cskilbeck/xtl/esp8266/controller_esp8266/README.md

# ESP8266 Wifi Christmas Tree Lights firmware

I2S for Neopixel driver

Simple websocket client for listening to Alexa/STUN server

Not much else going on in here, all the effects/settings are the same
