cskilbeck/xtl/pcbs/buck3/Outputs/2019-12-01 Rev2/Reports2/buck3.html

Altium

# Design Rule Verification Report

Date: | | 01/12/2019
Time: | | 17:42:27
Elapsed Time: | | 00:00:01
Filename: | | C:\Dev\wifi-lights\pcbs\buck3\buck3.PcbDoc

Warnings: | | 0
Rule Violations: | | 0

## Summary

Warnings | Count
Total | 0

Rule Violations | Count
Clearance Constraint (Gap=15.748mil) (InNet('24V') Or InNet('VOUT')),(InNet('24V') Or InNet('VOUT')) | 0
Clearance Constraint (Gap=5mil) (IsStitchingVia and InNet('SGND')),((IsVia and (Not IsStitchingVia)) Or IsPad) | 0
Modified Polygon (Allow modified: No), (Allow shelved: No) | 0
Net Antennae (Tolerance=0mil) (All) | 0
Silk to Silk (Clearance=0mil) (All),(All) | 0
Minimum Solder Mask Sliver (Gap=2mil) (All),(All) | 0
Hole To Hole Clearance (Gap=10mil) (All),(All) | 0
Hole Size Constraint (Min=11.811mil) (Max=100mil) (All) | 0
Pads and Vias to follow the Drill pairs settings | 0
Height Constraint (Min=0mil) (Max=1000mil) (Prefered=500mil) (All) | 0
Component Clearance Constraint ( Horizontal Gap = 10mil, Vertical Gap = Infinite ) (All),(All) | 0
Routing Via (Templates Used To Check Via: GND_STITCH, v50h30m0mx0, v50h30mx0, v60h40m0mx0) (All) | 0
Routing Layers(All) | 0
Width Constraint (Min=5mil) (Max=50mil) (Preferred=5mil) (All) | 0
Power Plane Connect Rule(Direct Connect )(Expansion=20mil) (Conductor Width=10mil) (Air Gap=10mil) (Entries=4) (All) | 0
Clearance Constraint (Gap=5mil) (All),(All) | 0
Un-Routed Net Constraint ( (All) ) | 0
Short-Circuit Constraint (Allowed=Yes) (InNet('GND')),(InNet('SGND')) | 0
Board Clearance Constraint (Gap=0mil) (All) | 0
Board Clearance Constraint (Gap=0mil) (OnLayer('Top Overlay') or OnLayer('Bottom Overlay')) | 0
Clearance Constraint (Gap=7.874mil) (InNet('SW') Or InNet('24V') Or InNet('VOUT') Or InNet('?DRV') Or InNet('GND') Or InNet('SGND')),(InNet('SW') Or InNet('GND') Or InNet('SGND') Or InNet('24V') Or InNet('VOUT') Or InNet('?DRV')) | 0
Minimum Annular Ring (Minimum=3mil) (All) | 0
Clearance Constraint (Gap=10mil) (InNet('HDRV') Or InNet('LDRV') Or InNet('SW')),(InNet('HDRV') Or InNet('LDRV') Or InNet('SW')) | 0
Clearance Constraint (Gap=5mil) (IsStitchingVia and InNet('GND')),((IsVia and (Not IsStitchingVia)) Or IsPad) | 0
Total | 0
