cskilbeck/xtl/pcbs/buck3/Outputs/2019-12-16 Rev2/Reports/buck3.html

Altium

# Design Rule Verification Report

Date: | | 16/12/2019
Time: | | 18:55:18
Elapsed Time: | | 00:00:01
Filename: | | C:\Dev\wifi-lights\pcbs\buck3\buck3.PcbDoc

Warnings: | | 0
Rule Violations: | | 0

## Summary

Warnings | Count
Total | 0

Rule Violations | Count
Clearance Constraint (Gap=0.4mm) (InNet('24V') Or InNet('VOUT')),(InNet('24V') Or InNet('VOUT')) | 0
Clearance Constraint (Gap=0.127mm) (IsStitchingVia and InNet('SGND')),((IsVia and (Not IsStitchingVia)) Or IsPad) | 0
Modified Polygon (Allow modified: No), (Allow shelved: No) | 0
Net Antennae (Tolerance=0mm) (All) | 0
Silk to Silk (Clearance=0mm) (All),(All) | 0
Minimum Solder Mask Sliver (Gap=0.051mm) (All),(All) | 0
Hole To Hole Clearance (Gap=0.254mm) (All),(All) | 0
Hole Size Constraint (Min=0.3mm) (Max=3mm) (All) | 0
Pads and Vias to follow the Drill pairs settings | 0
Height Constraint (Min=0mm) (Max=25.4mm) (Prefered=12.7mm) (All) | 0
Component Clearance Constraint ( Horizontal Gap = 0.254mm, Vertical Gap = Infinite ) (All),(All) | 0
Routing Via (MinHoleWidth=0.3mm) (MaxHoleWidth=1mm) (PreferredHoleWidth=0.3mm) (MinWidth=0.5mm) (MaxWidth=1mm) (PreferedWidth=0.5mm) (All) | 0
Routing Layers(All) | 0
Width Constraint (Min=0.127mm) (Max=1.27mm) (Preferred=0.127mm) (All) | 0
Power Plane Connect Rule(Direct Connect )(Expansion=0.508mm) (Conductor Width=0.254mm) (Air Gap=0.254mm) (Entries=4) (All) | 0
Clearance Constraint (Gap=0.127mm) (All),(All) | 0
Un-Routed Net Constraint ( (All) ) | 0
Short-Circuit Constraint (Allowed=Yes) (InComponentClass('gnd_ties')),(All) | 0
Board Clearance Constraint (Gap=0mm) (All) | 0
Board Clearance Constraint (Gap=0mm) (OnLayer('Top Overlay') or OnLayer('Bottom Overlay')) | 0
Clearance Constraint (Gap=0.18mm) (InNet('SW') Or InNet('24V') Or InNet('VOUT') Or InNet('?DRV') Or InNet('GND') Or InNet('SGND')),(InNet('SW') Or InNet('GND') Or InNet('SGND') Or InNet('24V') Or InNet('VOUT') Or InNet('?DRV')) | 0
Minimum Annular Ring (Minimum=0.076mm) (All) | 0
Clearance Constraint (Gap=0.254mm) (InNet('HDRV') Or InNet('LDRV') Or InNet('SW')),(InNet('HDRV') Or InNet('LDRV') Or InNet('SW')) | 0
Clearance Constraint (Gap=0.127mm) (IsStitchingVia and InNet('GND')),((IsVia and (Not IsStitchingVia)) Or IsPad) | 0
Clearance Constraint (Gap=0mm) (InComponentClass('gnd_ties')),(All) | 0
Total | 0
