cskilbeck/xtl/pcbs/buck4/Outputs/2020-06-03/back.png

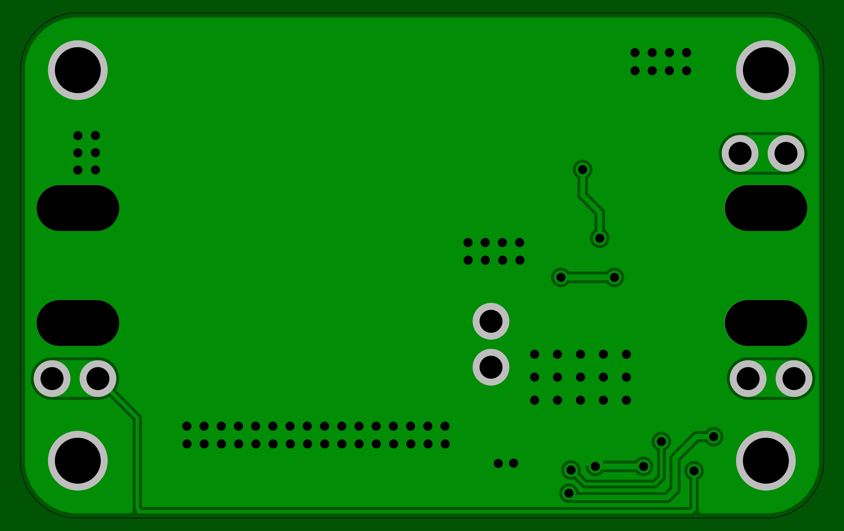
pcbs/buck4/Outputs/2020-06-03/back.png
