cskilbeck/xtl/pcbs/buck4/Outputs/2020-06-22/bottom.png

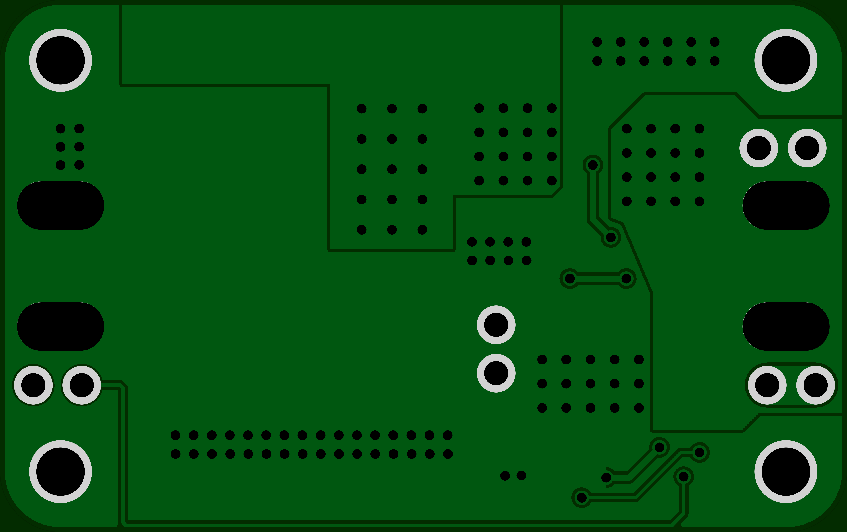
pcbs/buck4/Outputs/2020-06-22/bottom.png
