cskilbeck/xtl/pcbs/buck4/Outputs/2020-07-28/top.png

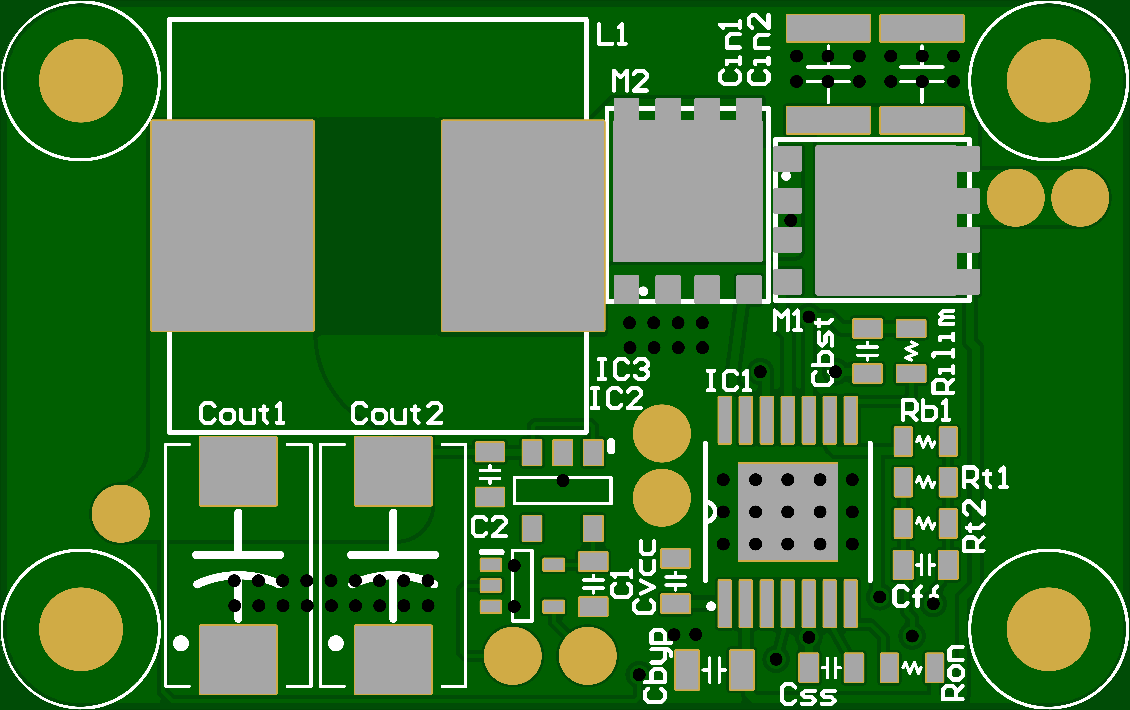
pcbs/buck4/Outputs/2020-07-28/top.png
