cskilbeck/xtl/pcbs/controller/ti_54328.png

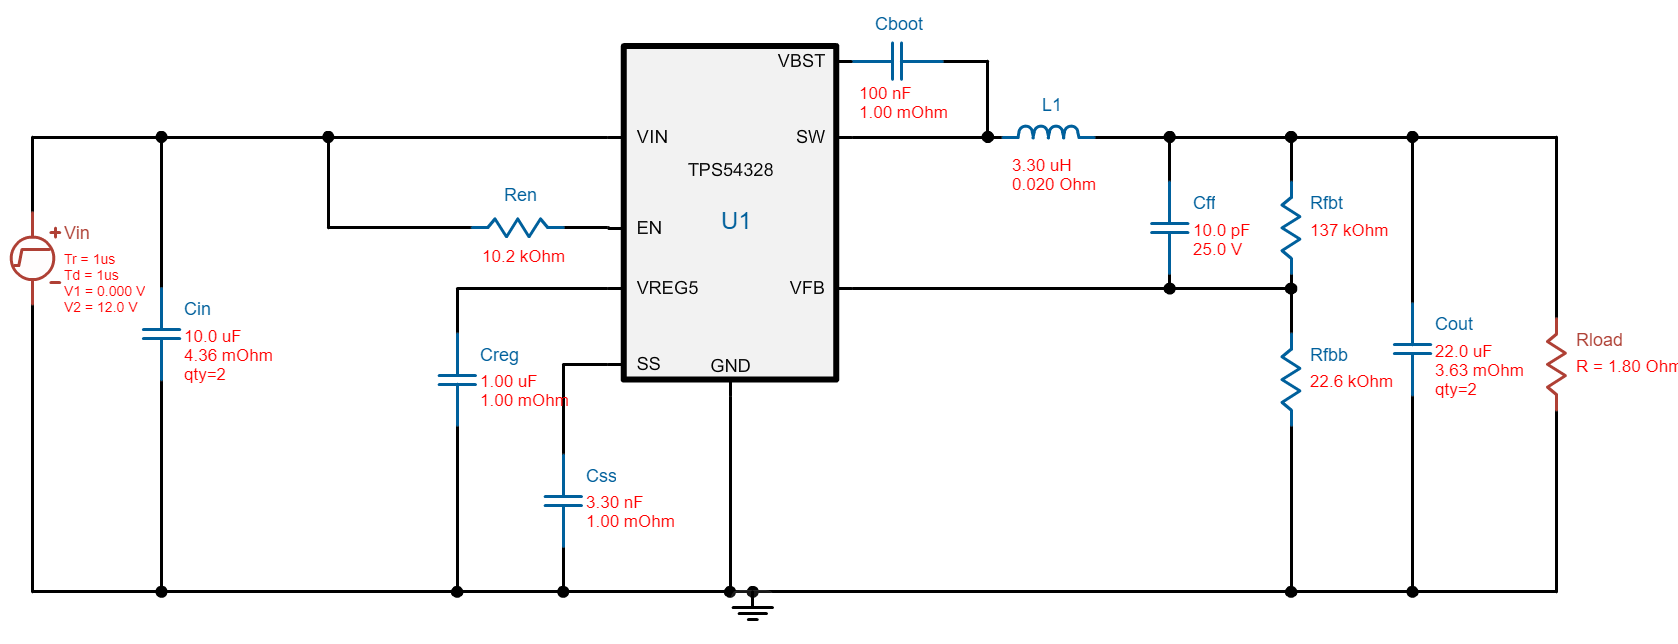
pcbs/controller/ti_54328.png
