cskilbeck/xtl/pcbs/controller_8266/Outputs/2020-08-14/top.png

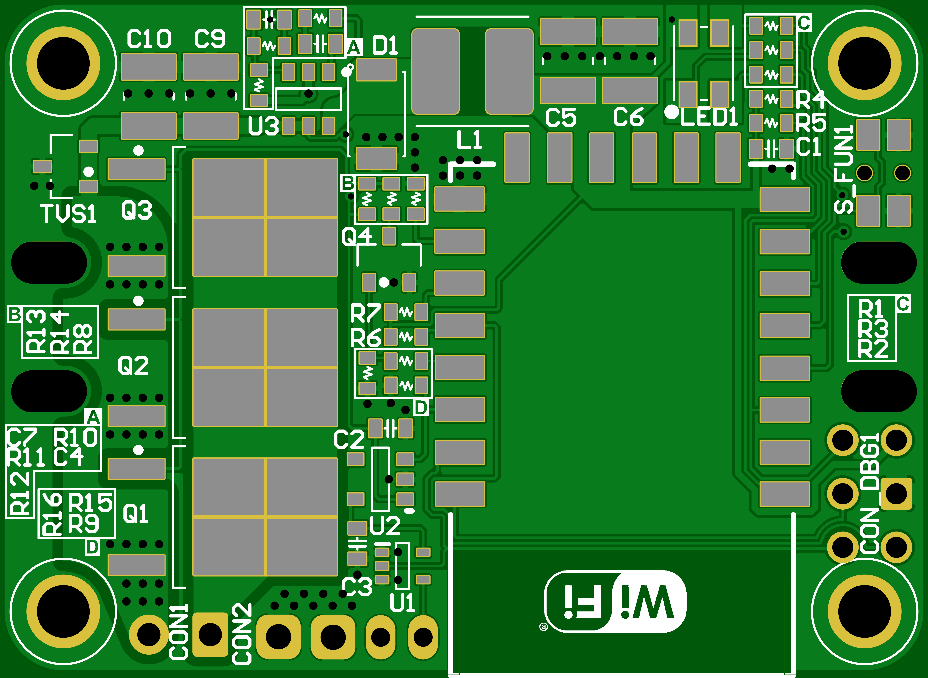
pcbs/controller_8266/Outputs/2020-08-14/top.png
