cskilbeck/xtl/pcbs/controller_8266/top.png

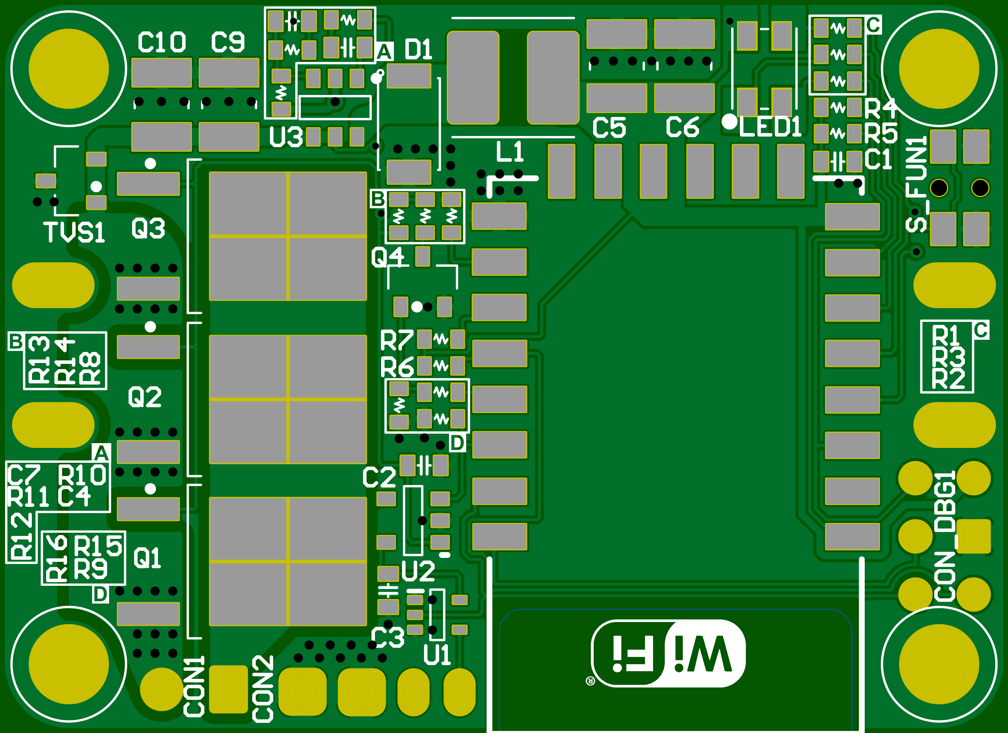
pcbs/controller_8266/top.png
