cskilbeck/xtl/pcbs/buck2/bom.xlsx

Part | Manufacturer | Part Number |  | Quantity | Price | Attribute 1 Name | Attribute 1 Value | Attribute 2 Name | Attribute 2 Value | Attribute 3 Name | Attribute 3 Value | Footprint
Cboot | MuRata | GRM155R71A104KA01D | x | 1 | 0.01 | Cap | 100nF | ESR | 1mOhm | Total Derated Cap | 1.0E-7F | 402 | 20
Ccomp | TDK | C2012C0G1H152K060AA | x | 1 | 0.027 | Cap | 1.5nF | ESR | 0Ohm | Total Derated Cap | 1.5E-9F | 805 | 20
Ccomp2 | Yageo | CC0201JRNPO8BN270 | x | 1 | 0.01 | Cap | 27pF | ESR | 0Ohm | Total Derated Cap | 2.7E-11F | 201 | 50
Cin | TDK | C3225X7R1H106M250AC | x | 2 | 0.571 | Cap | 10uF | ESR | 1mOhm | Total Derated Cap | 1.1E-5F | 1210 | 2
Cout | TDK | C3216X5R1A107M160AC | D | 2 | 0.628 | Cap | 100uF | ESR | 2.838mOhm | Total Derated Cap | 8.5E-5F | 1206_190 | 5
Css | MuRata | GRM033R71A822KA01D | x | 1 | 0.01 | Cap | 8.2nF | ESR | 1mOhm | Total Derated Cap | 8.2E-9F | 201 | 50
D1 | Comchip Technology | CDBC540-G | x | 1 | 0.245 | VFatIo | 0.55V | Io | 5A | VRRM | 40V | SMC | 1
L1 | Bourns | SDR1307-6R8ML | x | 1 | 0.345 | L | 6.8uH | DCR | 0.017Ohm | IDC | 6A | SDR1307 | 1
Rcomp | Yageo | RC0201FR-0744K2L |  | 1 | 0.01 | Resistance | 44.2kOhm | Tolerance | 1% | Power | 0.05W | 201 | 100
Rfbb | Vishay-Dale | CRCW08051K65FKEA |  | 1 | 0.01 | Resistance | 1.65kOhm | Tolerance | 1% | Power | 0.125W | 805 | 100
Rfbt | Vishay-Dale | CRCW060310K2FKEA |  | 1 | 0.01 | Resistance | 10.2kOhm | Tolerance | 1% | Power | 0.1W | 603 | 100
U1 | Texas Instruments | TPS54531DDAR | x | 1 | 0.75 |  |  |  |  |  |  | DDA0008E | 4
