cskilbeck/xtl/pcbs/controller_8266/Outputs/2024-12-30/Bill of Materials-controller_8266.xlsx

Designator | Quantity | Value | Name | Description | Footprint | Model:Footprint | LibRef
C1, C3 | 2 | 1uF | Cap | Capacitor | CAPC_0603_1608X08L | Chip Capacitor 0603 | Cap
C2, C33 | 2 | 100nF | Cap | Capacitor | CAPC_0603_1608X08L | Chip Capacitor 0603 | Cap
C37, C38, C40, C41 | 4 | 22uF | Cap | Capacitor | CAPC_1206_3216X16L | Chip Capacitor 1206 | Cap
C42 | 1 | 100pF | Cap | Capacitor | CAPC_0603_1608X08L | Chip Capacitor 0603 | Cap
D1 | 1 |  | Schottky 40V 3A | Schottky Diode | SOD123 | SOD123 | D Schottky
D2 | 1 |  | TVS | Schottky Diode | SODFL350X120-2L | SODFL, 2-Leads, Body 1.60x3.50mm, IPC High Density | D Zener
ESP1 | 1 |  | ESP8266 ESP-12-E | ESP8266 ESP-12-E | ESP8266 ESP-12-E | ESP8266 ESP-12-E | ESP8266 ESP-12-E
L2 | 1 | 15uH | Inductor | Inductor | INDP4949X30N | Precision Wire Wound Inductor, 2-Leads, Body 4.90x4.90mm, IPC Medium Density | Inductor
LED1 | 1 |  | RGB LED Common anode | Dot is _not_ anode! | PLCC-4 | LED | RGB_LED
Q1, Q2, Q3 | 3 |  | MOSFET-P |  | DPAK229P994X241-3L | D-PAK, 3-Pads, Body 6.21x6.73mm (max), IPC High Density | MOSFET-P
Q4 | 1 |  | MOSFET-N |  | SOT23 | SOT23, 3-Leads, Body 2.90x2.45mm, Pitch 0.95mm, IPC High Density | MOSFET-N
R1, R2, R3, R4, R5, R14 | 6 | 10K | Res2 | Resistor | RESC_0603_1608X08L | Chip Resistor, 2-Leads, Body 1.60x0.80mm, IPC High Density | Res2
R6, R7, R8, R9, R13 | 5 | 1K | Res2 | Resistor | RESC_0603_1608X08L | Chip Resistor, 2-Leads, Body 1.60x0.80mm, IPC High Density | Res2
R11 | 1 | 220K | Res2 | Resistor | RESC_0603_1608X08L | Chip Resistor, 2-Leads, Body 1.60x0.80mm, IPC High Density | Res2
R12 | 1 | 100K | Res2 | Resistor | RESC_0603_1608X08L | Chip Resistor, 2-Leads, Body 1.60x0.80mm, IPC High Density | Res2
R29 | 1 | 2.4K | Res2 | Resistor | RESC_0603_1608X08L | Chip Resistor, 2-Leads, Body 1.60x0.80mm, IPC High Density | Res2
R30 | 1 | 680R | Res2 | Resistor | RESC_0603_1608X08L | Chip Resistor, 2-Leads, Body 1.60x0.80mm, IPC High Density | Res2
S_FUN1 | 1 |  | 4-1437565-1 | Tactile switch | EVQP7C01P | Side actuated tactile switch | 4-1437565-1
U1 | 1 |  | M74VHC1GT125 | Level shifter non inverting | SOT95P285X130-5N | SOT23, 5-Leads, Body 3.00x2.85mm, Pitch 0.95mm, IPC Medium Density | M74VHC1GT125
U2 | 1 |  | AP7383-50W5 |  | SOT95P285X130-5N | SOT23, 5-Leads, Body 3.00x2.85mm, Pitch 0.95mm, IPC Medium Density | AP7383-50W5
U3 | 1 |  | BD9G101G-LB |  | TSOP95P280X125-6L | TSOP, 6-Leads, Body 2.90x1.65mm, Pitch 0.95mm, IPC High Density | BD9G102G-LB
