cskilbeck/xtl/pcbs/buck4/Outputs/2020-07-28/Bill of Materials-buck4 assembly.xlsx

Designator | Quantity | Value | Name | Footprint | Description | Voltage
C1, C2 | 2 | 1uF | MLCC | CAPC1608X08L | Multilayer Ceramic Capacitor | 16V
Cbst | 1 | 470nF | MLCC | CAPC1608X08L | Multilayer Ceramic Capacitor | 25V
Cbyp | 1 | 100nF | MLCC | CAPC2012X12L | Multilayer Ceramic Capacitor | 25V
Cff | 1 | 100pF | MLCC | CAPC1608X08L | Multilayer Ceramic Capacitor | 6.3V
Cin1, Cin2 | 2 | 47uF | MLCC | CAPC3225X25L | Multilayer Ceramic Capacitor | 25V
Cout1, Cout2 | 2 | 47uF | CAPACITOR | CAPMP7343X11L | Electrolytic Capacitor | 6.3V
Css | 1 | 68nF | MLCC | CAPC1608X08L | Multilayer Ceramic Capacitor | 25V
Cvcc | 1 | 2.2uF | MLCC | CAPC1608X08L | Multilayer Ceramic Capacitor | 16V
IC1 | 1 |  | LM3150MH/NOPB | MXA14A | Buck controller
IC2 | 1 |  | M74VHC1GT125 | SOT65P210X100-5L | Level shifter non inverting
IC3 | 1 |  | NCP551 | SOT95P260X90-5L | 5V LDO
L1 | 1 | 6.8uH | 744313330 | WE-HCI_1335 | Inductor
M1 | 1 |  | STL90N6F7 | TRANS_NexFET_Q5A | N Channel MOSFET
M2 | 1 |  | STL90N6F7 | TRANS_NexFET_Q5A | N Channel MOSFET
Rb1 | 1 | 10K | RES0603 | RESC1608X03L | Chip Resistor
RiLim | 1 | 2.21K | RES0603 | RESC1608X03L | Chip Resistor
Ron | 1 | 240k | RES0603 | RESC1608X03L | Chip Resistor
Rt1 | 1 | 91k | RES0603 | RESC1608X03L | Chip Resistor
Rt2 | 1 | 3M | RES0603 | RESC1608X03L | Chip Resistor
