cskilbeck/xtl/pcbs/buck3/Outputs/2019-06-22 Rev2/BOM/BOM-buck3.xlsx

Description | Designator | Quantity | Value | Footprint
Capacitor | C1, C2 | 2 | 330uF | CAPAE5252X59N
Capacitor | C3 | 1 | 6.8pF | CAPC 0603 1608X05L
Capacitor | C4, C7 | 2 | 100nF | CAPC 0603 1608X05L
Capacitor | C5 | 1 | 1.5pF | CAPC 0603 1608X05L
Capacitor | C6 | 1 | 3.3nF | CAPC 0603 1608X05L
Capacitor | C8 | 1 | 100pF | CAPC 0603 1608X05L
Capacitor | C9, C10 | 2 | 1uF | CAPC 0603 1608X05L
Capacitor | C11 | 1 | 68pF | CAPC 0603 1608X05L
Capacitor | C12, C13 | 2 | 22uF | CAPC 1210
Capacitor | C14, C15 | 2 | 4.7uF | CAPC 1210
Capacitor | C16 | 1 | 180uF | CAPAE5252X59N
Inductor | L1 | 1 | 6.8uH | INDUCTOR 8040
N Channel MOSFET | Q1, Q2 | 2 | Infineon BSC093N04LSGATMA1 | INF-PG-TDSON-8-1_V
Resistor | R1 | 1 | 92K | RESC 0603 1608X05L
Resistor | R2 | 1 | 1M | RESC 0603 1608X05L
Resistor | R3 | 1 | 1K | RESC 0603 1608X05L
Resistor | R4 | 1 | 57K | RESC 0603 1608X05L
Resistor | R5 | 1 | 11K | RESC 0603 1608X05L
Resistor | R6 | 1 | 24K | RESC 0603 1608X05L
Resistor | R7 | 1 | 15K | RESC 0603 1608X05L
Resistor | R8 | 1 | 110K | RESC 0603 1608X05L
Buck Controller | U1 | 1 | TPS40057 | TSOP65P640X120_HS-17N
