cskilbeck/xtl/pcbs/buck3/Outputs/2019-12-01 Rev2/Reports/BOM-buck3.xlsx

Description | Designator | Quantity | Value | Footprint
Capacitor | C2 | 1 | 470uF | CAPAE10083X104N
Capacitor | C3 | 1 | 180pF | CAPC 0603 1608X05L
Capacitor | C4, C7 | 2 | 100nF | CAPC 0603 1608X05L
Capacitor | C5 | 1 | 12pF | CAPC 0603 1608X05L
Capacitor | C6 | 1 | 3.3nF | CAPC 0603 1608X05L
Capacitor | C8 | 1 | 100pF | CAPC 0603 1608X05L
Capacitor | C9, C10 | 2 | 1uF | CAPC 0603 1608X05L
Capacitor | C11 | 1 | 150pF | CAPC 0603 1608X05L
Capacitor | C12, C13, C14, C15 | 4 | 22uF | CAPC 1210
Capacitor | C16 | 1 | 220uF | CAPAE10083X104N
Inductor | L1 | 1 | 6.8uH | INDP125125X80L
N Channel MOSFET | Q1, Q2 | 2 | Infineon BSC093N04LSGATMA1 | INF-PG-TDSON-8-1_V
Resistor | R1 | 1 | 170K | RESC 0603 1608X05L
Resistor | R2 | 1 | 110k | RESC 0603 1608X05L
Resistor | R3 | 1 | 1K | RESC 0603 1608X05L
Resistor | R4 | 1 | 57K | RESC 0603 1608X05L
Resistor | R5 | 1 | 11K | RESC 0603 1608X05L
Resistor | R6 | 1 | 8.2k | RESC 0603 1608X05L
Resistor | R7 | 1 | 16K | RESC 0603 1608X05L
Resistor | R8 | 1 | 120K | RESC 0603 1608X05L
Resistor | R9 | 1 | 2r0 | RESC 0603 1608X05L
Buck Controller | U1 | 1 | TPS40057 | TSOP65P640X120_HS-17N
