cskilbeck/xtl/pcbs/buck3/TPS40KType III Loop Stability kVenable_sluc263c-071312_test1_20171102.xls

Sheet: Instructions
Using this spreadsheet
 | This spreadsheet will help the engineer calculate the compensation network for a voltage mode continuous current non isolated buck converter using type III compensation network.
 | Getting Started:
1 | Ensure Tools => Add Ins => Analysis ToolPak is selected otherwise spreadsheet will not work
2 | Green Cells show where manually entered data is placed
3 | White cells are the calculated results
4 | Blue cells are the final results for the design and plots

Sheet: Input and Results
See "Instructions" sheet for details on using this spreadsheet. |  |  |  |  |  |  |  |  |  |  |  |  |  |  |  |  |  |  |  |  |  |  | Resistors |  |  |  | Capacitors
 |  |  |  |  |  |  |  |  |  |  |  |  |  |  |  |  | IC Parameters (from data sheet)
PSU Parameters |  |  |  |  | Calculated Zero's, Pole's, R's and C's: |  |  |  | Manually enter |  |  | Power Train Poles and Zeros |  |  |  |  | P/N | VRAMP | VREF | GBWP | DCGAIN |  | R_2 | 7035.177 | 715.00 | 7150 | C_1 | 177.460 | 1.80 | 180
VIN | 24 | V |  |  |  |  |  |  | R's & C's: | No |  | LC Double Pole | 6.937 | kHz |  |  |  | V | V | MHz | dB |  | R_3 | 117153.505 | 115.00 | 115000 | C_2 | 192.428 | 1.80 | 180
VOUT | 5.95 | V |  |  | Fz_1 | 7059.871315 Hz | R_1 | 120000 Ω | 120000 | W |  | Electrolytic ESR Zero | 78.02 | kHz |  |  | TPS40007 | 0.87 | 0.7 | 5 | 55 |  | R_bias | 16000.000 | 160.00 | 16000 | C_3 | 11.281 | 1.20 | 12
IOUT_max | 3 | A |  |  | Fz_2 | 7059.871315 Hz | R_2 | 7035.177498 Ω | 7000 | W |  | Ceramic ESR Zero | 11287.585 | kHz |  |  | TPS40009 | 0.87 | 0.7 | 5 | 55 |  |  |  |  |  | C values up to 10nF |  | 1.50
Fco | 30 | kHz |  |  | Fp_1 | 127481.0772 Hz | R_3 | 117153.5053 Ω | 115000 | W |  |  |  |  |  |  | TPS40021 | 0.87 | 0.7 | 5 | 55 |  | 100 | 105 | E24 |  | 1 | 1.2 | 2.20
Phase Margin | 60 | ° |  |  | Fp_2 | 127481.0772 Hz | R_bias | 16000 Ω | 16000 | W |  |  |  |  |  |  | TPS40040 | 0.87 | 0.6 | 5 | 55 |  | 105 | 110 | E48 |  | 1.2 | 1.5 | 1.00
Output Inductor |  |  |  |  | kVenable | 4.249 | C_1 | 177.4595386 pF | 180 | pF |  |  |  |  |  |  | TPS40041 | 0.87 | 0.6 | 5 | 55 |  | 110 | 115 |  |  | 1.5 | 1.8
LOUT | 6.8 | μH |  |  |  |  | C_2 | 192.4279083 pF | 180 | pF |  |  |  |  |  |  | TPS40055 | 5.61 | 0.7 | 3 | 60 |  | 115 | 120 |  |  | 1.8 | 2.2 | 1 | nF
DCR | 30 | mΩ |  |  |  |  | C_3 | 11.28137075 pF | 12 | pF |  |  |  |  |  |  | TPS40057 | 5.61 | 0.7 | 3 | 60 |  | 120 | 121 |  |  | 2.2 | 2.7 | 1 | nF
Output Electrolytic Capacitor |  |  | Qty: |  | Standard R and C values for final circuit. |  |  |  | Manually enter |  |  |  |  |  |  |  | TPS40075 | 10.652 | 0.7 | 5 | 50 |  | 121 | 127 |  |  | 2.7 | 3.3 | 1 | nF
COUT_ELEC | 68 | μF | 1 |  | R_1 | 120000 Ω |  |  | P's and Z's: | No |  |  |  |  |  |  | TPS40077 | 10.652 | 0.7 | 5 | 50 |  | 127 | 130 |  |  | 3.3 | 3.9
ESR_ELEC | 30 | mΩ |  |  | R_2 | 7150 Ω | Fz_1 | 6953.945169 Hz |  | Hz |  |  |  |  |  |  | TPS40101 | 0.5 | 0.696 | 3.5 | 60 |  | 130 | 133 |  |  | 3.9 | 4.7
Output Ceramic Capacitor |  |  | Qty: |  | R_3 | 115000 Ω | Fz_2 | 7688.644594 Hz |  | Hz |  |  |  |  |  |  | TPS40170 | 1.6 | 0.6 | 7 | 80 |  | 133 | 140 |  |  | 4.7 | 5.6
COUT_CER | 4.7 | μF | 2 |  | R_bias | 16000 Ω | Fp_1 | 123663.5144 Hz |  | Hz |  |  |  |  |  |  | TPS40190 | 0.75 | 0.591 | 5 | 60 |  | 140 | 147 |  |  | 5.6 | 6.8
ESR_CER | 3 | mΩ |  |  | C_1 | 180 pF | Fp_2 | 123018.3135 Hz |  | Hz |  |  |  |  |  |  | TPS40192 | 1 | 0.591 | 7 | 60 |  | 147 | 150 |  |  | 6.8 | 8.2
Select IC | TPS40057 |  |  |  | C_2 | 180 pF |  | Results |  |  |  |  |  |  |  |  | TPS40193 | 1 | 0.591 | 7 | 60 |  | 150 | 154 |  |  | 8.2 | 10
Enter for circuit parameters: |  |  |  |  | C_3 | 12 pF |  | FCO actual | 29161.45059 Hz |  |  |  |  |  |  |  | TPS40195 | 1 | 0.591 | 7 | 60 |  | 154 | 160 |  |  | C values greater than 10nF
RT | 170 | kΩ |  |  |  |  |  | Phase at FCO | 52.4° |  |  |  |  |  |  |  | TPS40200 | 2.4 | 0.696 | 1.5 | 60 |  | 160 | 162 | Nancy's Values |  | 1 | 1.5
RKFF | 57 | kΩ |  |  |  |  |  | Vout (nom) | 5.950 V |  |  |  |  |  |  |  | TPS40303 | 4 | 0.6 | 10 | 60 |  | 162 | 169 | 2000 |  | 1.5 | 2.2
For two-phase operation, choose LOUT = Lx/2, where Lx is the inducance per phase. |  |  |  |  |  |  |  |  |  |  |  |  |  |  |  |  | TPS40304 | 4 | 0.6 | 10 | 60 |  | 169 | 178 | 511 |  | 2.2 | 3.3
 |  |  |  |  |  |  |  |  |  |  |  |  |  |  |  |  | TPS40305 | 4 | 0.6 | 10 | 60 |  | 178 | 180 | 750 |  | 3.3 | 4.7
 |  |  |  |  |  |  |  |  |  |  |  |  |  |  |  |  | TPS40322 | 2.945 | 0.6 | 24 | 80 |  | 180 | 187 | 3010 |  | 4.7 | 6.8
 |  |  |  |  |  |  |  |  |  |  |  |  |  |  |  |  | TPS40400 | 3.754 | 0.6 | 15 | 60 |  | 187 | 196 | 4700 |  | 6.8 | 10
 |  |  |  |  |  |  |  |  |  |  |  |  |  |  |  |  | TPS40422 | 2.927 | 0.6 | 24 | 80 |  | 196 | 200 | 82000
 |  |  |  |  |  |  |  |  |  |  |  |  |  |  |  |  | TPS51113 | 1.5 | 0.8 | 16 | 89 |  | 200 | 205 | 2.2
 |  |  |  |  |  |  |  |  |  |  |  |  |  |  |  |  | TPS5130 | 0.816 | 0.85 | 2.5 | 50 |  | 205 | 215
 |  |  |  |  |  |  |  |  |  |  |  |  |  |  |  |  | TPS53311 | 6 | 0.6 | 14 | 80 |  | 215 | 220
 |  |  |  |  |  |  |  |  |  |  |  |  |  |  |  |  | TPS56121 | 4 | 0.6 | 24 | 60 |  | 220 | 226
 |  |  |  |  |  |  |  |  |  |  |  |  |  |  |  |  | TPS56221 | 4 | 0.6 | 24 | 60 |  | 226 | 237
 |  |  |  |  |  |  |  |  |  |  |  |  |  |  |  |  | TPS53316 | 6 | 0.6 | 14 | 80 |  | 237 | 240
 |  |  |  |  |  |  |  |  |  |  |  |  |  |  |  |  | TPS53313 | 2.666666667 | 0.6 | 14 | 80 |  | 240 | 249
 |  |  |  |  |  |  |  |  |  |  |  |  |  |  |  |  |  |  |  |  |  |  | 249 | 261
 |  |  |  |  |  |  |  |  |  |  |  |  |  |  |  |  |  |  |  |  |  |  | 261 | 270
 |  |  |  |  |  |  |  |  |  |  |  |  |  |  |  |  |  |  |  |  |  |  | 270 | 274
 |  |  |  |  |  |  |  |  |  |  |  |  |  |  |  |  |  | TPS5130 Ramp calculations |  |  |  |  | 274 | 287
 |  |  |  |  |  |  |  |  |  |  |  |  |  |  |  |  | dVagc | I1max | I1min |  |  |  | 287 | 300
 |  |  |  |  |  |  |  |  |  |  |  |  |  |  |  |  | 0.1566666667 | 2.700447633e-05 | 3.7e-06 |  |  |  | 300 | 301
 |  |  |  |  |  |  |  |  |  |  |  |  |  |  |  |  |  |  |  |  |  |  | 301 | 316
 |  |  |  |  |  |  |  |  |  |  |  |  |  |  |  |  |  |  |  |  |  |  | 316 | 330
 |  |  |  |  |  |  |  |  |  |  |  |  |  |  |  |  |  |  |  |  |  |  | 330 | 332
fsw = |  |  |  |  |  |  |  |  |  |  |  |  |  |  |  |  |  |  |  |  |  |  | 332 | 348
RT |  |  |  |  |  |  |  |  |  |  |  |  |  |  |  |  |  |  |  |  |  |  | 348 | 360
RKFF |  |  |  |  |  |  |  |  |  |  |  |  |  |  |  |  |  |  |  |  |  |  | 360 | 365
COUT_ELEC | 68 | w |  |  | 183226.7979 |  |  |  |  |  |  |  |  |  |  |  |  |  |  |  |  |  | 365 | 383
ESR_ELEC | 30 | GCO_FCO |  |  | -11.374 |  | 0.025351514032545-0.0698187301782095i |  |  |  |  |  |  |  |  |  |  |  |  |  |  |  | 383 | 390
 |  | PHCO_FCO |  |  | -157.35 |  | -11.37401127 |  |  |  |  |  |  |  |  |  |  |  |  |  |  |  | 390 | 402
COUT_CER | 9.4 | EA_Gain dB |  |  | 11.373 | 95696.7734138544-51110.4976351279i | 12841.493242665-25553.4057916615i | -3.21492275080824-1.83941825744746i |  |  |  |  |  |  |  |  |  |  |  |  |  |  | 402 | 422
ESR_CER | 1.5 | EA_Phase |  |  | 209.8 |  |  |  |  |  |  |  |  |  |  |  |  |  |  |  |  |  | 422 | 430
Error Amp pole | 10 | GBWP limit |  |  | 40.2 |  |  |  |  |  |  |  |  |  |  |  |  |  |  |  |  |  | 430 | 442
 |  | No |  |  |  |  |  |  |  |  |  |  |  |  |  |  |  |  |  |  |  |  | 442 | 464
 |  | Yes |  |  |  |  |  |  |  |  |  |  |  |  |  |  |  |  |  |  |  |  | 464 | 470
 |  | ROUT_min |  |  | 1.98 | Ohms |  |  |  |  |  |  |  |  |  |  |  |  |  |  |  |  | 470 | 487
 |  | wCO |  |  | 188495.5592 |  |  |  |  |  |  |  |  |  |  |  |  |  |  |  |  |  | 487 | 510
 |  | GCO_FCO |  |  | 0.255 |  |  |  |  |  |  |  |  |  |  |  |  |  |  |  |  |  | 510 | 511
 |  | PHCO_FCO |  |  | -157.030 |  |  |  |  |  |  |  |  |  |  |  |  |  |  |  |  |  | 511 | 536
 |  | GCOMP_FCO |  |  | 3.919 |  |  |  |  |  |  |  |  |  |  |  |  |  |  |  |  |  | 536 | 560
 |  | Z2(s) |  |  | 0.0252156073550844-0.0679290921150391i |  |  |  |  |  |  |  |  |  |  |  |  |  |  |  |  |  | 560 | 562
 |  | Z1(s) |  |  | 0.03+1.28176980266464i |  |  |  |  |  |  |  |  |  |  |  |  |  |  |  |  |  | 562 | 590
 |  | X_LC |  |  | -0.0549035600773368-0.0232708793873961i |  |  |  |  |  |  |  |  |  |  |  |  |  |  |  |  |  | 590 | 619
 |  | VIN/VRMP |  |  | 4.279246957 |  |  |  |  |  |  |  |  |  |  |  |  |  |  |  |  |  | 619 | 620
 |  |  |  |  |  |  |  |  |  |  |  |  |  |  |  |  |  |  |  |  |  |  | 620 | 649
 |  |  |  |  |  |  |  |  |  |  |  |  |  |  |  |  |  |  |  |  |  |  | 649 | 680
 | Override IC Parameters | No |  |  |  |  |  |  |  |  |  |  |  |  |  |  |  |  |  |  |  |  | 680 | 681
VRAMP | 5.61 V | 1.50 V | V |  |  |  |  |  |  |  |  |  |  |  |  |  |  |  |  |  |  |  | 681 | 715
VREF | 0.7 V | 0.7 | V |  |  |  |  |  |  |  |  |  |  |  |  |  |  |  |  |  |  |  | 715 | 750
GBWP | 3 MHz | 5 | Mhz |  |  |  |  |  |  |  |  |  |  |  |  |  |  |  |  |  |  |  | 750 | 787
DC Gain | 60 dB | 50 | dB |  |  |  |  |  |  |  |  |  |  |  |  |  |  |  |  |  |  |  | 787 | 820
 |  |  |  |  |  |  |  |  |  |  |  |  |  |  |  |  |  |  |  |  |  |  | 820 | 825
 |  |  |  |  |  |  |  |  |  |  |  |  |  |  |  |  |  |  |  |  |  |  | 825 | 866
 |  |  |  |  |  |  |  |  |  |  |  |  |  |  |  |  |  |  |  |  |  |  | 866 | 909
 |  |  | 0.117 |  |  | Phase |  |  |  |  |  |  |  |  |  |  |  |  |  |  |  |  | 909 | 910
 |  |  | 28840.31503 |  | 0.11657 | 52.3602 |  | 0.48481 |  |  |  |  |  |  |  |  |  |  |  |  |  |  | 910 | 953
 |  |  | 30199.5172 |  | -0.3682 | 52.6074 |  | 0.0048 | 0.0594 |  |  |  |  |  |  |  |  |  |  |  |  |  | 953 | 1000
 |  | FCO | 29161.45059 |  |  | 52.4196
 |  |  | OVERALL SYSTEM |  |  |  | FILTER |  |  |  |  |  |  |  |  |  |  | PWM GAIN and FILTER |  | ERROR AMPLIFIER
 |  |  | SYS_Gain (f) dB | SYS_Phase (f) |  |  |  |  |  |  |  |  |  |  |  |  |  |  | Numerator 1 | EA_Gain(f) dB | EA_Phase f) | GBWP limit | GBWP Phase | Xea_ol(f) | X1(f)
 |  | f |  |  |  |  | ZC1(s) | ZC2(s) | ZC(s) |  | Z2(s) | Z1(s) | X_LC | GFILT_DBMAG(f) | GFILT_PH(f) | w |  | GCO_DBMAG(f)
53.777 | 1 | 10 | 53.777 | 170.190 |  |  | 0.03-234.051386899846i | 0.0015-1693.13769246697i | 0.0231777837812215-205.626541817888i |  | 1.98314668105404-0.0191280588413588i | 0.03+0.000427256600888212i | 0.985101213358176-0.000350633100977188i | -0.1304 | -0.0204 | 62.83185307 | 1 | 12.497 | 1+0.00143803262125419i | 41.28 | 170.2104897 | 59.99995175 | -0.19 | 999.988885678048-3.33429628559349i | -1326291192.43246i
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

Sheet: Sheet1
 | 100 | 544.17
 | 120 | 450.64
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
