cskilbeck/xtl/pcbs/buck3/TPS40KType III Loop Stability kVenable_sluc263c-071312_test1_20171102.xlsm

Sheet: Input and Results
See "Instructions" sheet for details on using this spreadsheet. |  |  |  |  |  |  |  |  |  |  |  |  |  |  |  |  |  |  |  |  |  |  | Resistors |  |  |  | Capacitors
 |  |  |  |  |  |  |  |  |  |  |  |  |  |  |  |  | IC Parameters (from data sheet)
PSU Parameters |  |  |  |  | Calculated Zero's, Pole's, R's and C's: |  |  |  | Manually enter |  |  | Power Train Poles and Zeros |  |  |  |  | P/N | VRAMP | VREF | GBWP | DCGAIN |  | R_2 | 5809.795 | 590.00 | 5900 | C_1 | 122.715 | 1.20 | 120
VIN | 24 | V |  |  |  |  |  |  | R's & C's: | Yes |  | LC Double Pole | 5.392 | kHz |  |  |  | V | V | MHz | dB |  | R_3 | 64067.814 | 649.00 | 64900 | C_2 | 221.821 | 2.20 | 220
VOUT | 5.513 | V |  |  | Fz_1 | 11198.96146 Hz | R_1 | 110000 Ω | 110000 | W |  | Electrolytic ESR Zero | 1.45 | kHz |  |  | TPS40007 | 0.87 | 0.7 | 5 | 55 |  | R_bias | 15998.338 | 160.00 | 16000 | C_3 | 11.716 | 1.20 | 12
IOUT_max | 4 | A |  |  | Fz_2 | 11198.96146 Hz | R_2 | 5809.794658 Ω | 5900 | W |  | Ceramic ESR Zero | 361.716 | kHz |  |  | TPS40009 | 0.87 | 0.7 | 5 | 55 |  |  |  |  |  | C values up to 10nF |  | 1.00
Fco | 50 | kHz |  |  | Fp_1 | 223234.9856 Hz | R_3 | 64067.81442 Ω | 64900 | W |  |  |  |  |  |  | TPS40021 | 0.87 | 0.7 | 5 | 55 |  | 100 | 105 | E24 |  | 1 | 1.2 | 2.20
Phase Margin | 60 | ° |  |  | Fp_2 | 223234.9856 Hz | R_bias | 15998.33784 Ω | 16000 | W |  |  |  |  |  |  | TPS40040 | 0.87 | 0.6 | 5 | 55 |  | 105 | 110 | E48 |  | 1.2 | 1.5 | 1.00
Output Inductor |  |  |  |  | kVenable | 4.465 | C_1 | 122.7148413 pF | 120 | pF |  |  |  |  |  |  | TPS40041 | 0.87 | 0.6 | 5 | 55 |  | 110 | 115 |  |  | 1.5 | 1.8
LOUT | 3.3 | μH |  |  |  |  | C_2 | 221.820905 pF | 220 | pF |  |  |  |  |  |  | TPS40055 | 4.24 | 0.7 | 3 | 60 |  | 115 | 120 |  |  | 1.8 | 2.2 | 1 | nF
DCR | 9 | mΩ |  |  |  |  | C_3 | 11.71576281 pF | 12 | pF |  |  |  |  |  |  | TPS40057 | 4.24 | 0.7 | 3 | 60 |  | 120 | 121 |  |  | 2.2 | 2.7 | 1 | nF
Output Electrolytic Capacitor |  |  | Qty: |  | Standard R and C values for final circuit. |  |  |  | Manually enter |  |  |  |  |  |  |  | TPS40075 | 6.564 | 0.7 | 5 | 50 |  | 121 | 127 |  |  | 2.7 | 3.3 | 1 | nF
COUT_ELEC | 220 | μF | 1 |  | R_1 | 110000 Ω |  |  | P's and Z's: | No |  |  |  |  |  |  | TPS40077 | 6.564 | 0.7 | 5 | 50 |  | 127 | 130 |  |  | 3.3 | 3.9
ESR_ELEC | 500 | mΩ |  |  | R_2 | 5900 Ω | Fz_1 | 11443.40977 Hz |  | Hz |  |  |  |  |  |  | TPS40101 | 0.5 | 0.696 | 3.5 | 60 |  | 130 | 133 |  |  | 3.9 | 4.7
Output Ceramic Capacitor |  |  | Qty: |  | R_3 | 64900 Ω | Fz_2 | 11146.86532 Hz |  | Hz |  |  |  |  |  |  | TPS40170 | 1.6 | 0.6 | 7 | 80 |  | 133 | 140 |  |  | 4.7 | 5.6
COUT_CER | 22 | μF | 2 |  | R_bias | 16000 Ω | Fp_1 | 224795.1174 Hz |  | Hz |  |  |  |  |  |  | TPS40190 | 0.75 | 0.591 | 5 | 60 |  | 140 | 147 |  |  | 5.6 | 6.8
ESR_CER | 20 | mΩ |  |  | C_1 | 120 pF | Fp_2 | 215506.0629 Hz |  | Hz |  |  |  |  |  |  | TPS40192 | 1 | 0.591 | 7 | 60 |  | 147 | 150 |  |  | 6.8 | 8.2
Select IC | TPS40057 |  |  |  | C_2 | 220 pF |  | Results |  |  |  |  |  |  |  |  | TPS40193 | 1 | 0.591 | 7 | 60 |  | 150 | 154 |  |  | 8.2 | 10
Enter for circuit parameters: |  |  |  |  | C_3 | 12 pF |  | FCO actual | 49045.32214 Hz |  |  |  |  |  |  |  | TPS40195 | 1 | 0.591 | 7 | 60 |  | 154 | 160 |  |  | C values greater than 10nF
RT | 100 | kΩ |  |  |  |  |  | Phase at FCO | 53.7° |  |  |  |  |  |  |  | TPS40200 | 2.4 | 0.696 | 1.5 | 60 |  | 160 | 162 | Nancy's Values |  | 1 | 1.5
RKFF | 56 | kΩ |  |  |  |  |  | Vout (nom) | 5.513 V |  |  |  |  |  |  |  | TPS40303 | 4 | 0.6 | 10 | 60 |  | 162 | 169 | 2000 |  | 1.5 | 2.2
For two-phase operation, choose LOUT = Lx/2, where Lx is the inducance per phase. |  |  |  |  |  |  |  |  |  |  |  |  |  |  |  |  | TPS40304 | 4 | 0.6 | 10 | 60 |  | 169 | 178 | 511 |  | 2.2 | 3.3
 |  |  |  |  |  |  |  |  |  |  |  |  |  |  |  |  | TPS40305 | 4 | 0.6 | 10 | 60 |  | 178 | 180 | 750 |  | 3.3 | 4.7
 |  |  |  |  |  |  |  |  |  |  |  |  |  |  |  |  | TPS40322 | 2.945 | 0.6 | 24 | 80 |  | 180 | 187 | 3010 |  | 4.7 | 6.8
 |  |  |  |  |  |  |  |  |  |  |  |  |  |  |  |  | TPS40400 | 3.804 | 0.6 | 15 | 60 |  | 187 | 196 | 4700 |  | 6.8 | 10
 |  |  |  |  |  |  |  |  |  |  |  |  |  |  |  |  | TPS40422 | 2.927 | 0.6 | 24 | 80 |  | 196 | 200 | 82000
 |  |  |  |  |  |  |  |  |  |  |  |  |  |  |  |  | TPS51113 | 1.5 | 0.8 | 16 | 89 |  | 200 | 205 | 2.2
 |  |  |  |  |  |  |  |  |  |  |  |  |  |  |  |  | TPS5130 | 0.816 | 0.85 | 2.5 | 50 |  | 205 | 215
 |  |  |  |  |  |  |  |  |  |  |  |  |  |  |  |  | TPS53311 | 6 | 0.6 | 14 | 80 |  | 215 | 220
 |  |  |  |  |  |  |  |  |  |  |  |  |  |  |  |  | TPS56121 | 4 | 0.6 | 24 | 60 |  | 220 | 226
 |  |  |  |  |  |  |  |  |  |  |  |  |  |  |  |  | TPS56221 | 4 | 0.6 | 24 | 60 |  | 226 | 237
 |  |  |  |  |  |  |  |  |  |  |  |  |  |  |  |  | TPS53316 | 6 | 0.6 | 14 | 80 |  | 237 | 240
 |  |  |  |  |  |  |  |  |  |  |  |  |  |  |  |  | TPS53313 | 2.666666667 | 0.6 | 14 | 80 |  | 240 | 249
 |  |  |  |  |  |  |  |  |  |  |  |  |  |  |  |  |  |  |  |  |  |  | 249 | 261
 |  |  |  |  |  |  |  |  |  |  |  |  |  |  |  |  |  |  |  |  |  |  | 261 | 270
 |  |  |  |  |  |  |  |  |  |  |  |  |  |  |  |  |  |  |  |  |  |  | 270 | 274
 |  |  |  |  |  |  |  |  |  |  |  |  |  |  |  |  |  | TPS5130 Ramp calculations |  |  |  |  | 274 | 287
 |  |  |  |  |  |  |  |  |  |  |  |  |  |  |  |  | dVagc | I1max | I1min |  |  |  | 287 | 300
 |  |  |  |  |  |  |  |  |  |  |  |  |  |  |  |  | 0.1566666667 | 2.700447633e-05 | 3.7e-06 |  |  |  | 300 | 301
 |  |  |  |  |  |  |  |  |  |  |  |  |  |  |  |  |  |  |  |  |  |  | 301 | 316
 |  |  |  |  |  |  |  |  |  |  |  |  |  |  |  |  |  |  |  |  |  |  | 316 | 330
 |  |  |  |  |  |  |  |  |  |  |  |  |  |  |  |  |  |  |  |  |  |  | 330 | 332
fsw = |  |  |  |  |  |  |  |  |  |  |  |  |  |  |  |  |  |  |  |  |  |  | 332 | 348
RT |  |  |  |  |  |  |  |  |  |  |  |  |  |  |  |  |  |  |  |  |  |  | 348 | 360
RKFF |  |  |  |  |  |  |  |  |  |  |  |  |  |  |  |  |  |  |  |  |  |  | 360 | 365
COUT_ELEC | 220 | w |  |  | 308160.8474 |  |  |  |  |  |  |  |  |  |  |  |  |  |  |  |  |  | 365 | 383
ESR_ELEC | 500 | GCO_FCO |  |  | -7.507 |  | 0.0227186606645468-0.0670820392406119i |  |  |  |  |  |  |  |  |  |  |  |  |  |  |  | 383 | 390
 |  | PHCO_FCO |  |  | -159.38 |  | -7.507281282 |  |  |  |  |  |  |  |  |  |  |  |  |  |  |  | 390 | 402
COUT_CER | 44 | EA_Gain dB |  |  | 7.507 | 55486.0181923284-26614.9459202144i | 10989.7434538651-23101.3863871956i | -1.98875957028253-1.29502045775993i |  |  |  |  |  |  |  |  |  |  |  |  |  |  | 402 | 422
ESR_CER | 10 | EA_Phase |  |  | 213.1 |  |  |  |  |  |  |  |  |  |  |  |  |  |  |  |  |  | 422 | 430
Error Amp pole | 10 | GBWP limit |  |  | 35.7 |  |  |  |  |  |  |  |  |  |  |  |  |  |  |  |  |  | 430 | 442
 |  | No |  |  |  |  |  |  |  |  |  |  |  |  |  |  |  |  |  |  |  |  | 442 | 464
 |  | Yes |  |  |  |  |  |  |  |  |  |  |  |  |  |  |  |  |  |  |  |  | 464 | 470
 |  | ROUT_min |  |  | 1.38 | Ohms |  |  |  |  |  |  |  |  |  |  |  |  |  |  |  |  | 470 | 487
 |  | wCO |  |  | 314159.2654 |  |  |  |  |  |  |  |  |  |  |  |  |  |  |  |  |  | 487 | 510
 |  | GCO_FCO |  |  | 0.405 |  |  |  |  |  |  |  |  |  |  |  |  |  |  |  |  |  | 510 | 511
 |  | PHCO_FCO |  |  | -159.501 |  |  |  |  |  |  |  |  |  |  |  |  |  |  |  |  |  | 511 | 536
 |  | GCOMP_FCO |  |  | 2.470 |  |  |  |  |  |  |  |  |  |  |  |  |  |  |  |  |  | 536 | 560
 |  | Z2(s) |  |  | 0.0222488720266824-0.0659010303470088i |  |  |  |  |  |  |  |  |  |  |  |  |  |  |  |  |  | 560 | 562
 |  | Z1(s) |  |  | 0.009+1.03672557568463i |  |  |  |  |  |  |  |  |  |  |  |  |  |  |  |  |  | 562 | 590
 |  | X_LC |  |  | -0.0670743428467607-0.0250764875069246i |  |  |  |  |  |  |  |  |  |  |  |  |  |  |  |  |  | 590 | 619
 |  | VIN/VRMP |  |  | 5.653894325 |  |  |  |  |  |  |  |  |  |  |  |  |  |  |  |  |  | 619 | 620
 |  |  |  |  |  |  |  |  |  |  |  |  |  |  |  |  |  |  |  |  |  |  | 620 | 649
 |  |  |  |  |  |  |  |  |  |  |  |  |  |  |  |  |  |  |  |  |  |  | 649 | 680
 | Override IC Parameters | No |  |  |  |  |  |  |  |  |  |  |  |  |  |  |  |  |  |  |  |  | 680 | 681
VRAMP | 4.24 V | 1.50 V | V |  |  |  |  |  |  |  |  |  |  |  |  |  |  |  |  |  |  |  | 681 | 715
VREF | 0.7 V | 0.7 | V |  |  |  |  |  |  |  |  |  |  |  |  |  |  |  |  |  |  |  | 715 | 750
GBWP | 3 MHz | 5 | Mhz |  |  |  |  |  |  |  |  |  |  |  |  |  |  |  |  |  |  |  | 750 | 787
DC Gain | 60 dB | 50 | dB |  |  |  |  |  |  |  |  |  |  |  |  |  |  |  |  |  |  |  | 787 | 820
 |  |  |  |  |  |  |  |  |  |  |  |  |  |  |  |  |  |  |  |  |  |  | 820 | 825
 |  |  |  |  |  |  |  |  |  |  |  |  |  |  |  |  |  |  |  |  |  |  | 825 | 866
 |  |  |  |  |  |  |  |  |  |  |  |  |  |  |  |  |  |  |  |  |  |  | 866 | 909
 |  |  | 0.237 |  |  | Phase |  |  |  |  |  |  |  |  |  |  |  |  |  |  |  |  | 909 | 910
 |  |  | 50118.72336 |  | -0.23680 | 53.4052 |  | -0.50370 |  |  |  |  |  |  |  |  |  |  |  |  |  |  | 910 | 953
 |  |  | 47863.00923 |  | 0.2669 | 54.0021 |  | 0.0094 | 0.2806 |  |  |  |  |  |  |  |  |  |  |  |  |  | 953 | 1000
 |  | FCO | 49045.32214 |  |  | 53.6858
 |  |  | OVERALL SYSTEM |  |  |  | FILTER |  |  |  |  |  |  |  |  |  |  | PWM GAIN and FILTER |  | ERROR AMPLIFIER
 |  |  | SYS_Gain (f) dB | SYS_Phase (f) |  |  |  |  |  |  |  |  |  |  |  |  |  |  | Numerator 1 | EA_Gain(f) dB | EA_Phase f) | GBWP limit | GBWP Phase | Xea_ol(f) | X1(f)
 |  | f |  |  |  |  | ZC1(s) | ZC2(s) | ZC(s) |  | Z2(s) | Z1(s) | X_LC | GFILT_DBMAG(f) | GFILT_PH(f) | w |  | GCO_DBMAG(f)
56.881 | 1 | 10 | 56.881 | 168.323 |  |  | 0.5-72.3431559508615i | 0.01-361.715779754307i | 0.347499533804188-60.286360069753i |  | 1.37734876114304-0.031483369501272i | 0.009+0.000207345115136926i | 0.993514801848525-0.000295868068820692i | -0.0565 | -0.0171 | 62.83185307 | 1 | 14.990 | 1+0.000873865412522537i | 41.89 | 168.3402436 | 59.99995175 | -0.19 | 999.988885678048-3.33429628559349i | -1326291192.43246i
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
