cskilbeck/xtl/enclosure/export/top..STEP

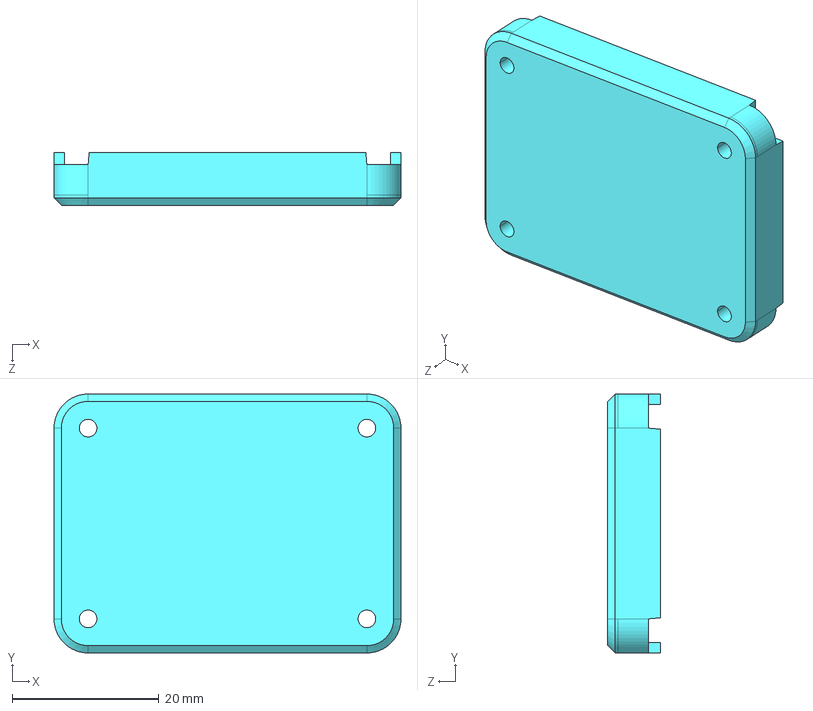
[picture p8: CAD file, 2024-12-22]
enclosure/export/top..STEP
47.3 x 35.3 x 7.16 mm
