cskilbeck/xtl/pcbs/buck3/Outputs/2019-06-22 Rev2/ExportSTEP/buck3.step

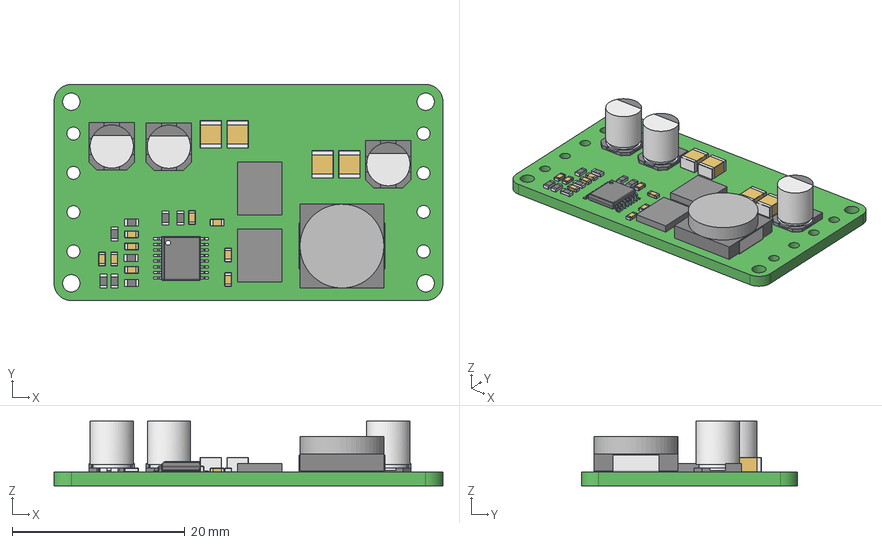
[picture p9: CAD file, 2020-04-20]
pcbs/buck3/Outputs/2019-06-22 Rev2/ExportSTEP/buck3.step
45.0 x 25.0 x 7.50 mm
Board
Open_CASCADE_STEP_translator_6.8_2.1
Open_CASCADE_STEP_translator_6.8_2.2.1 x 21
Leader x 16
Mid_Body x 8
Mark x 8
Extruded x 2
Open_CASCADE_STEP_translator_6.8_3.3.1 x 2
Open_CASCADE_STEP_translator_6.8_4.1.1 x 3
Open_CASCADE_STEP_translator_6.8_4.2.1 x 3
Open_CASCADE_STEP_translator_6.8_4.3.1 x 3
lead x 6
Open_CASCADE_STEP_translator_6.8_2.1.1 x 4
Open_CASCADE_STEP_translator_6.8_2.1.2 x 4
Open_CASCADE_STEP_translator_6.8_6.1.1 x 9
Open_CASCADE_STEP_translator_6.8_6.1.2 x 9
Open_CASCADE_STEP_translator_6.8_6.2.1 x 9
