cskilbeck/xtl/pcbs/buck3/Outputs/2019-12-01 Rev2/Reports/buck3.step

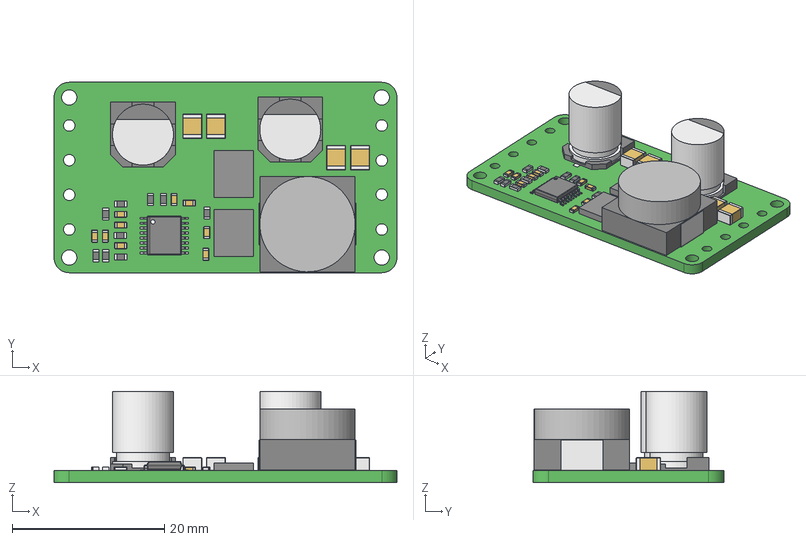
[picture p10: CAD file, 2020-04-20]
pcbs/buck3/Outputs/2019-12-01 Rev2/Reports/buck3.step
45.0 x 25.0 x 12.0 mm
Board
Mid_Body x 9
Open_CASCADE_STEP_translator_6.8_2.2.1 x 23
Mark x 9
Open_CASCADE_STEP_translator_6.8_2.1
Leader x 16
Extruded x 2
Open_CASCADE_STEP_translator_6.8_2.3.1 x 2
Open_CASCADE_STEP_translator_6.8_18.1.1 x 2
Open_CASCADE_STEP_translator_6.8_18.2.1 x 2
Open_CASCADE_STEP_translator_6.8_18.3.1 x 2
lead x 4
Open_CASCADE_STEP_translator_6.8_2.1.1 x 4
Open_CASCADE_STEP_translator_6.8_2.1.2 x 4
Open_CASCADE_STEP_translator_6.8_6.1.1 x 9
Open_CASCADE_STEP_translator_6.8_6.1.2 x 9
Open_CASCADE_STEP_translator_6.8_6.2.1 x 9
