cskilbeck/xtl/pcbs/buck3/Outputs/2019-12-16 Rev2/Gerbers/buck3.step

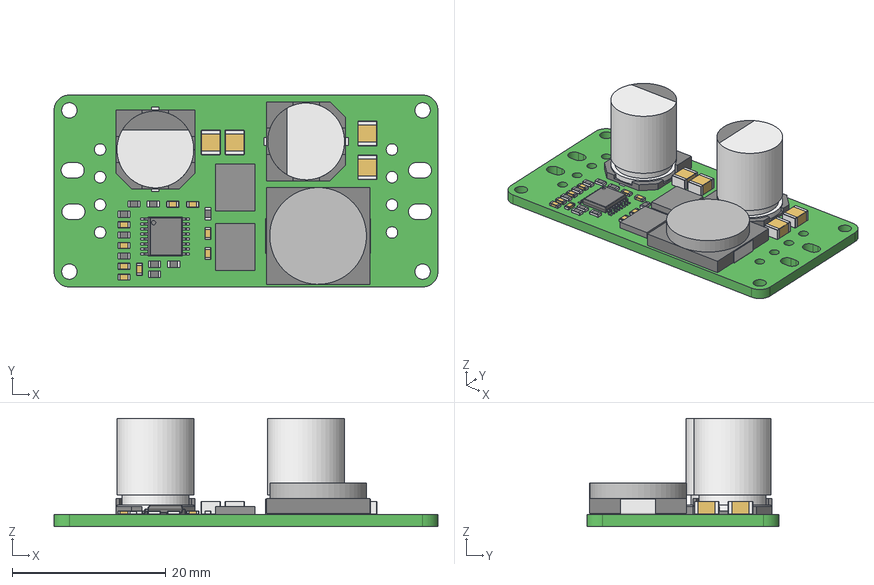
[picture p11: CAD file, 2020-04-20]
pcbs/buck3/Outputs/2019-12-16 Rev2/Gerbers/buck3.step
50.0 x 25.0 x 14.1 mm
Board
Open_CASCADE_STEP_translator_6.8_6.1.1 x 11
Open_CASCADE_STEP_translator_6.8_6.2.1 x 11
Open_CASCADE_STEP_translator_6.8_6.3.1 x 2
lead x 4
Mid_Body x 9
Open_CASCADE_STEP_translator_6.8_2.2.1 x 23
Mark x 9
Open_CASCADE_STEP_translator_6.8_2.1
Leader x 16
Extruded x 2
Open_CASCADE_STEP_translator_6.8_3.3.1 x 2
Open_CASCADE_STEP_translator_6.8_2.1.1 x 4
Open_CASCADE_STEP_translator_6.8_2.1.2 x 4
Open_CASCADE_STEP_translator_6.8_6.1.2 x 9
