cskilbeck/xtl/pcbs/buck4/1206.stp

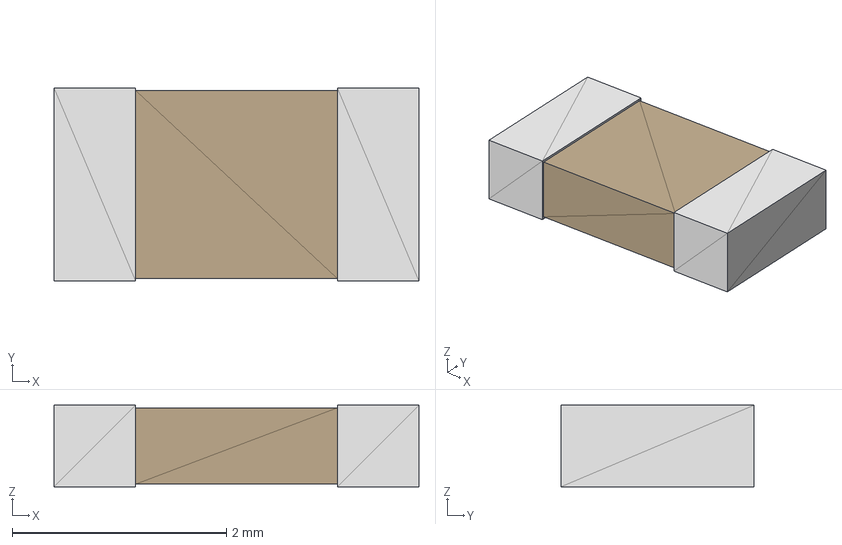
[picture p12: CAD file, 2020-06-03]
pcbs/buck4/1206.stp
3.40 x 1.80 x 0.762 mm
