cskilbeck/xtl/pcbs/buck4/Outputs/2020-06-03/buck4.step

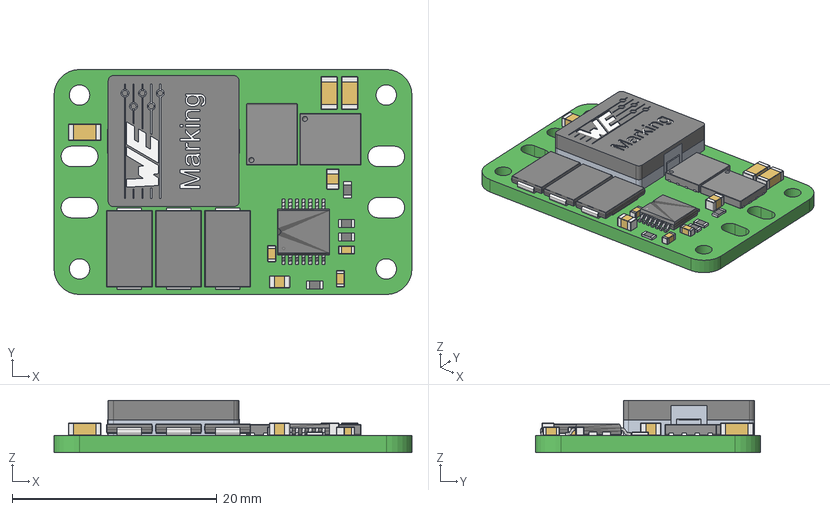
[picture p13: CAD file, 2020-06-03]
pcbs/buck4/Outputs/2020-06-03/buck4.step
35.0 x 22.0 x 5.09 mm
Mid_Body x 4
Open_CASCADE_STEP_translator_6.8_9.2.1 x 8
Mark x 4
Gehäuse
Spule
Boden
Klebemasse x 2
Open_CASCADE_STEP_translator_6.8_15.1.1 x 6
Open_CASCADE_STEP_translator_6.8_15.1.2 x 3
Open_CASCADE_STEP_translator_6.8_15.2.1 x 3
Lead x 6
Open_CASCADE_STEP_translator_6.8_1.1.1 x 3
Open_CASCADE_STEP_translator_6.8_1.1.2 x 3
Open_CASCADE_STEP_translator_6.8_1.2.1 x 3
Open_CASCADE_STEP_translator_6.8_13.1.1 x 2
Open_CASCADE_STEP_translator_6.8_13.1.2 x 2
Open_CASCADE_STEP_translator_6.8_13.2.1 x 2
