cskilbeck/xtl/pcbs/Led RGB 5mm.step

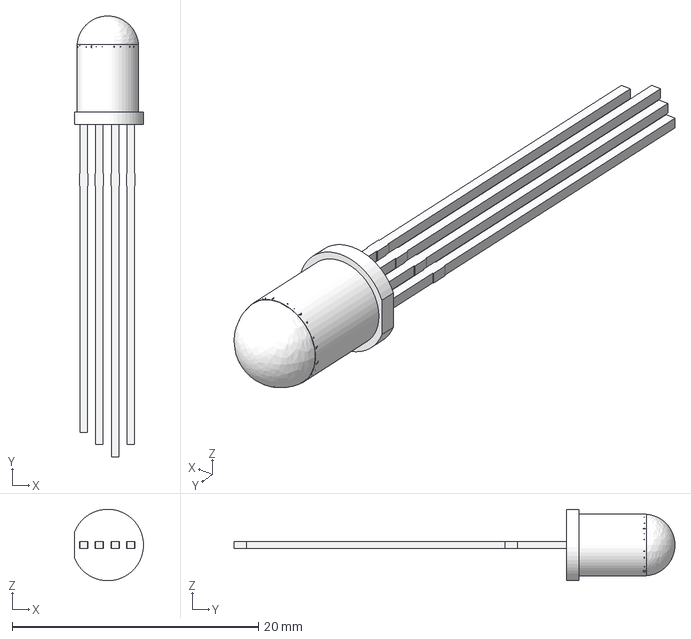
[picture p15: CAD file, 2020-04-20]
pcbs/Led RGB 5mm.step
5.59 x 35.8 x 5.80 mm
