cskilbeck/xtl/enclosure/export/bottom.STEP

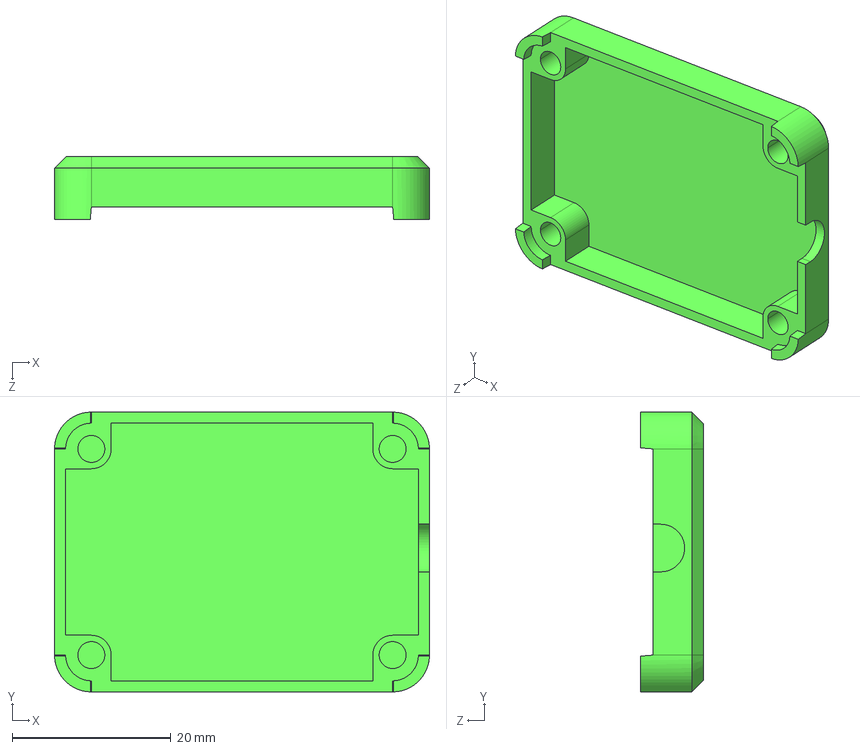
[picture p16: CAD file, 2024-12-22]
enclosure/export/bottom.STEP
47.3 x 35.3 x 7.99 mm
