cskilbeck/xtl/enclosure/threaded_insert_m2x4x3.5.SLDPRT

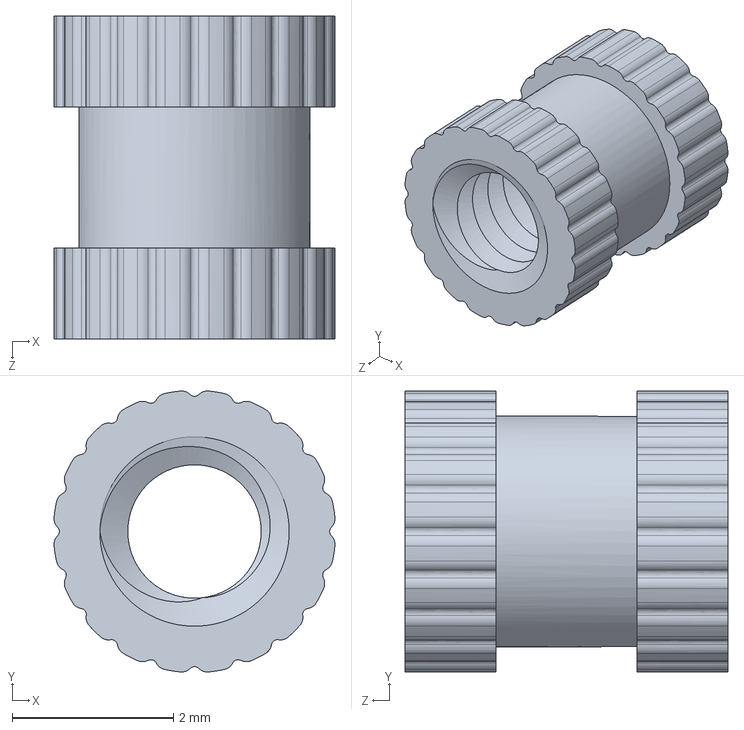
[picture p17: CAD file, 2024-12-22]
enclosure/threaded_insert_m2x4x3.5.SLDPRT
3.48 x 3.48 x 4.00 mm
