cskilbeck/xtl/pcbs/buck4/0805.stp

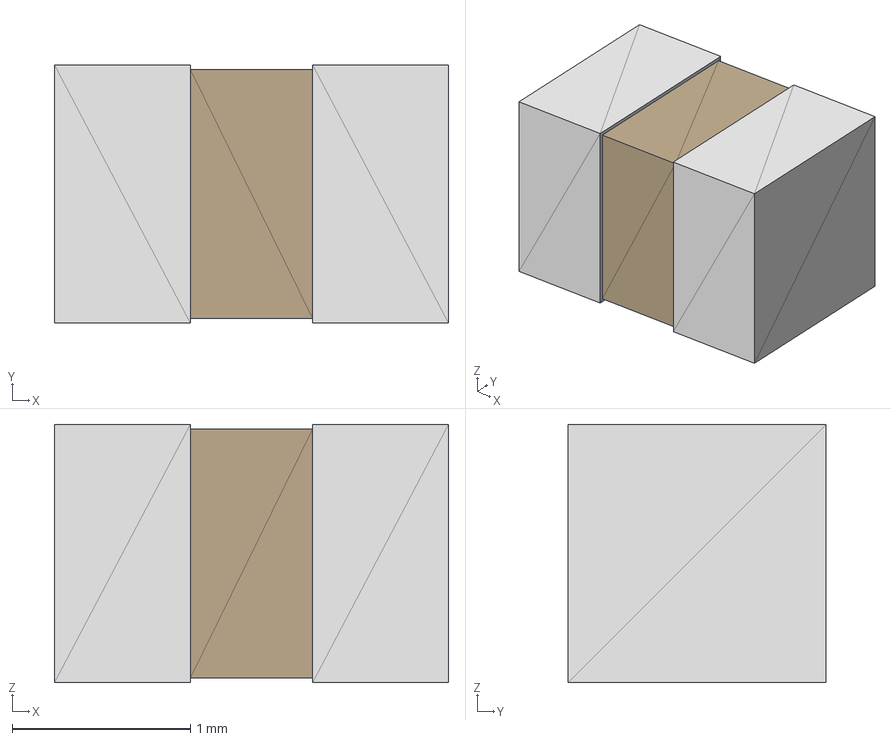
[picture p18: CAD file, 2020-06-03]
pcbs/buck4/0805.stp
2.21 x 1.45 x 1.45 mm
