cskilbeck/xtl/pcbs/PL9823_5MM.step

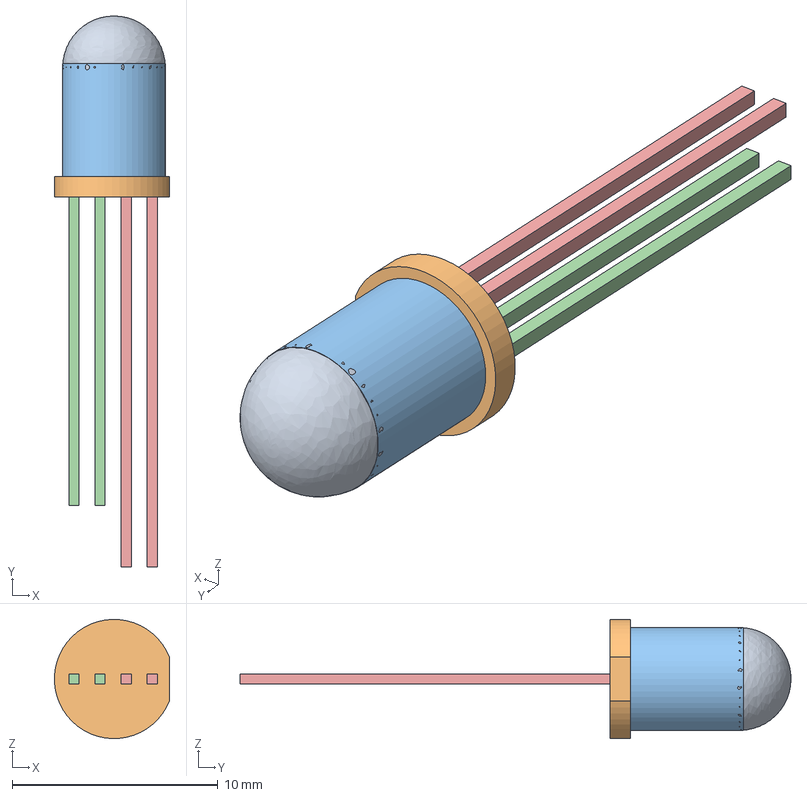
[picture p19: CAD file, 2020-04-20]
pcbs/PL9823_5MM.step
5.59 x 26.8 x 5.80 mm
