cskilbeck/xtl/pcbs/buck4/MXA14A.stp

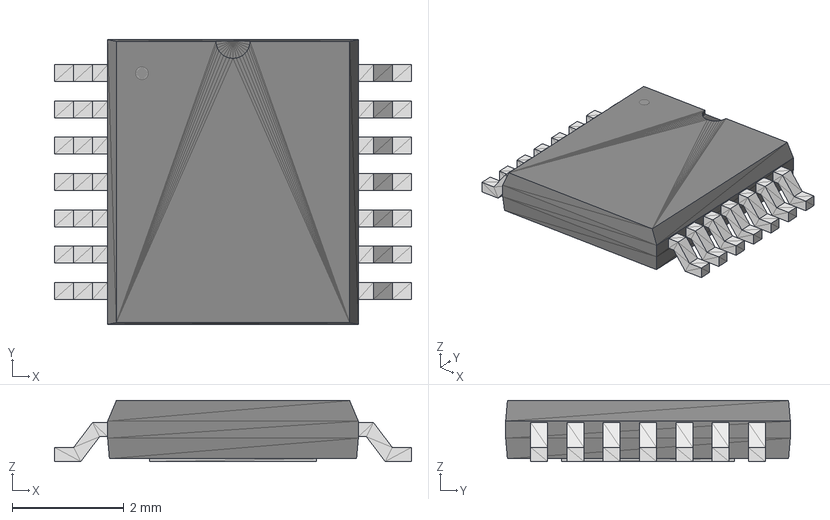
[picture p20: CAD file, 2020-06-03]
pcbs/buck4/MXA14A.stp
6.40 x 5.11 x 1.09 mm
