cskilbeck/xtl/pcbs/PL9823.step

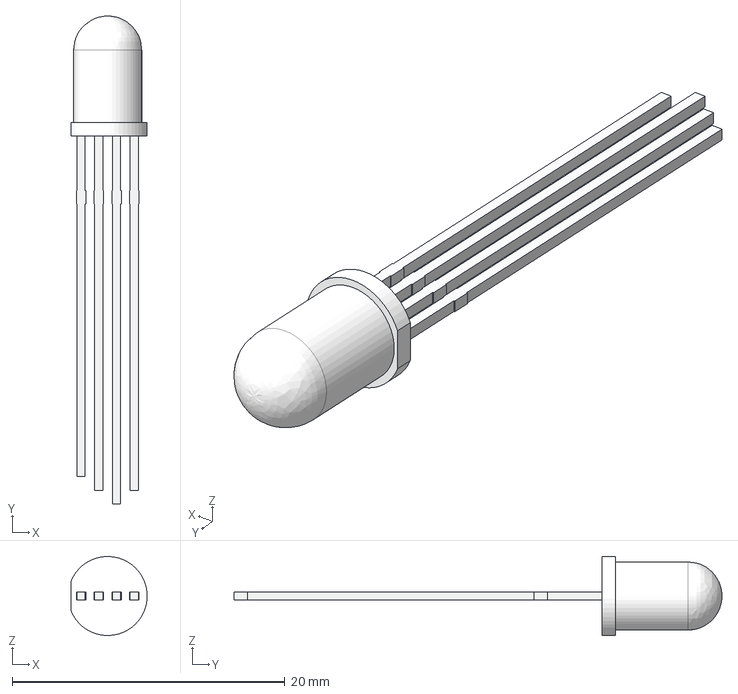
[picture p21: CAD file, 2020-04-20]
pcbs/PL9823.step
5.59 x 35.8 x 5.80 mm
