cskilbeck/xtl/enclosure/M2 x10mm_countersunk.step

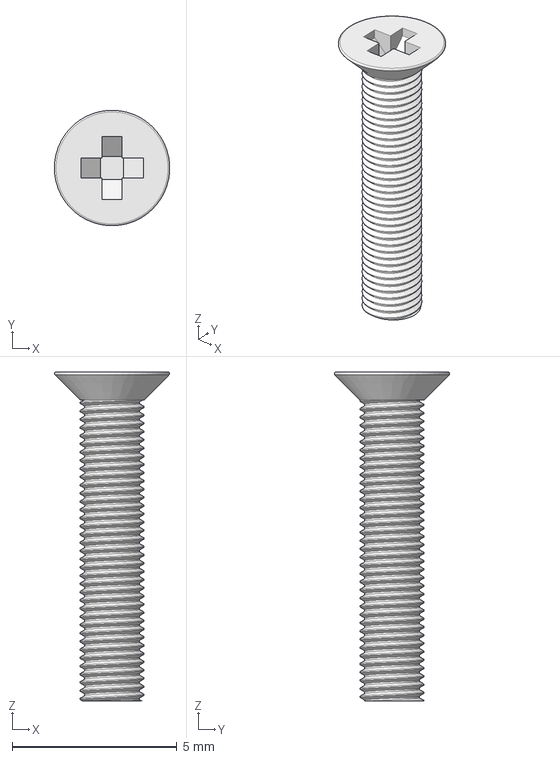
[picture p22: CAD file, 2024-12-22]
enclosure/M2 x10mm_countersunk.step
3.51 x 3.51 x 10.0 mm
