cskilbeck/xtl/pcbs/buck4/7343-15.stp

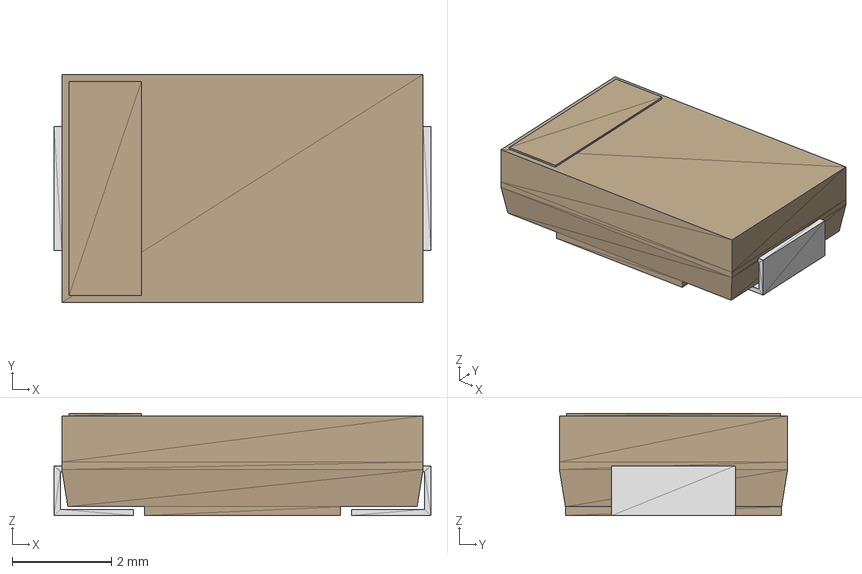
[picture p23: CAD file, 2020-06-03]
pcbs/buck4/7343-15.stp
7.59 x 4.60 x 2.06 mm
