cskilbeck/xtl/pcbs/buck4/SRP1235.stp

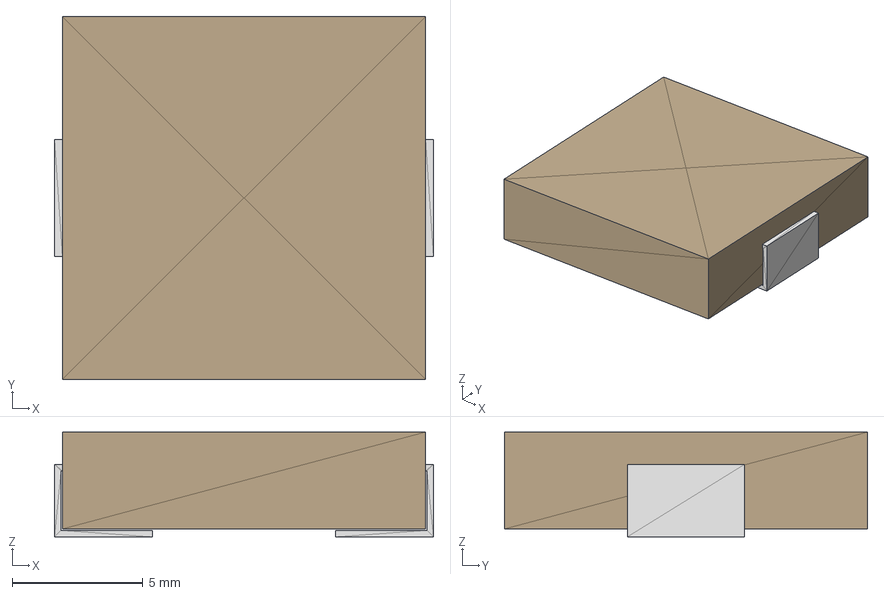
[picture p24: CAD file, 2020-06-03]
pcbs/buck4/SRP1235.stp
14.5 x 13.9 x 4.01 mm
