cskilbeck/xtl/enclosure/enclosure.SLDASM

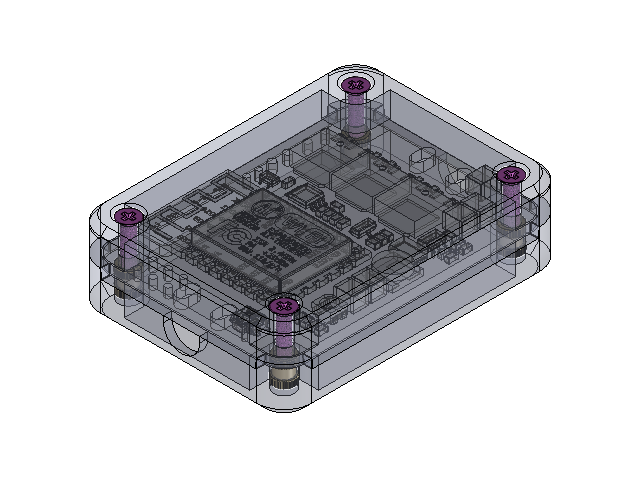
[picture p25: CAD file, 2024-12-22]
enclosure/enclosure.SLDASM
controller_8266
case
threaded_insert_m2x4x3.5 x 4
m2 x10mm_countersunk x 4
