cskilbeck/xtl/(list of files, cad)

Other CAD files:
enclosure/case.SLDPRT
pcbs/buck4/Outputs/2020-07-28/buck4.step
enclosure/M2x0.4mm+12mmSCREW.STEP
enclosure/M2x12mm_countersunk.step
enclosure/m2 x10mm_countersunk.SLDPRT
enclosure/m2x12.SLDPRT
enclosure/m2x12mm_countersunk.SLDPRT
pcbs/buck4/Outputs/2020-07-17/buck4.step
