cskilbeck/xtl/buck2_characterisation.xlsx

Sheet: Sheet1
V_out | 5.8
V_in_max | 24
K_ind | 0.3
I_out | 2.4
F_sw | 570000
Inductor | 0.0000107172 | 10.71718648

Sheet: Sheet2
V_in | I_in | W_in | V_out | I_out | W_out | Eff
24.02 | 0.031 | 0.7446 | 5.749 | 0.10 | 0.5749 | 77.21%
24.02 | 0.058 | 1.3932 | 5.733 | 0.20 | 1.1466 | 82.30%
24.01 | 0.083 | 1.9928 | 5.733 | 0.29 | 1.6626 | 83.43%
24.02 | 0.111 | 2.6662 | 5.707 | 0.40 | 2.2828 | 85.62%
24.01 | 0.140 | 3.3614 | 5.695 | 0.50 | 2.8475 | 84.71%
24.00 | 0.168 | 4.0320 | 5.680 | 0.59 | 3.3512 | 83.12%
24.00 | 0.198 | 4.7520 | 5.676 | 0.70 | 3.9732 | 83.61%
23.99 | 0.232 | 5.5657 | 5.666 | 0.80 | 4.5328 | 81.44%
23.98 | 0.258 | 6.1868 | 5.657 | 0.89 | 5.0347 | 81.38%
23.97 | 0.292 | 6.9992 | 5.650 | 1.00 | 5.6500 | 80.72%
23.98 | 0.322 | 7.7216 | 5.634 | 1.10 | 6.1974 | 80.26%
23.96 | 0.349 | 8.3620 | 5.626 | 1.19 | 6.6949 | 80.06%
23.94 | 0.392 | 9.3845 | 5.621 | 1.29 | 7.2511 | 77.27%
23.95 | 0.422 | 10.1069 | 5.608 | 1.40 | 7.8512 | 77.68%
23.94 | 0.459 | 10.9885 | 5.596 | 1.50 | 8.3940 | 76.39%
23.93 | 0.493 | 11.7975 | 5.586 | 1.61 | 8.9935 | 76.23%
23.93 | 0.530 | 12.6829 | 5.573 | 1.70 | 9.4741 | 74.70%
23.92 | 0.565 | 13.5148 | 5.568 | 1.80 | 10.0224 | 74.16%
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
