cskilbeck/xtl/pcbs/controller_8266/Outputs/2024-12-30/controller_8266.PDF

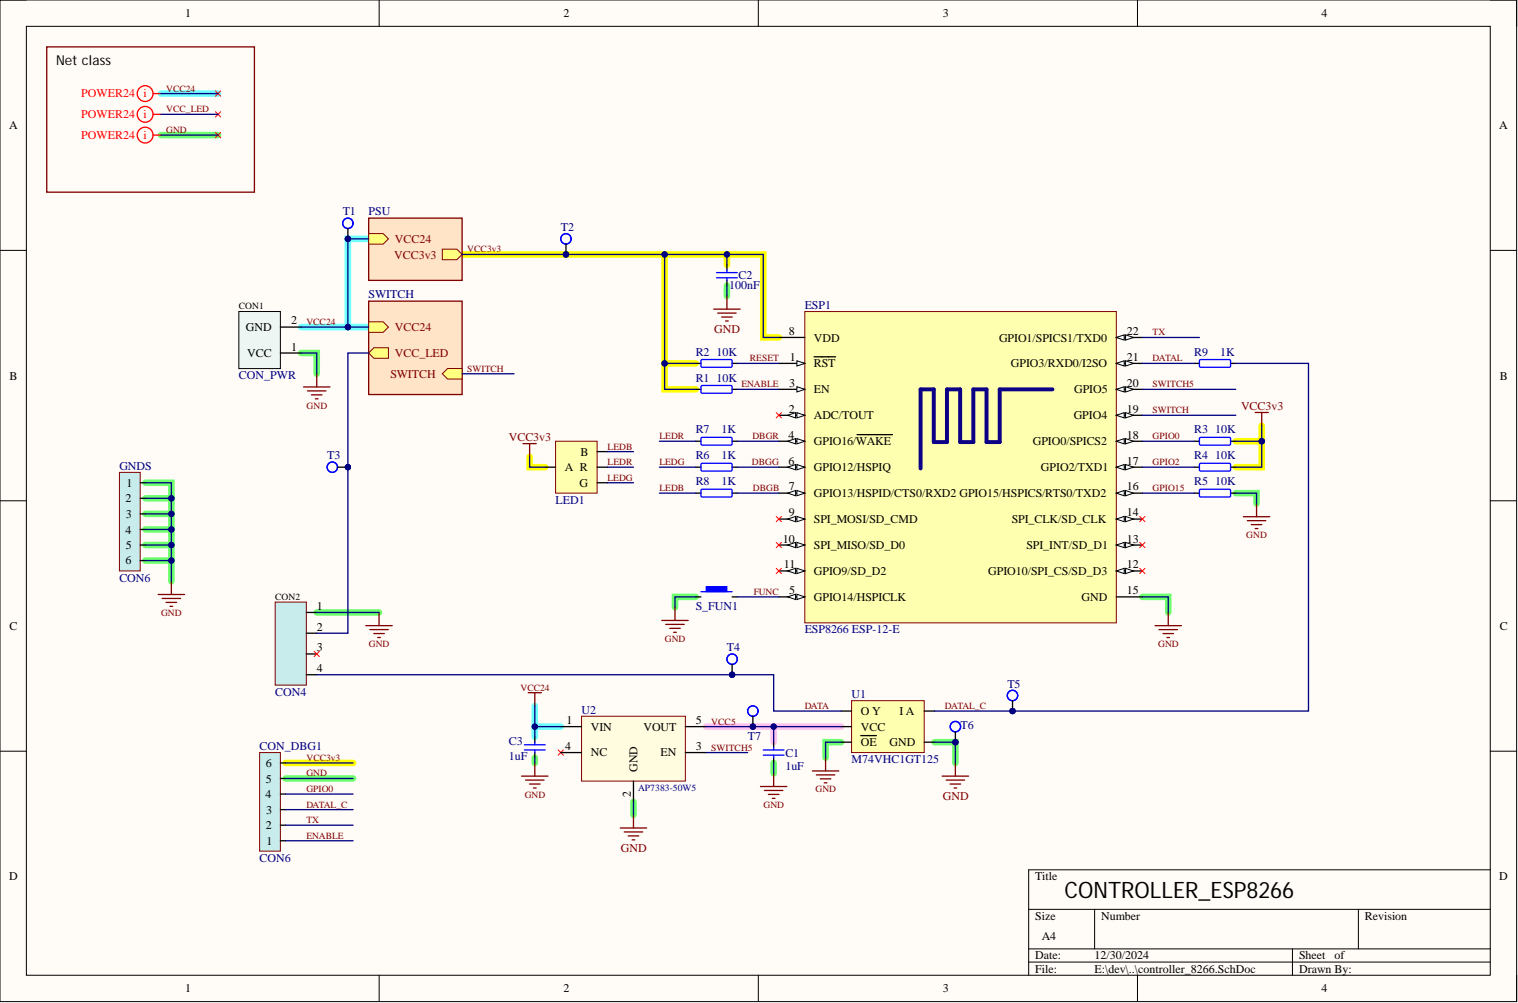
[picture p37: page 1]


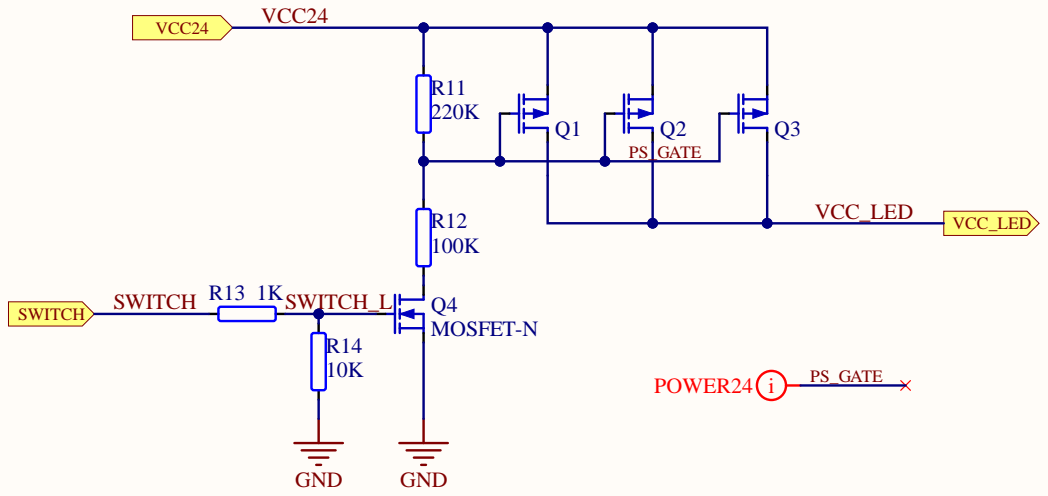
[picture p38: page 3]

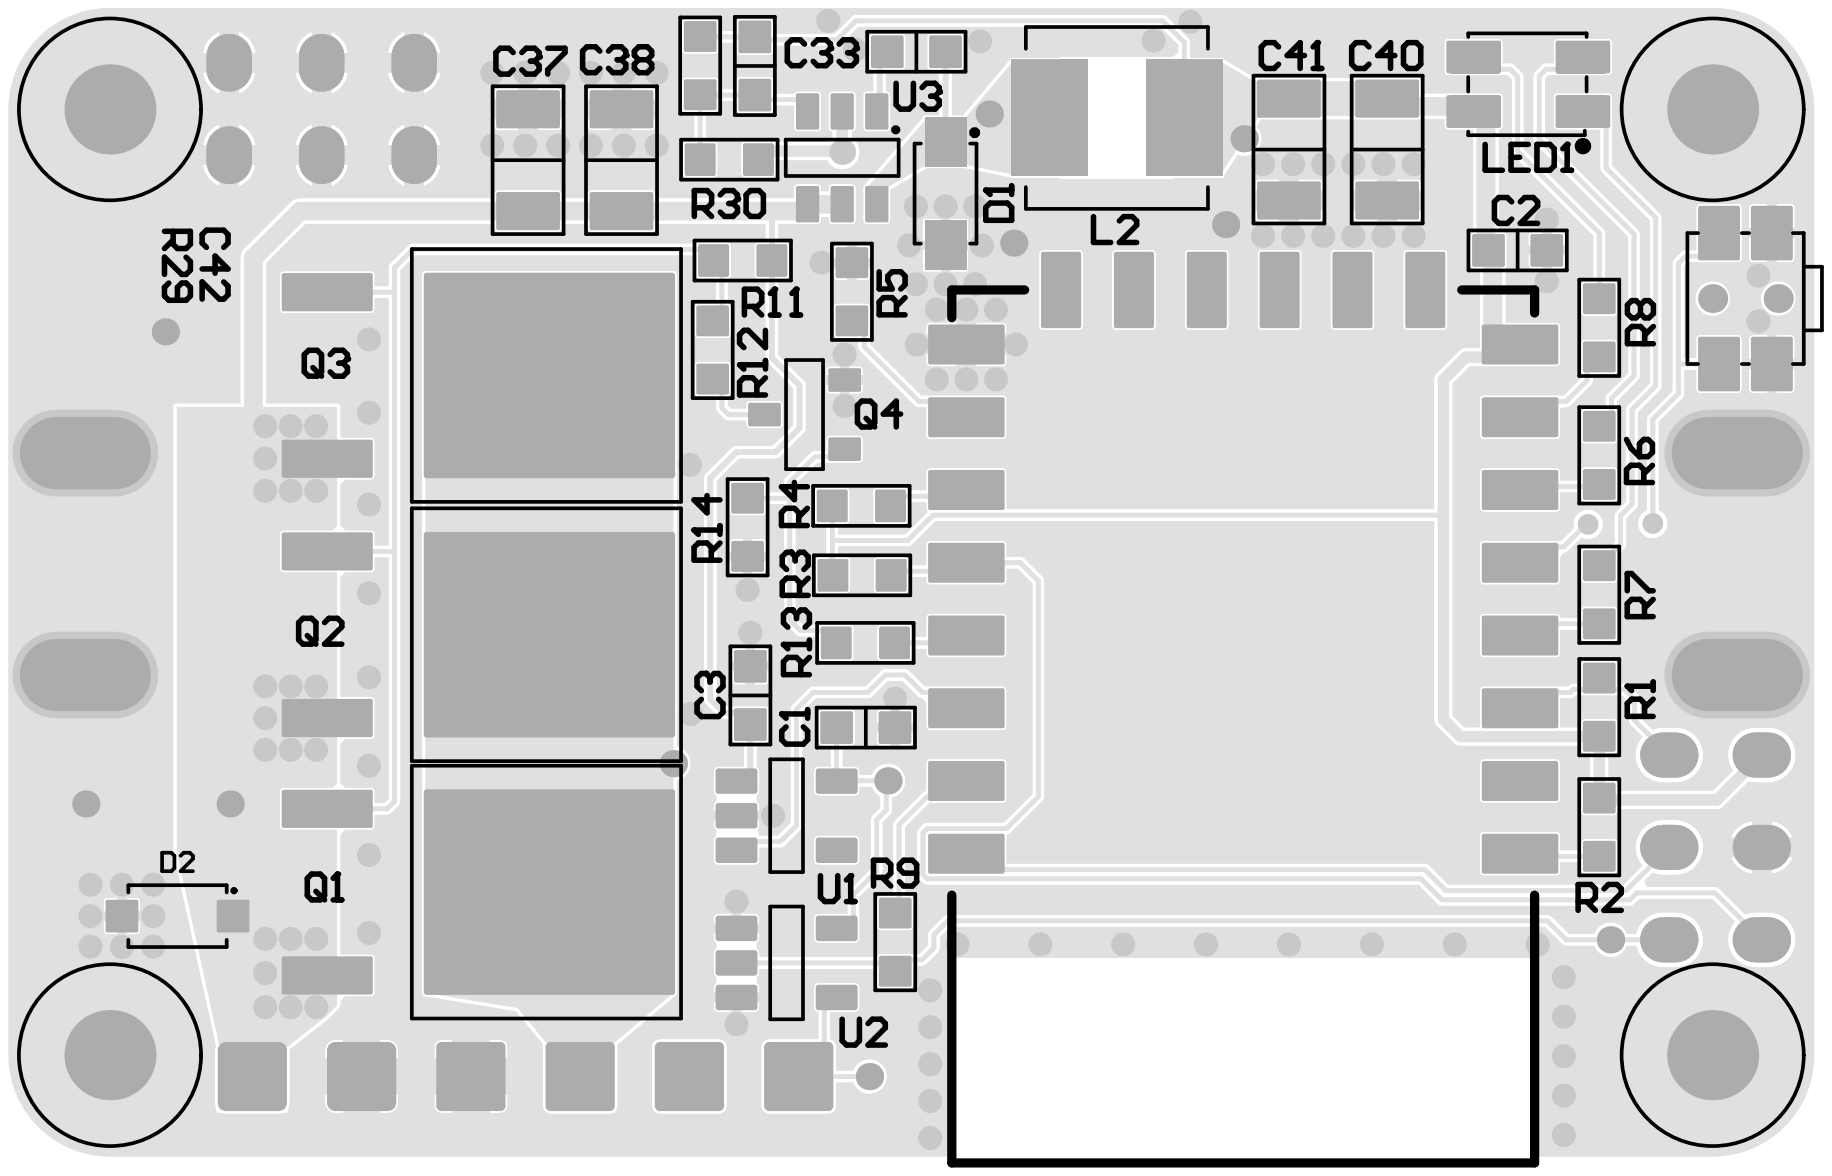
[picture p39: page 4]

Designator | Quantity | Value | Name | Description | Footprint | Model:Footprint | LibRef
C1, C3 | 2 1uF | | Cap | Capacitor | CAPC_0603_1608X 08L | Chip Capacitor 0603 | Cap
C2, C33 | 2 100nF | | Cap | Capacitor | CAPC_0603_1608X 08L | Chip Capacitor 0603 | Cap
C37, C38, C40, C41 | 4 22uF | | Cap | Capacitor | CAPC_1206_3216X 16L | Chip Capacitor 1206 | Cap
C42 | 1 100pF | | Cap | Capacitor | CAPC_0603_1608X 08L | Chip Capacitor 0603 | Cap
D1 | 1 | | Schottky40V3A | SchottkyDiode | SOD123 | SOD123 | DSchottky
D2 | 1 | | TVS | SchottkyDiode | SODFL350X120-2L | SODFL, 2-Leads, Body1.60x3.50mm, IPCHigh Density | DZener
ESP1 | 1 | | ESP8266ESP-12-E | ESP8266ESP-12-E | ESP8266ESP-12-E | ESP8266ESP-12-E | ESP8266ESP-12-E
L2 | 1 15uH | | Inductor | Inductor | INDP4949X30N | Precision WireWound Inductor, 2-Leads, Body 4.90x4.90mm, IPCMedium Density | Inductor
LED1 | 1 | | RGBLEDCommon anode | Dot is _not_anode! | PLCC-4 | LED | RGB_LED
Q1, Q2, Q3 | 3 | | MOSFET-P | | DPAK229P994X24 1-3L | D-PAK, 3-Pads, Body6.21x6.73mm (max), IPCHigh Density | MOSFET-P
Q4 | 1 | | MOSFET-N | | SOT23 | SOT23, 3-Leads, Body2.90x2.45mm, Pitch 0.95mm, IPCHigh Density | MOSFET-N
R1, R2, R3, R4, R5, R14 | 6 10K | | Res2 | Resistor | RESC_0603_1608X 08L | Chip Resistor, 2-Leads, Body1.60x0.80mm, IPCHigh Density | Res2
R6, R7, R8, R9, R13 | 5 1K | | Res2 | Resistor | RESC_0603_1608X 08L | Chip Resistor, 2-Leads, Body1.60x0.80mm, IPCHigh Density | Res2
R11 | 1 220K | | Res2 | Resistor | RESC_0603_1608X 08L | Chip Resistor, 2-Leads, Body1.60x0.80mm, IPCHigh Density | Res2
R12 | 1 100K | | Res2 | Resistor | RESC_0603_1608X 08L | Chip Resistor, 2-Leads, Body1.60x0.80mm, IPCHigh Density | Res2
R29 | 1 2.4K | | Res2 | Resistor | RESC_0603_1608X 08L | Chip Resistor, 2-Leads, Body1.60x0.80mm, IPCHigh Density | Res2
R30 | 1 680R | | Res2 | Resistor | RESC_0603_1608X 08L | Chip Resistor, 2-Leads, Body1.60x0.80mm, IPCHigh Density | Res2
S_FUN1 | 1 | | 4-1437565-1 | Tactileswitch | EVQP7C01P | Sideactuated tactileswitch | 4-1437565-1
U1 | 1 | | M74VHC1GT125 | Level shifter non inverting | SOT95P285X130-5N | SOT23, 5-Leads, Body3.00x2.85mm, Pitch 0.95mm, IPC Medium Density | M74VHC1GT125
U2 | 1 | | AP7383-50W5 | | SOT95P285X130-5N | SOT23, 5-Leads, Body3.00x2.85mm, Pitch 0.95mm, IPC Medium Density | AP7383-50W5
U3 | 1 | | BD9G101G-LB | | TSOP95P280X125-6L | TSOP, 6-Leads, Body2.90x1.65mm, Pitch 0.95mm, IPCHigh Density | BD9G102G-LB

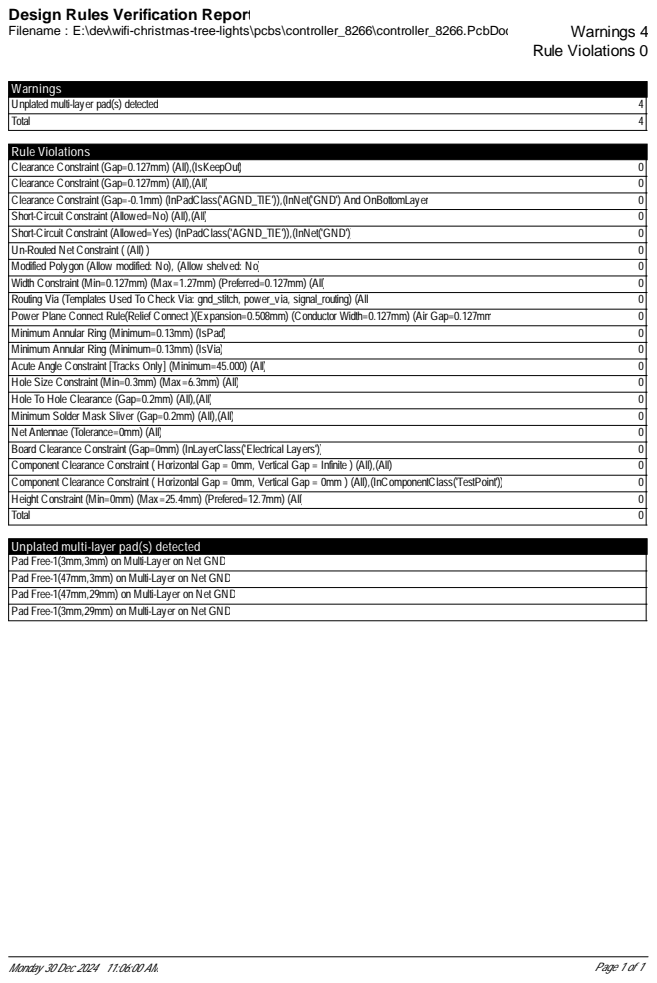
[picture p40: page 6]

Design Rules Verification Report

Unplated multi-layer pad(s) detected
Pad Free-1(3mm,3mm) on Multi-Layer on Net GND
Pad Free-1(47mm,3mm) on Multi-Layer on Net GND
Pad Free-1(47mm,29mm) on Multi-Layer on Net GND
Pad Free-1(3mm,29mm) on Multi-Layer on Net GND
