cskilbeck/xtl/pcbs/controller_8266/Outputs/2020-08-14/aisler.PDF

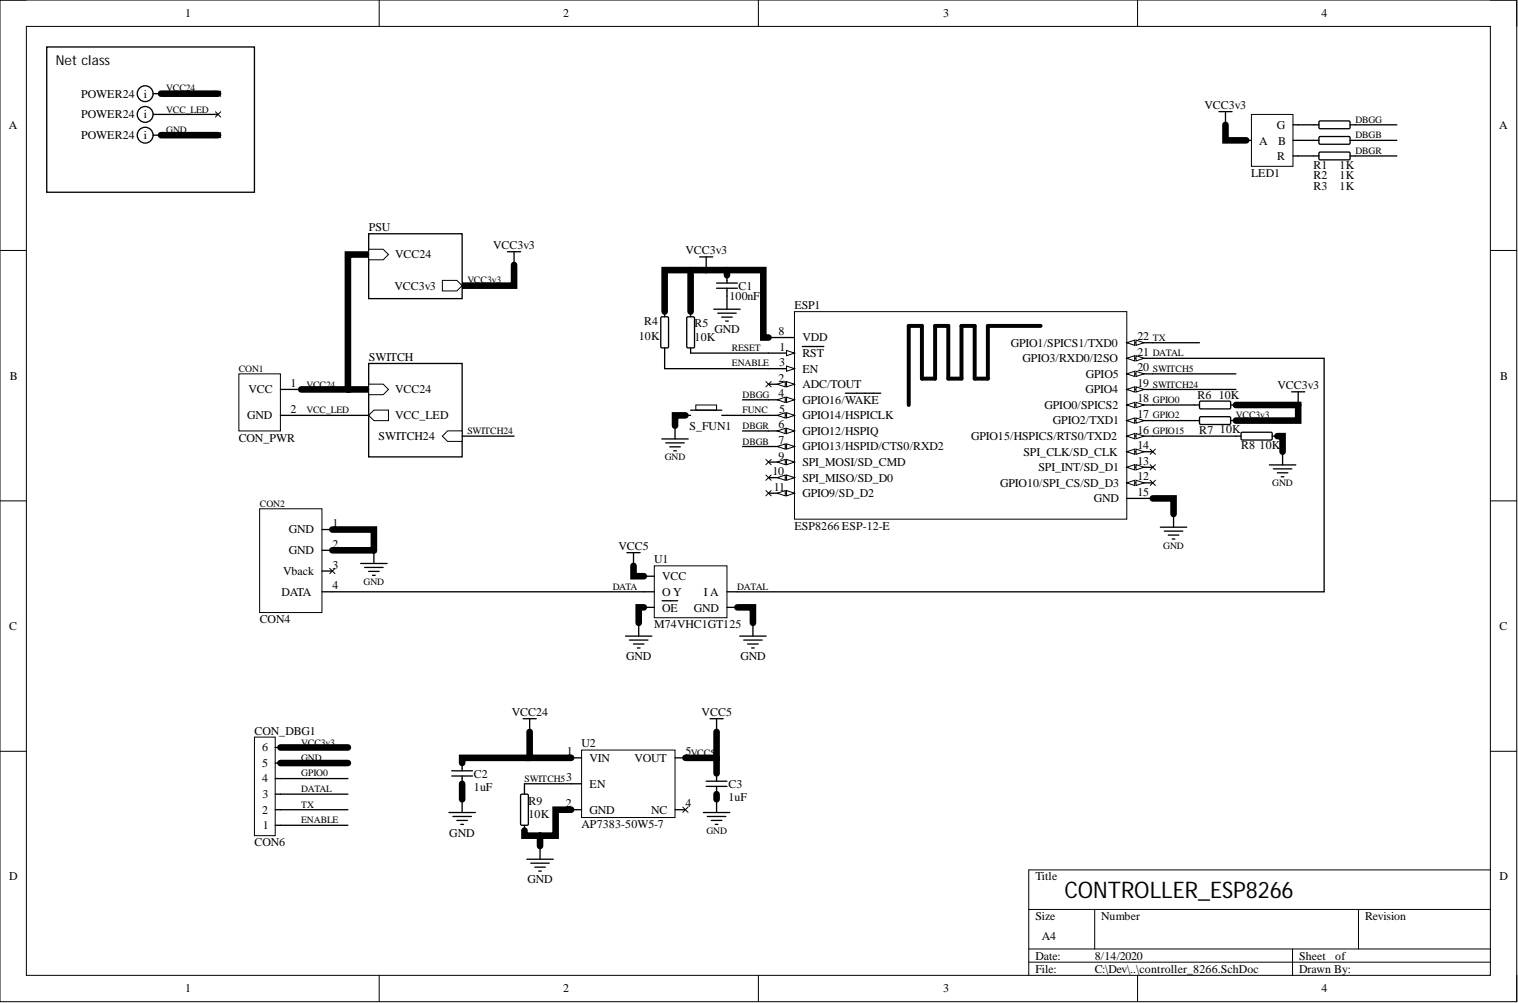
[picture p41: page 1]

VDD 8

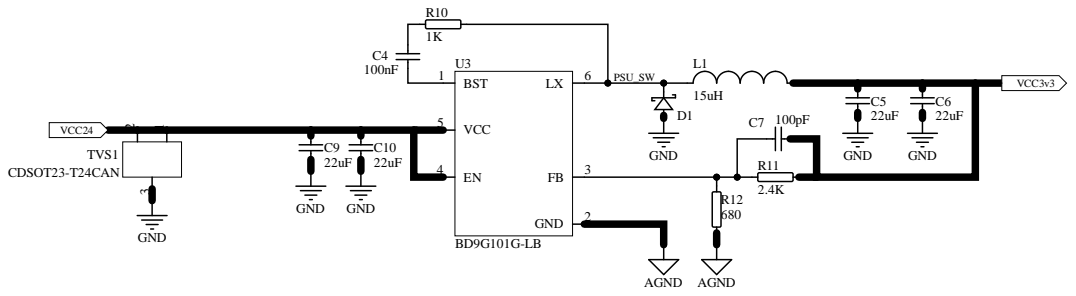
[picture p42: page 2]

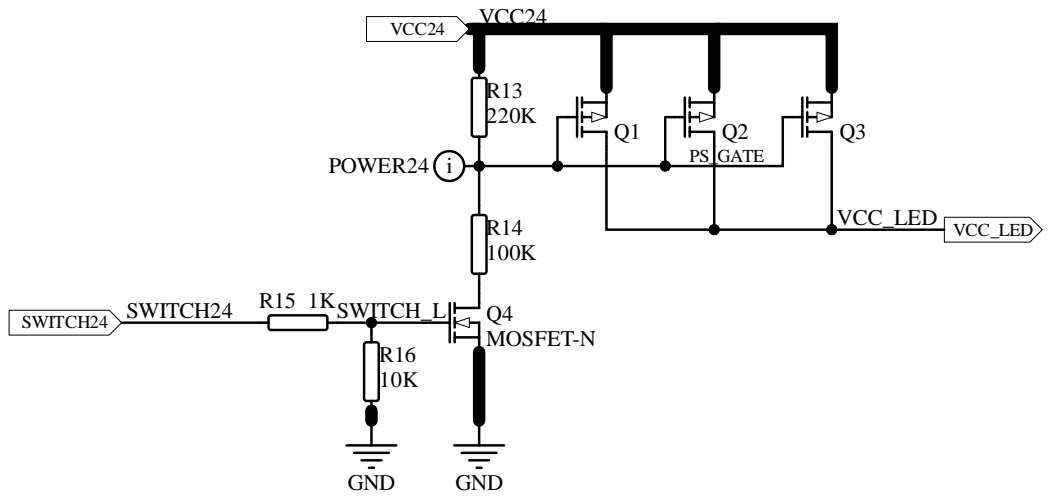
[picture p43: page 3]

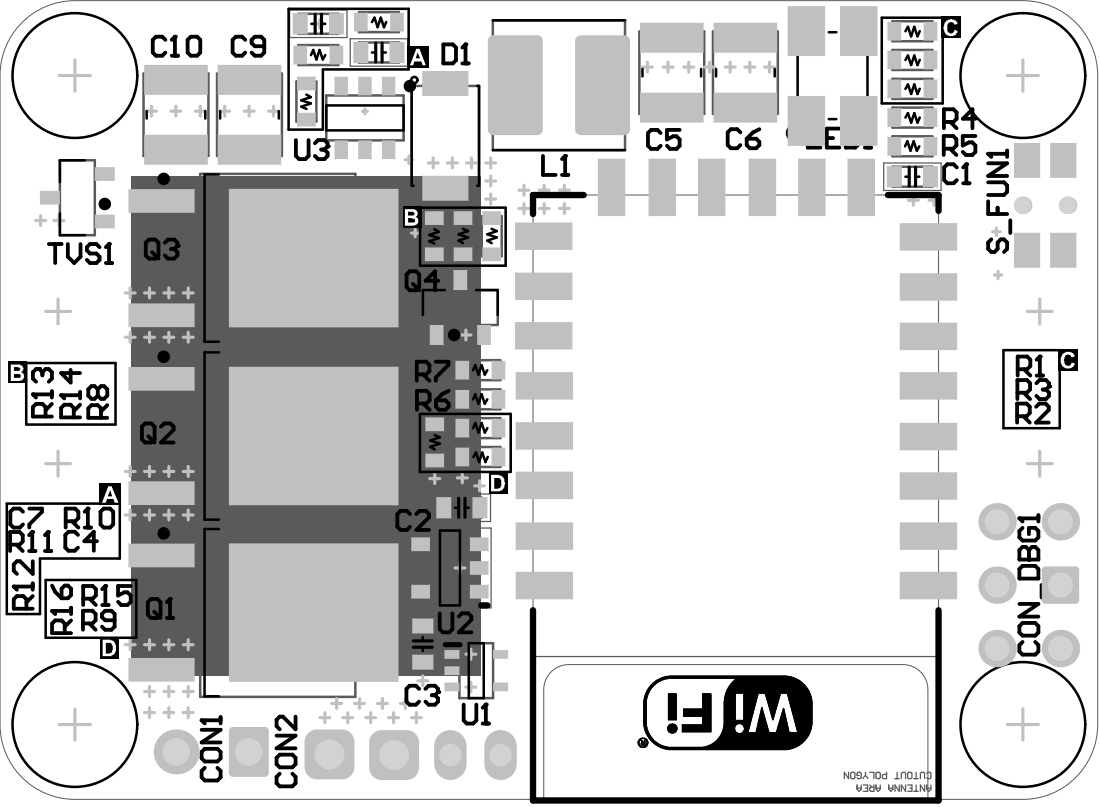
[picture p44: page 4]

Name | Designator | Quantity | MPN | Vendor | Footprint | Description | Voltage | Value
Cap | C1, C4 | 2 | | | CAPC_0603_1608X08L | Capacitor | | 100nF
Cap | C2, C3 | 2 | | | CAPC_0603_1608X08L | Capacitor | | 1uF
Cap | C5, C6, C9, C10 | 4 | | | CAPC3224X25L | Capacitor | | 22uF
Cap | C7 | 1 | | | CAPC_0603_1608X08L | Capacitor | | 100pF
Schottky 40V 3A | D1 | 1 | | | SODFL470X110-2L | Schottky Diode
ESP8266 ESP-12-E | ESP1 | 1 | | | ESP8266 ESP-12-E | ESP8266 ESP-12-E
Inductor | L1 | 1 | | | INDP5150X20L | Inductor | | 15uH
RGB LED Common anode | LED1 | 1 | | | PLCC-4 | Dot is _not_ anode!
MOSFET-P | Q1, Q2, Q3 | 3 | | | DPAK229P994X241-3L
MOSFET-N | Q4 | 1 | | | SOT23
Res2 | R1, R2, R3, R10, R15 | 5 | | | RESC_0603_1608X08L | Resistor | | 1K
Res2 | R4, R5, R6, R7, R8, R9, R16 | 7 | | | RESC_0603_1608X08L | Resistor | | 10K
Res2 | R11 | 1 | | | RESC_0603_1608X08L | Resistor | | 2.4K
Res2 | R12 | 1 | | | RESC_0603_1608X08L | Resistor | | 680
Res2 | R13 | 1 | | | RESC_0603_1608X08L | Resistor | | 220K
Res2 | R14 | 1 | | | RESC_0603_1608X08L | Resistor | | 100K
4-1437565-1 | S_FUN1 | 1 | | | EVQP7C01P | Tactile switch
CDSOT23-T24CAN | TVS1 | 1 | | | SOT23 | Dual 24V TVS Diode
M74VHC1GT125 | U1 | 1 | | | SOT65P210X100-5L | Level shifter non inverting
AP7383-50W5-7 | U2 | 1 | | | SOT95P260X90-5L | 5V LDO Vin_max 33V 150mA
BD9G101G-LB | U3 | 1 | | | TSOP95P280X125-6L

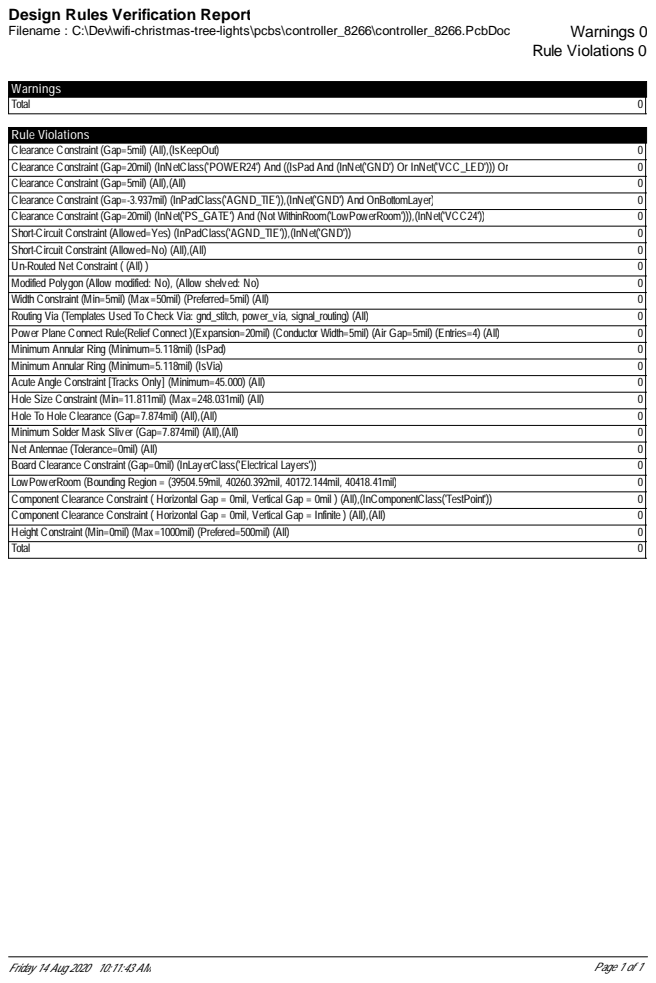
[picture p45: page 6]

Design Rules Verification Report
