cskilbeck/xtl/pcbs/buck4/Outputs/2020-06-03/buck4.PDF

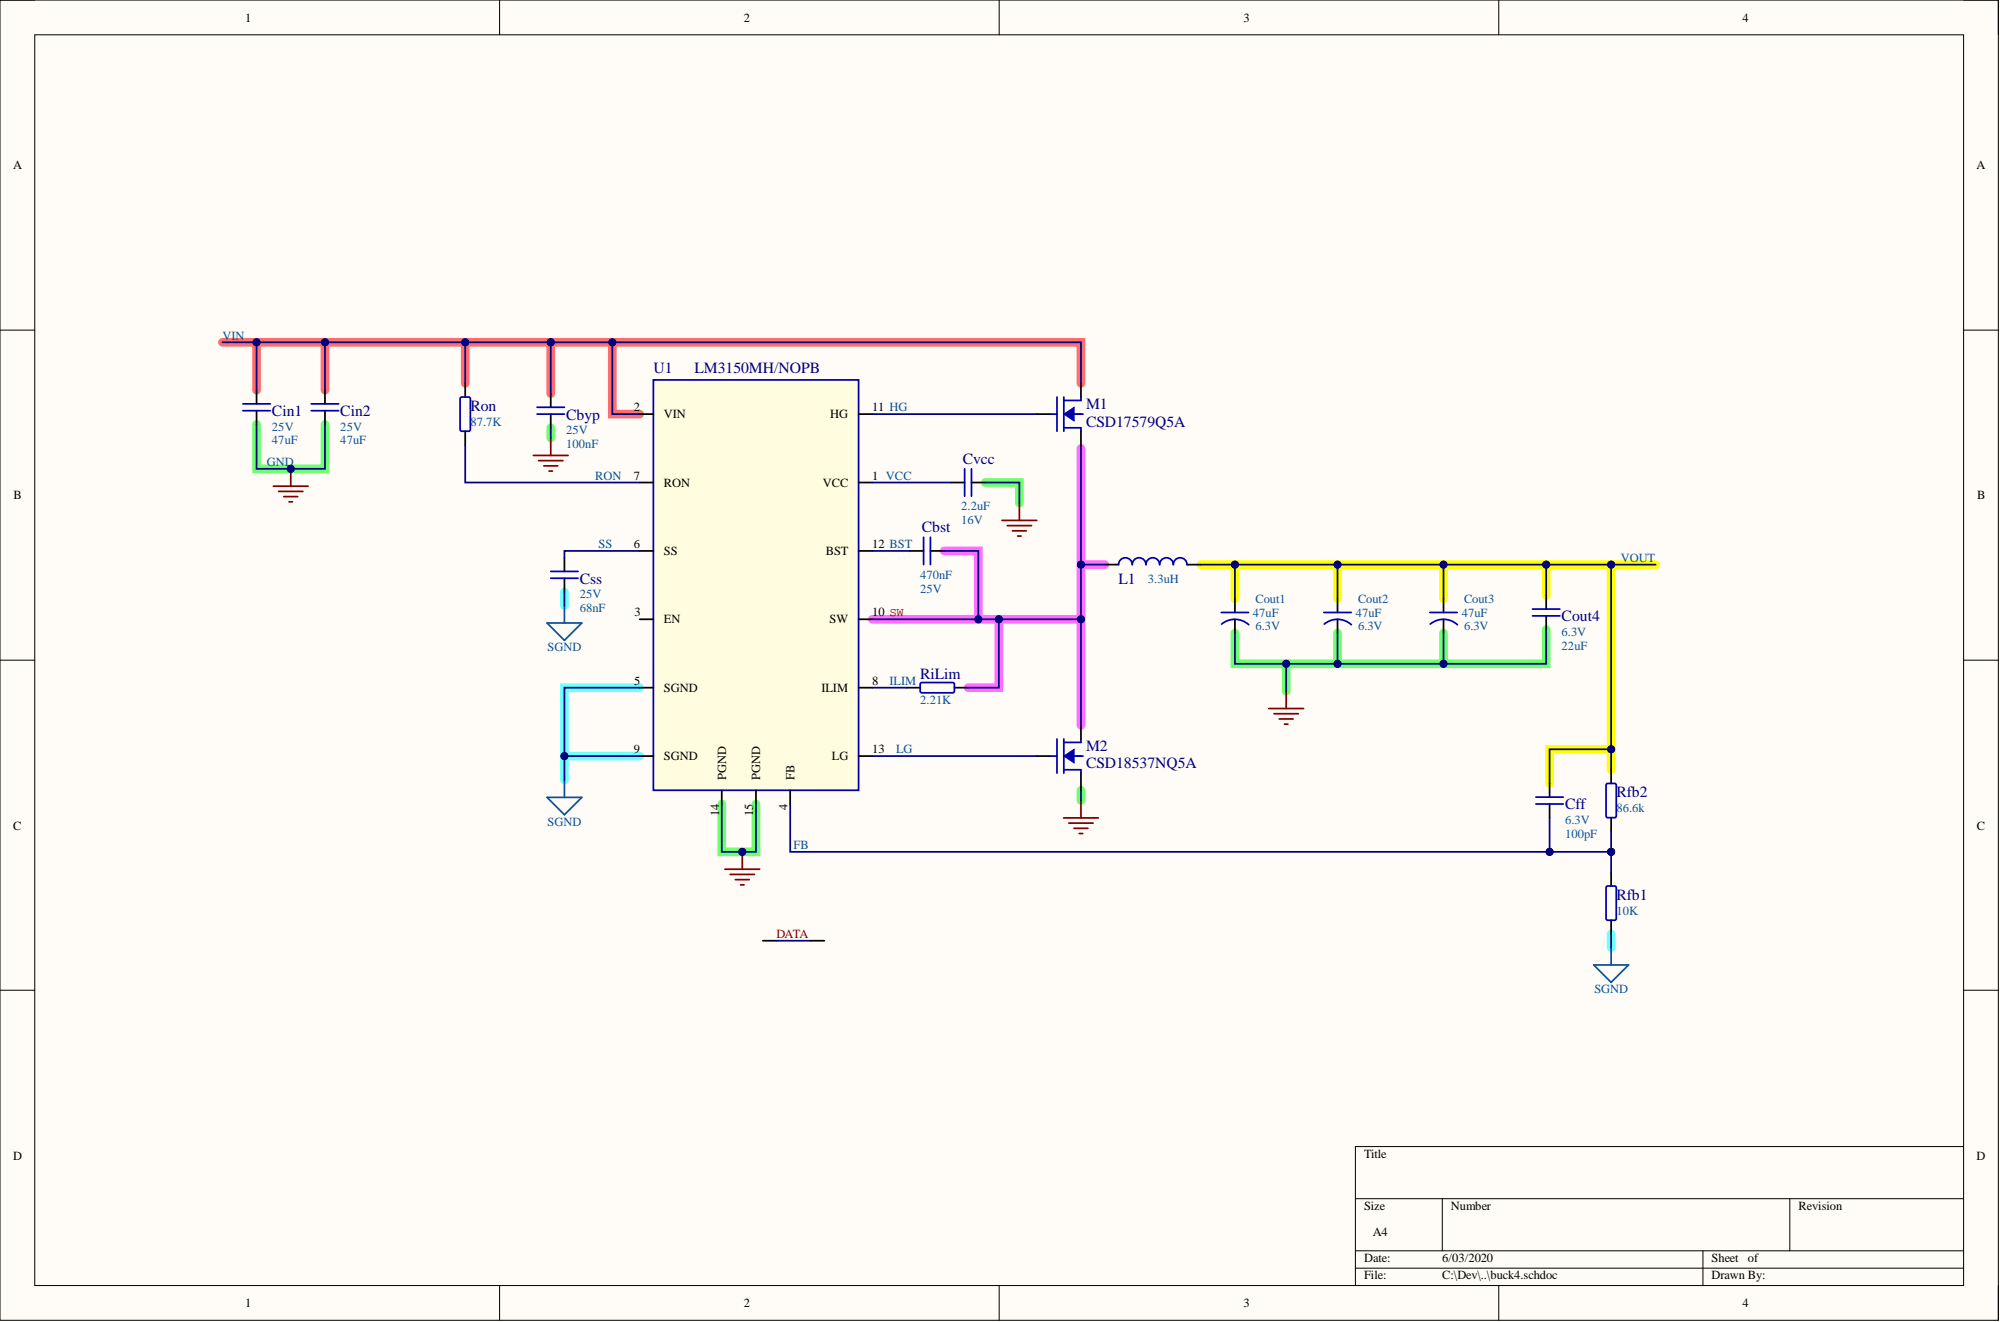
[picture p51: page 1]

8 ILIM 2.2 1 K

Index | Designator | Quantity | Value | Voltage | VdsMax | Name | Description | Footprint | MPN | Vendor
1 | Cbst | 1 470nF | | 25V | | MLCC | Multilayer Ceramic Capacitor | CAPC2012X12L
2 | Cbyp | 1 100nF | | 25V | | MLCC | Multilayer Ceramic Capacitor | CAPC2012X12L
3 | Cff | 1 100pF | | 6.3V | | MLCC | Multilayer Ceramic Capacitor | CAPC1608X08L
4, 5 | Cin1, Cin2 | 2 47uF | | 25V | | MLCC | Multilayer Ceramic Capacitor | CAPC3216X12L | C3216X5R1E476M160AC | TDK
6, 7, 8 | Cout1, Cout2, Cout3 | 3 47uF | | 6.3V | | CAPACITOR | Electrolytic Capacitor | CAPMP7343X11L | EEFCS1A470R | Pansonic
9 | Cout4 | 1 22uF | | 6.3V | | MLCC | Multilayer Ceramic Capacitor | CAPC3216X12L
10 | Css | 1 68nF | | 25V | | MLCC | Multilayer Ceramic Capacitor | CAPC1608X08L
11 | Cvcc | 1 2.2uF | | 16V | | MLCC | Multilayer Ceramic Capacitor | CAPC1608X08L
12 | L1 | 1 3.3uH | | | | 744313330 | Inductor | WE-HCI_1335 | 744313330 | Wurth Elektronik
13 | M1 | 1 | | | 30.0V | CSD17579Q5A | N Channel MOSFET | TRANS_NexFET_Q5A | CSD17579Q5A | Texas Instruments
14 | M2 | 1 | | | 60.0 | CSD18537NQ5A | N Channel MOSFET | TRANS_NexFET_Q5A | CSD18537NQ5A | Texas Instruments
15 | Rfb1 | 1 10K | | | | RES0603 | Chip Resistor | RESC1608X03L
16 | Rfb2 | 1 86.6k | | | | RES0603 | Chip Resistor | RESC1608X03L
17 | RiLim | 1 2.21K | | | | RES0603 | Chip Resistor | RESC1608X03L
18 | Ron | 1 87.7K | | | | RES0603 | Chip Resistor | RESC1608X03L
19 | U1 | 1 | | | | LM3150MH/NOPB | Buck controller | MXA14A | LM3150MH/NOPB | Texas Instruments

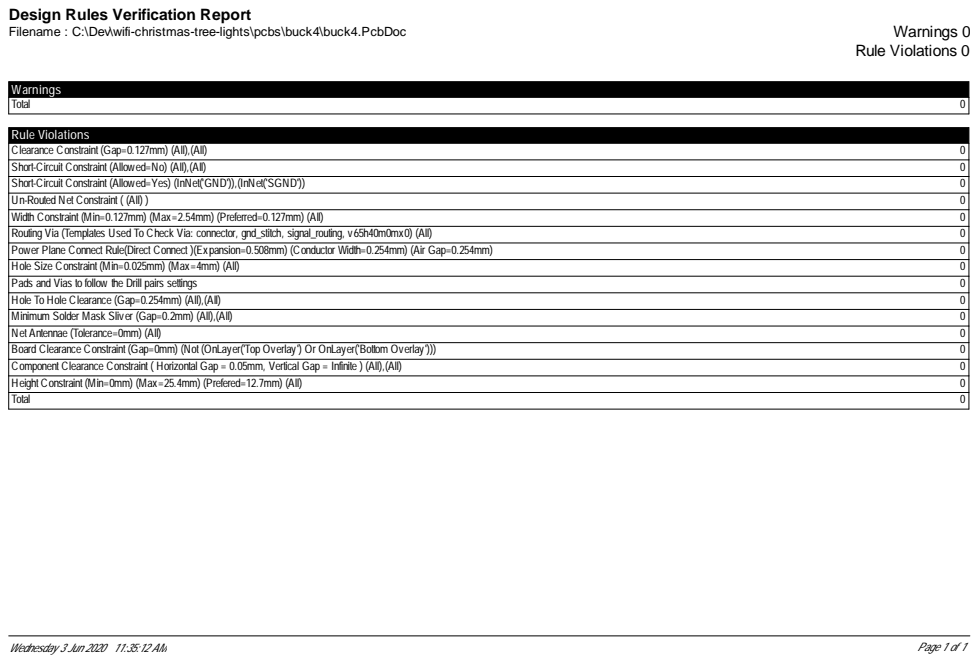
[picture p52: page 3]

Design Rules Verification Report
