cskilbeck/xtl/pcbs/buck3/Outputs/2019-05-11 Rev1/buck3.PDF

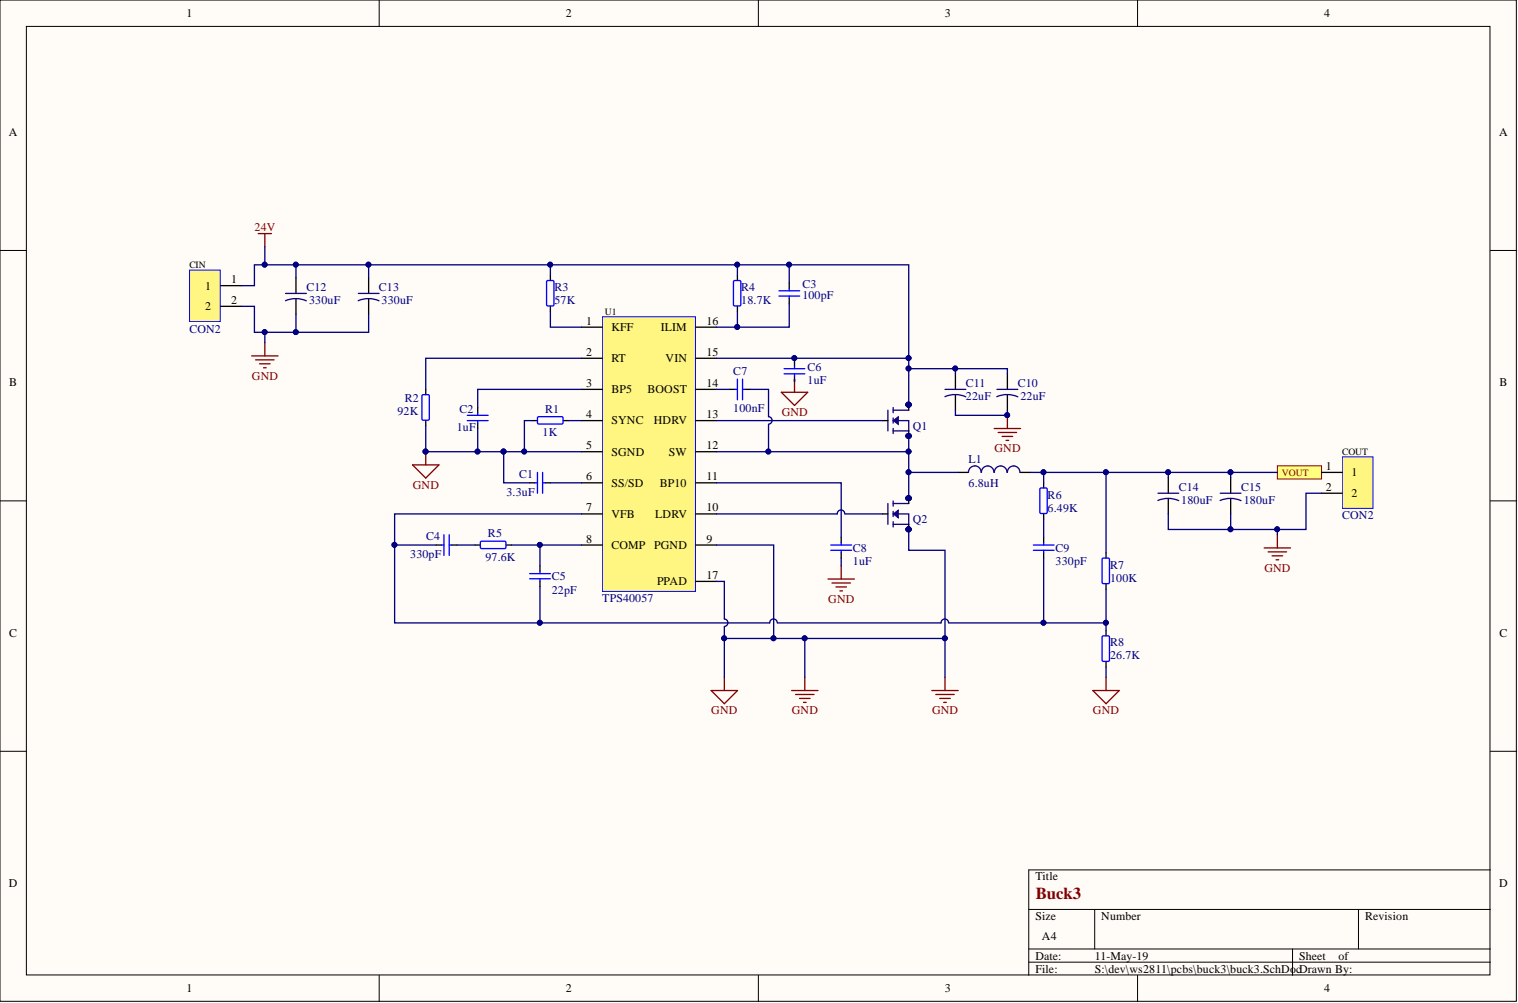
[picture p53: page 1]

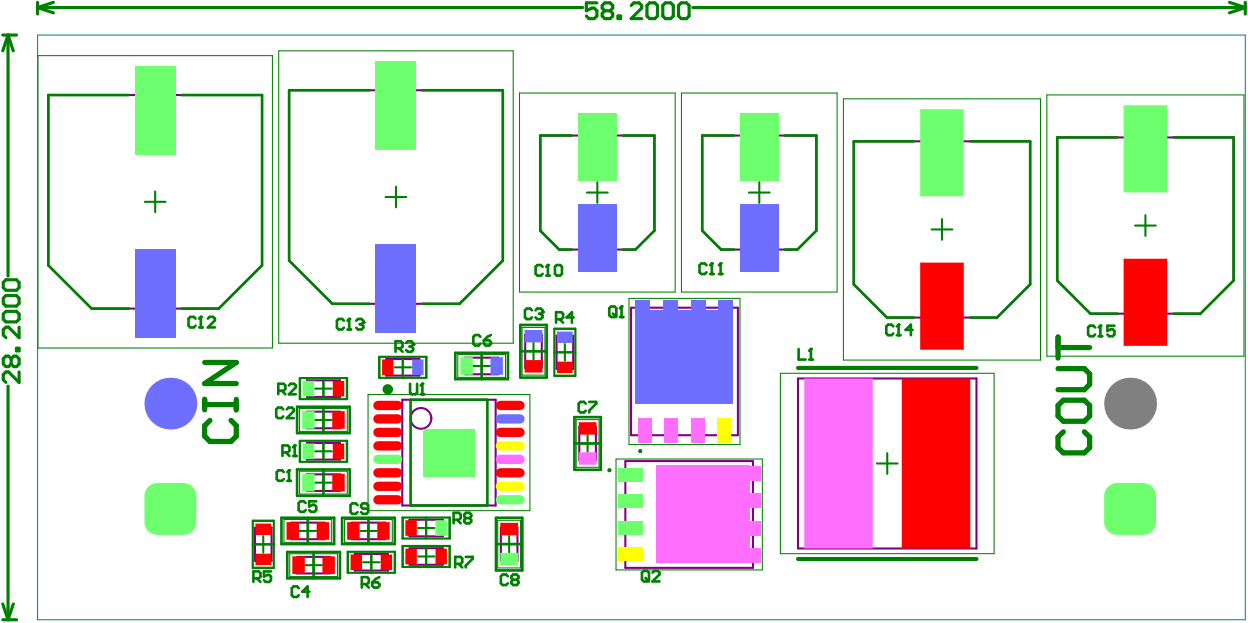
[picture p54: page 2]

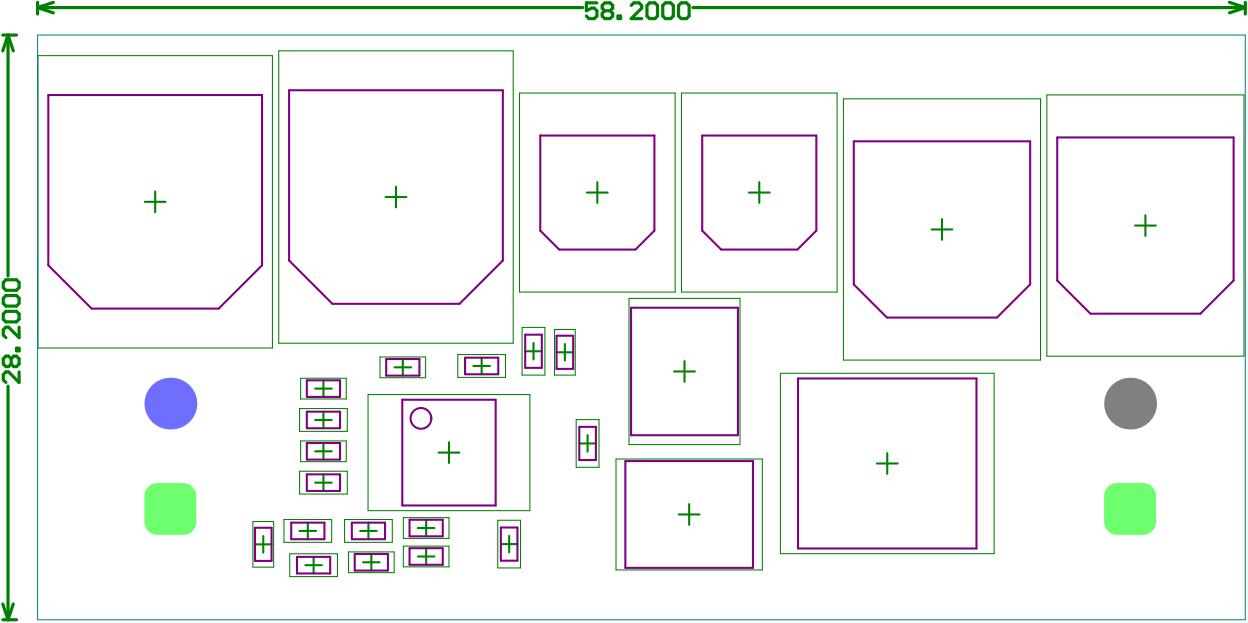
[picture p55: page 3]

Description | Designator | Quantity | Value | Footprint
Buck Controller | U1 | 1 | TPS40057 | TSOP65P640X120_HS-17N
Capacitor | C1 | 1 | 3.3uF | CAPC_0603_1608X08L
Capacitor | C2, C6, C8 | 3 | 1uF | CAPC_0603_1608X08L
Capacitor | C3 | 1 | 100pF | CAPC_0603_1608X08L
Capacitor | C4, C9 | 2 | 330pF | CAPC_0603_1608X08L
Capacitor | C5 | 1 | 22pF | CAPC_0603_1608X08L
Capacitor | C7 | 1 | 100nF | CAPC_0603_1608X08L
Capacitor | C10, C11 | 2 | 22uF | CAPAE6053X59M
Capacitor | C12, C13 | 2 | 330uF | CAPAE115102X102N
Capacitor | C14, C15 | 2 | 180uF | CAPAE10083X104N
Inductor | L1 | 1 | 6.8uH | INDP8580X40N
N Channel MOSFET | Q1, Q2 | 2 | Infineon BSC093N04LSGATMA1 | INF-PG-TDSON-8-1_V
Resistor | R1 | 1 | 1K | RESC_0603_1608X08L
Resistor | R2 | 1 | 92K | RESC_0603_1608X08L
Resistor | R3 | 1 | 57K | RESC_0603_1608X08L
Resistor | R4 | 1 | 18.7K | RESC_0603_1608X08L
Resistor | R5 | 1 | 97.6K | RESC_0603_1608X08L
Resistor | R6 | 1 | 6.49K | RESC_0603_1608X08L
Resistor | R7 | 1 | 100K | RESC_0603_1608X08L
Resistor | R8 | 1 | 26.7K | RESC_0603_1608X08L

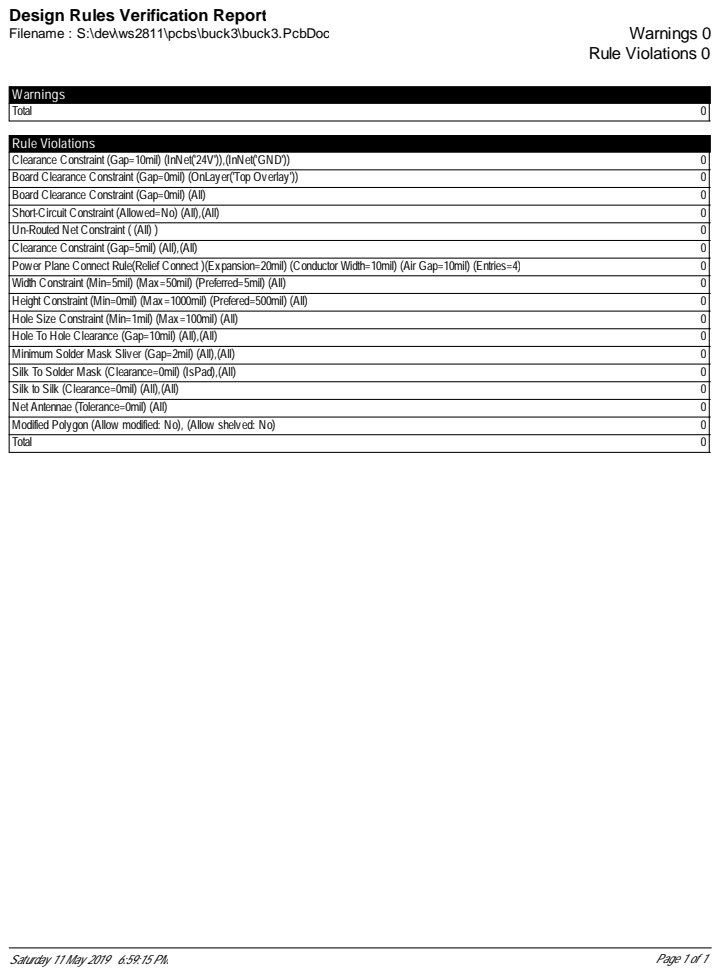
[picture p56: page 5]

Design Rules Verification Report
