cskilbeck/xtl/pcbs/buck3/Outputs/2019-06-22 Rev2/PCB Print/Assembly Drawings.PDF

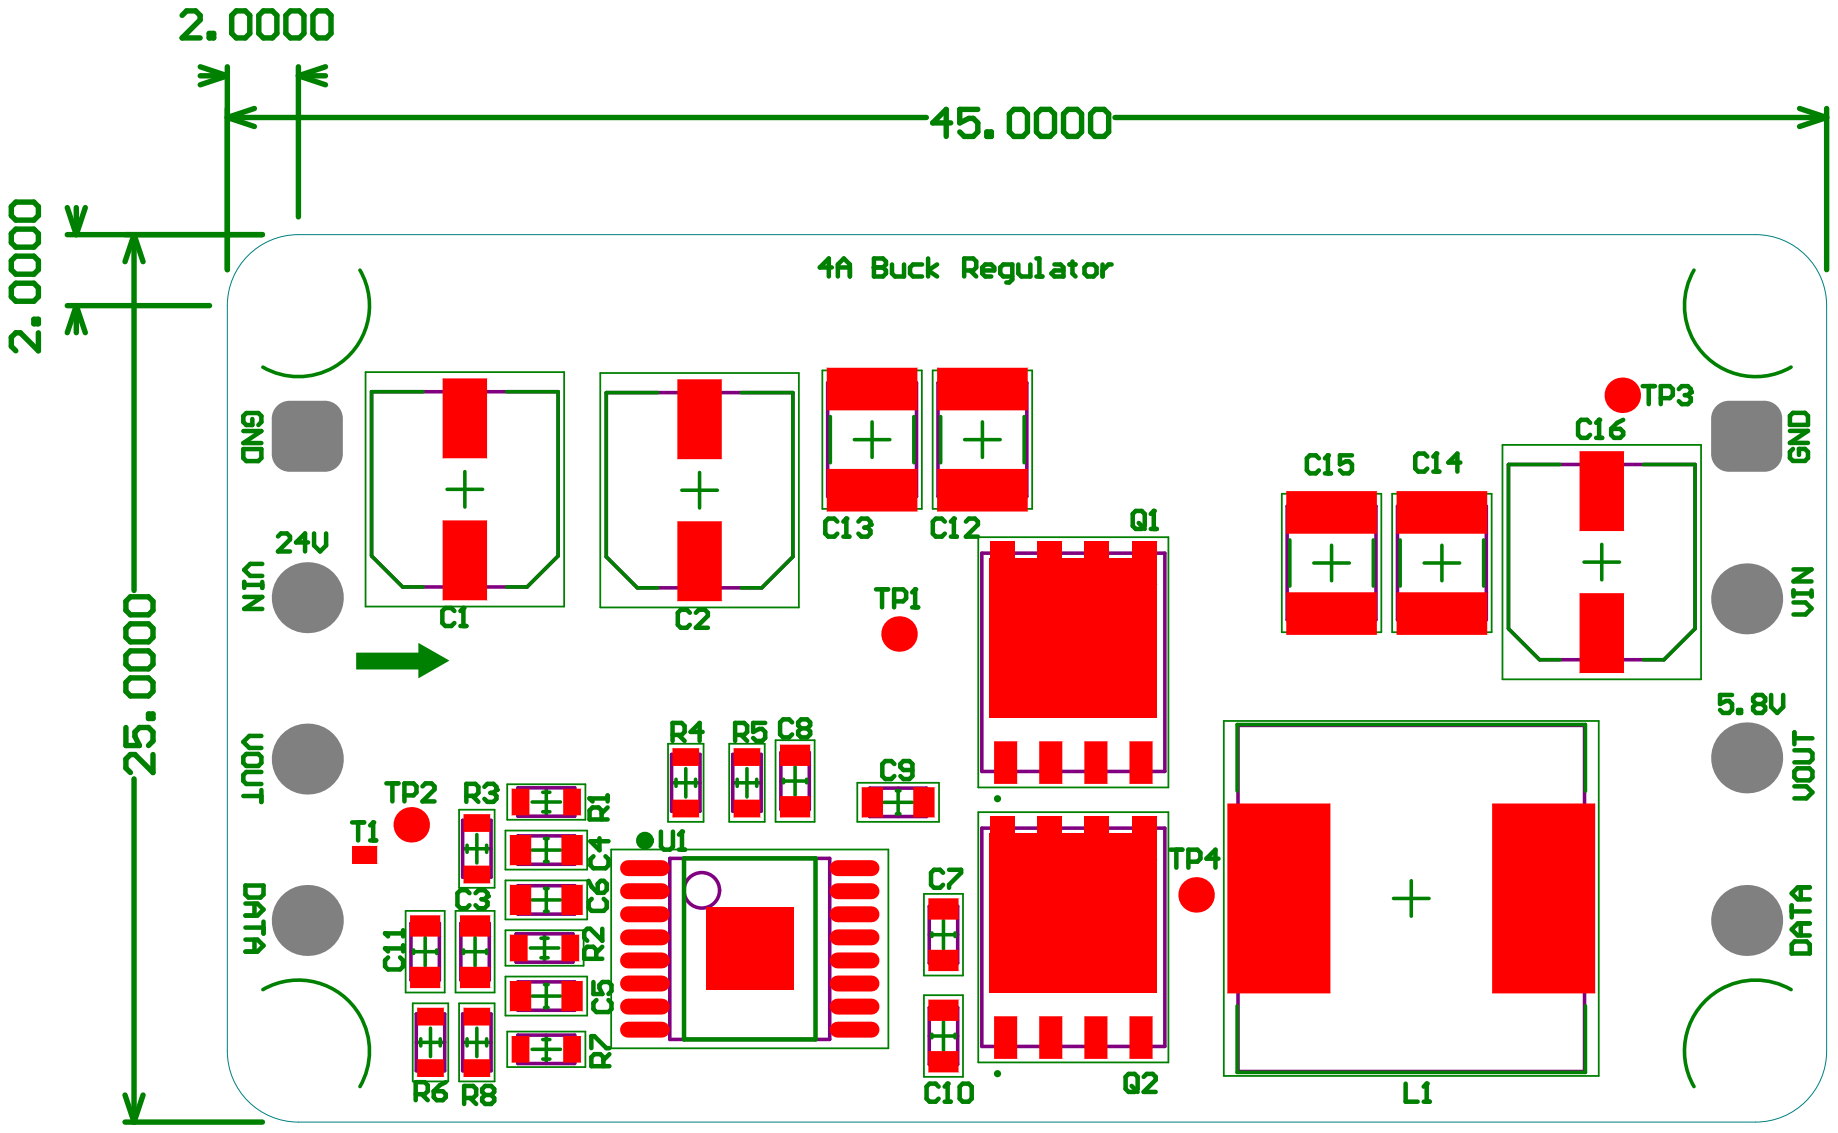
[picture p57: page 1]

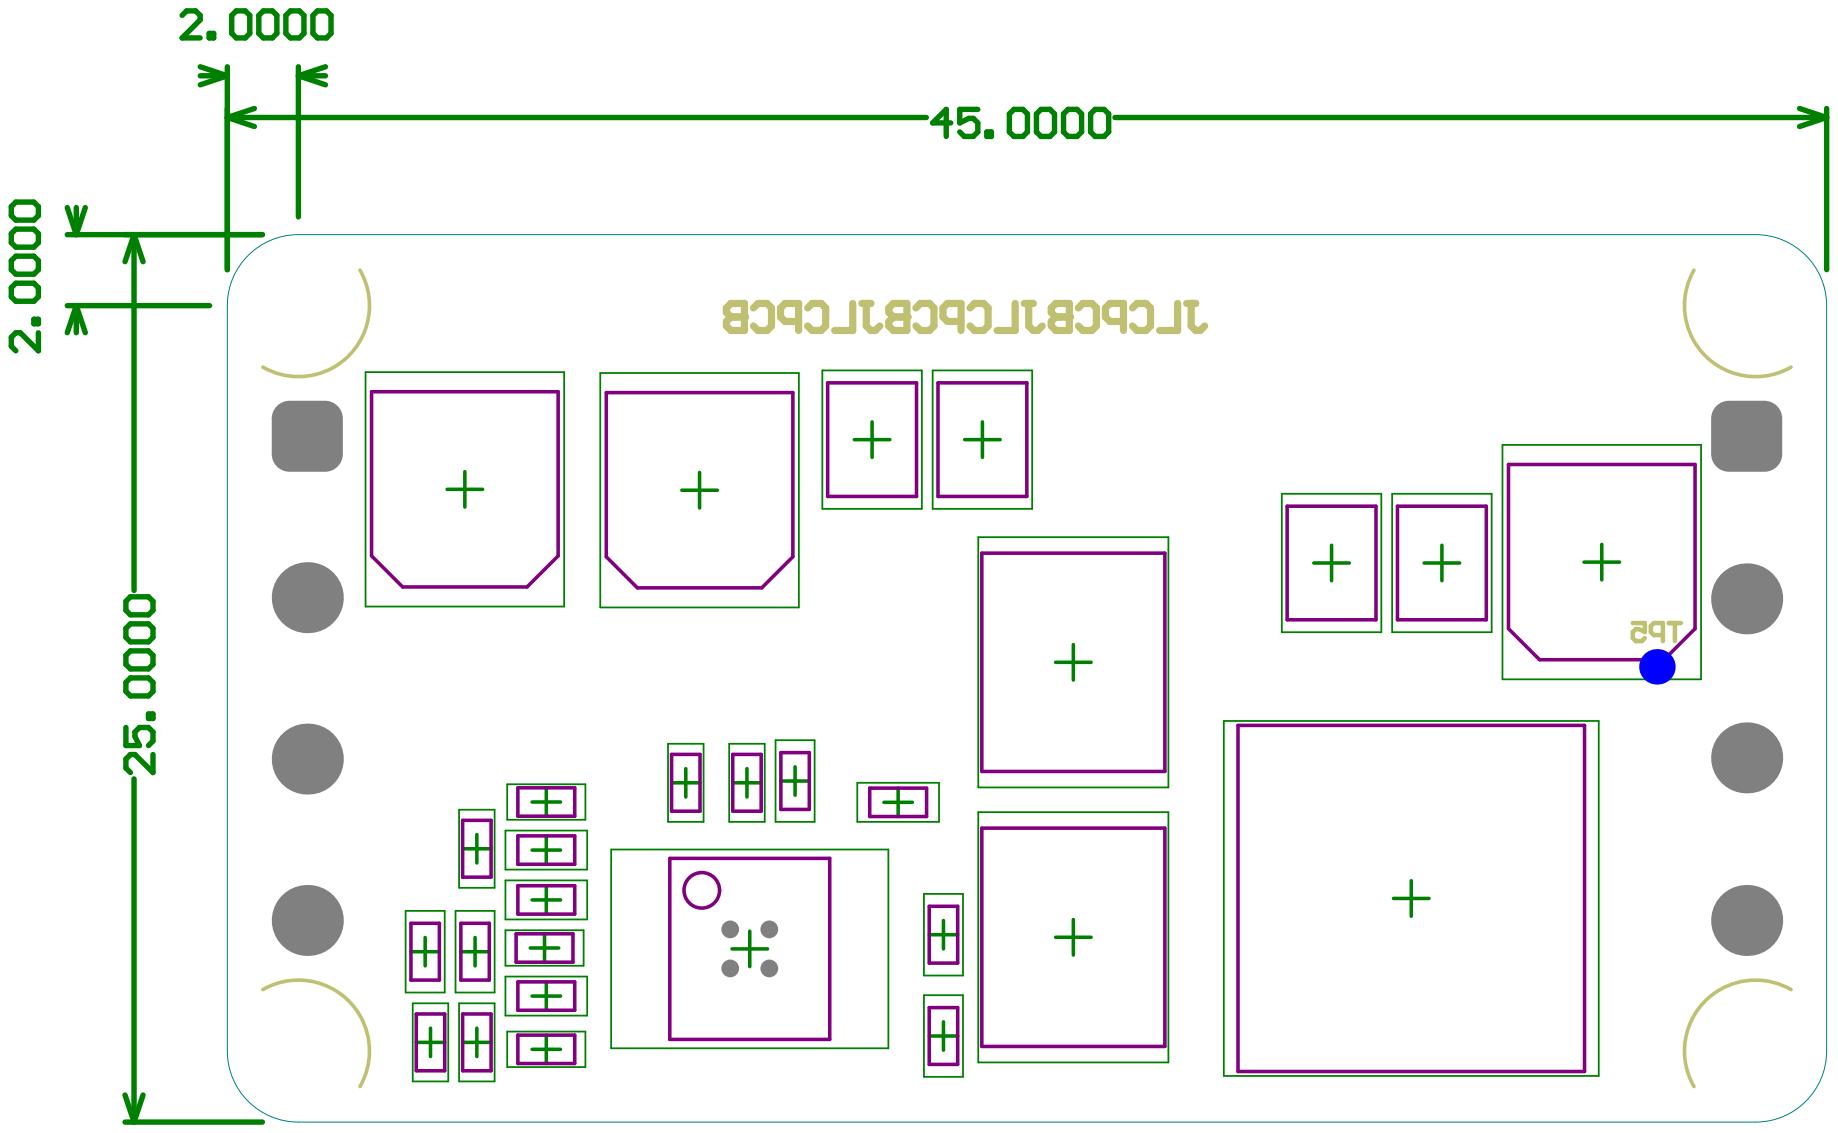
[picture p58: page 2]
