cskilbeck/xtl/pcbs/buck3/Outputs/2019-06-22 Rev2/Schematic Print/Schematic Prints.PDF

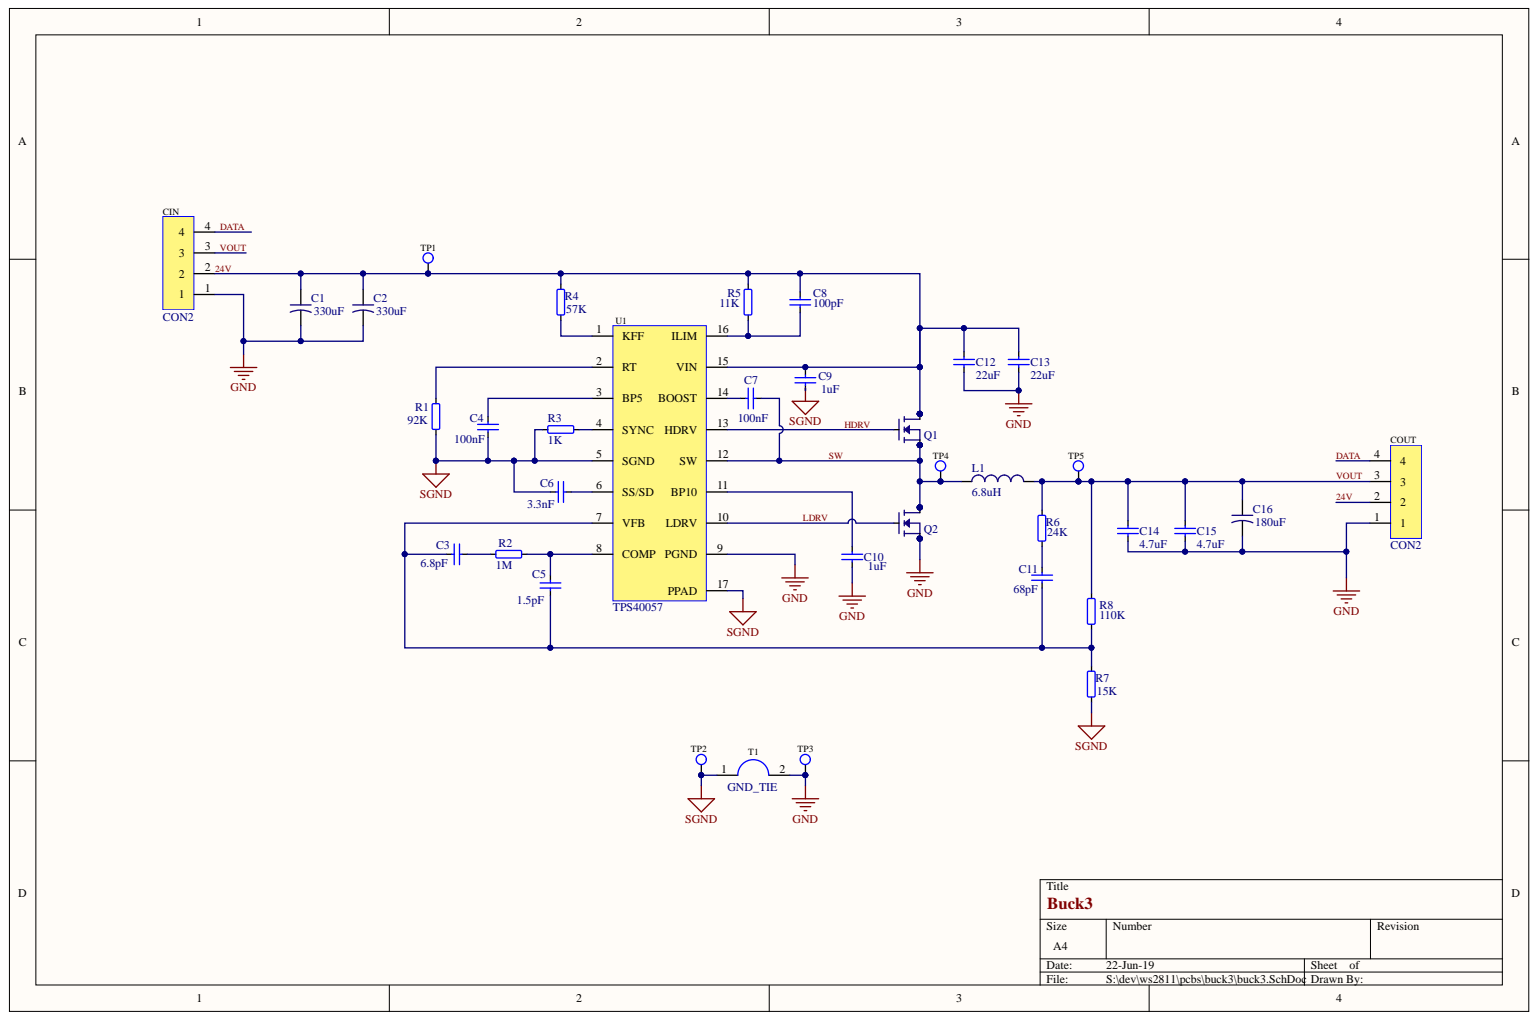
[picture p59: page 1]
