cskilbeck/xtl/pcbs/buck3/Outputs/2019-12-01 Rev2/Reports/Assembly Drawings.PDF

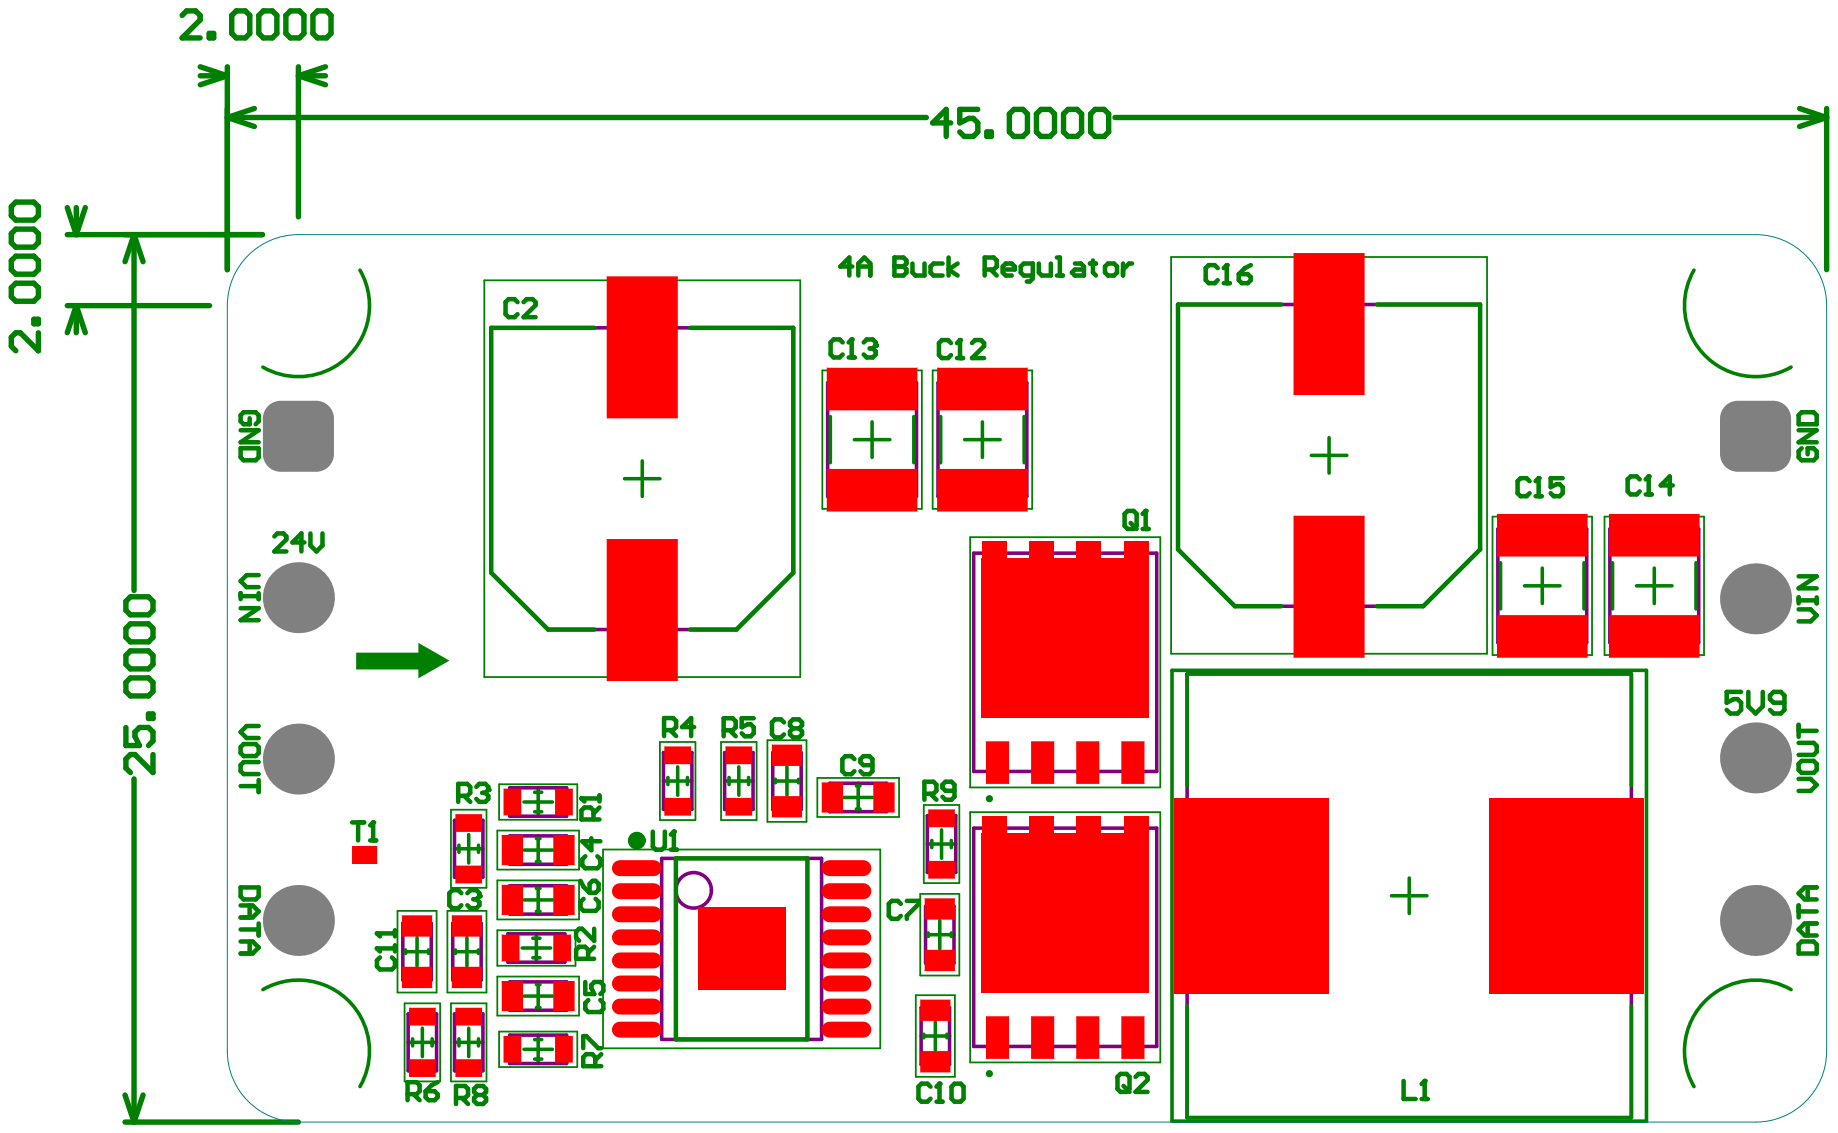
[picture p60: page 1]

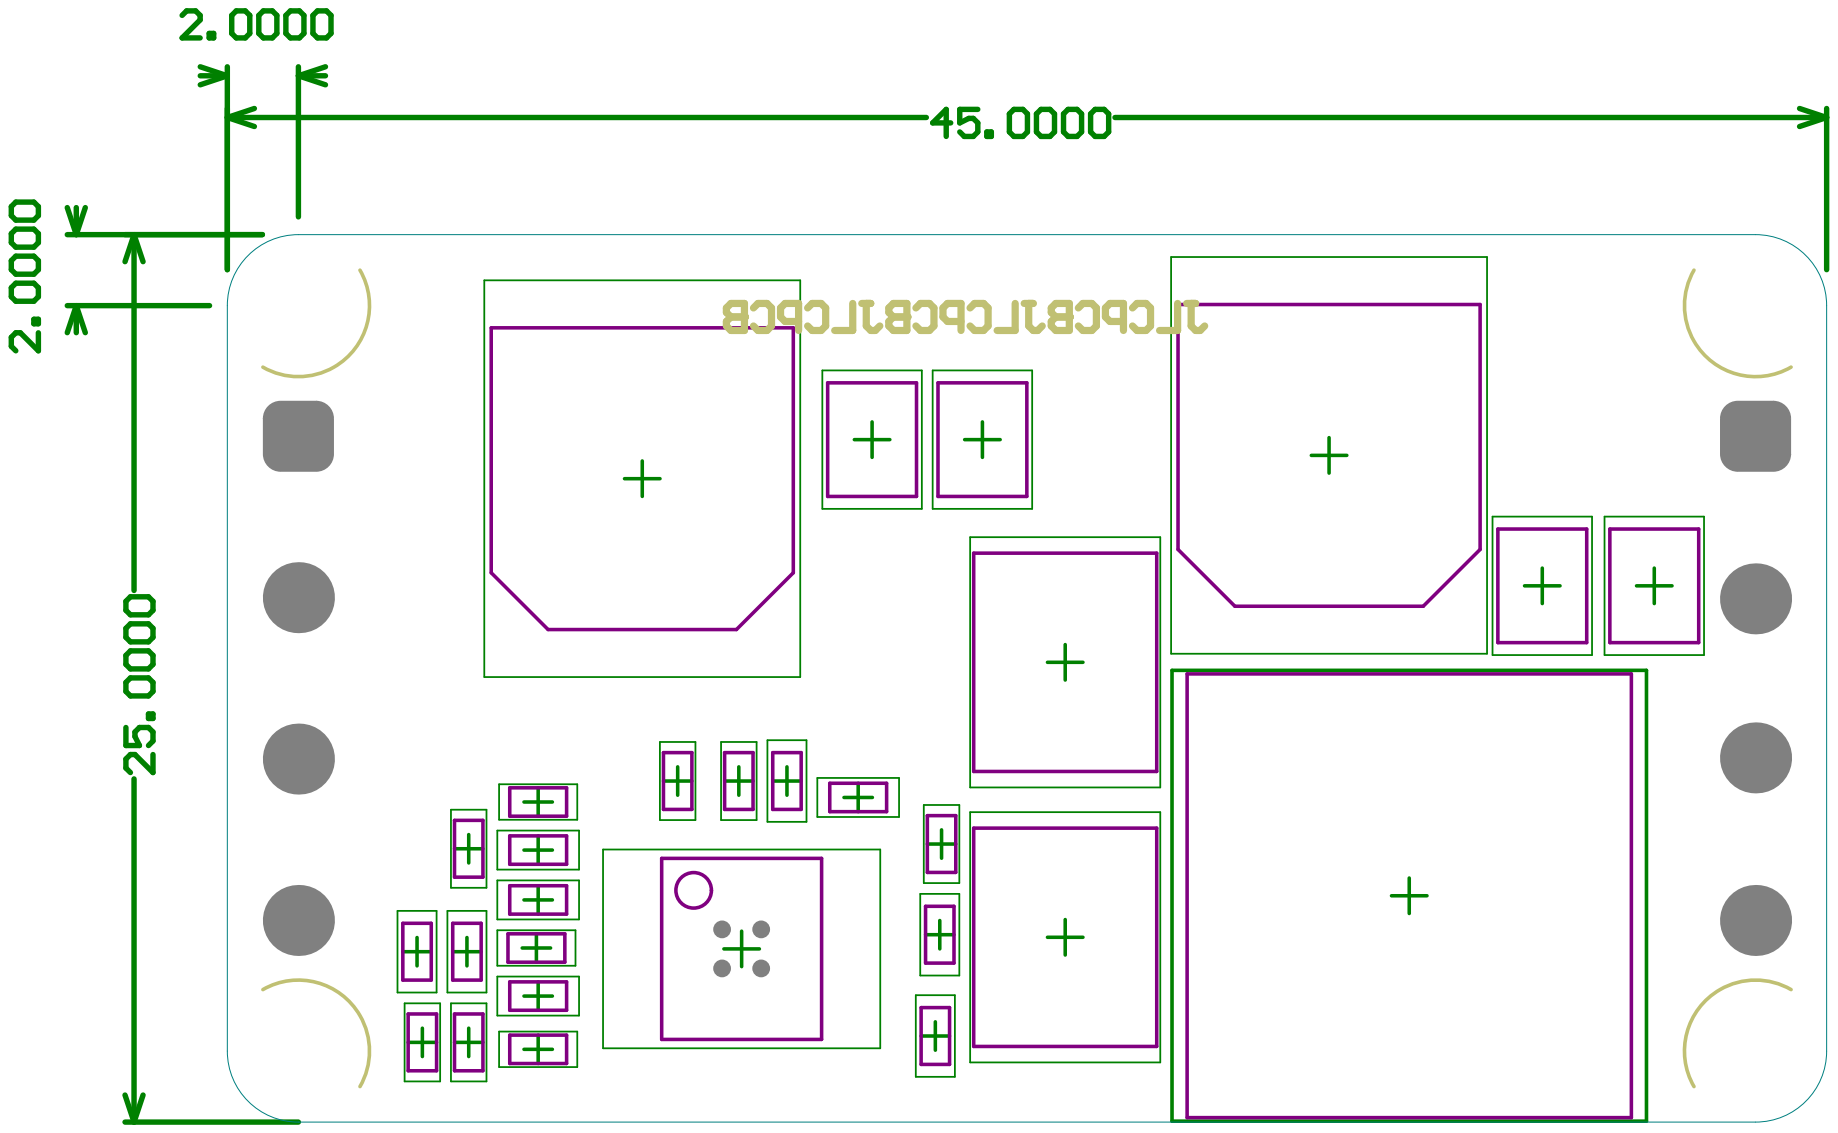
[picture p61: page 2]
