cskilbeck/xtl/pcbs/buck3/Outputs/2019-12-01 Rev2/Reports/DRC.PDF

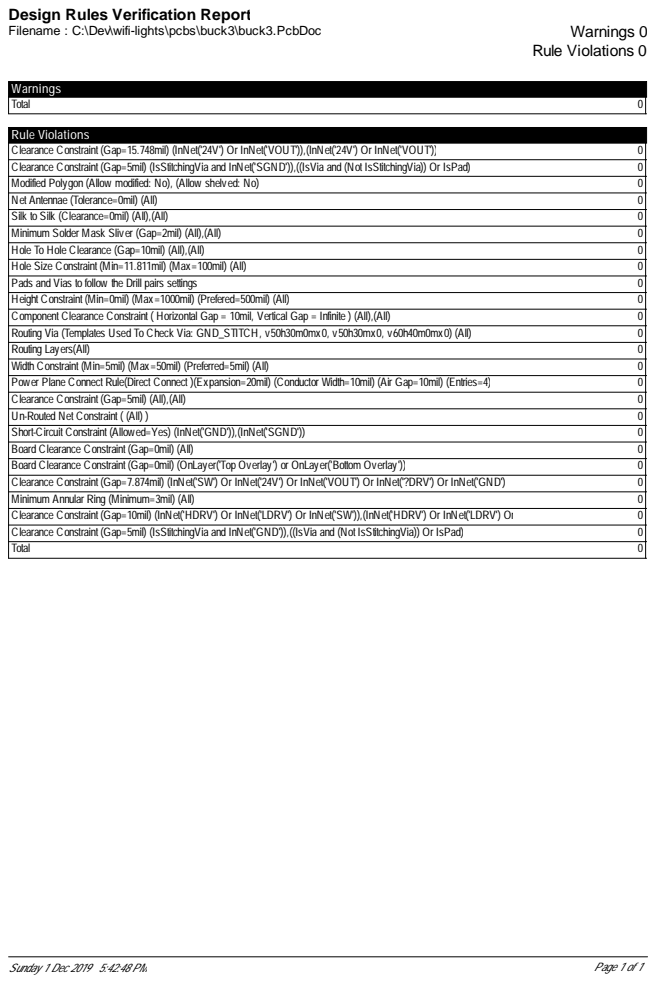
[picture p62: page 1]

Design Rules Verification Report
