cskilbeck/xtl/pcbs/buck3/Outputs/2019-12-01 Rev2/Reports/Schematic Prints.PDF

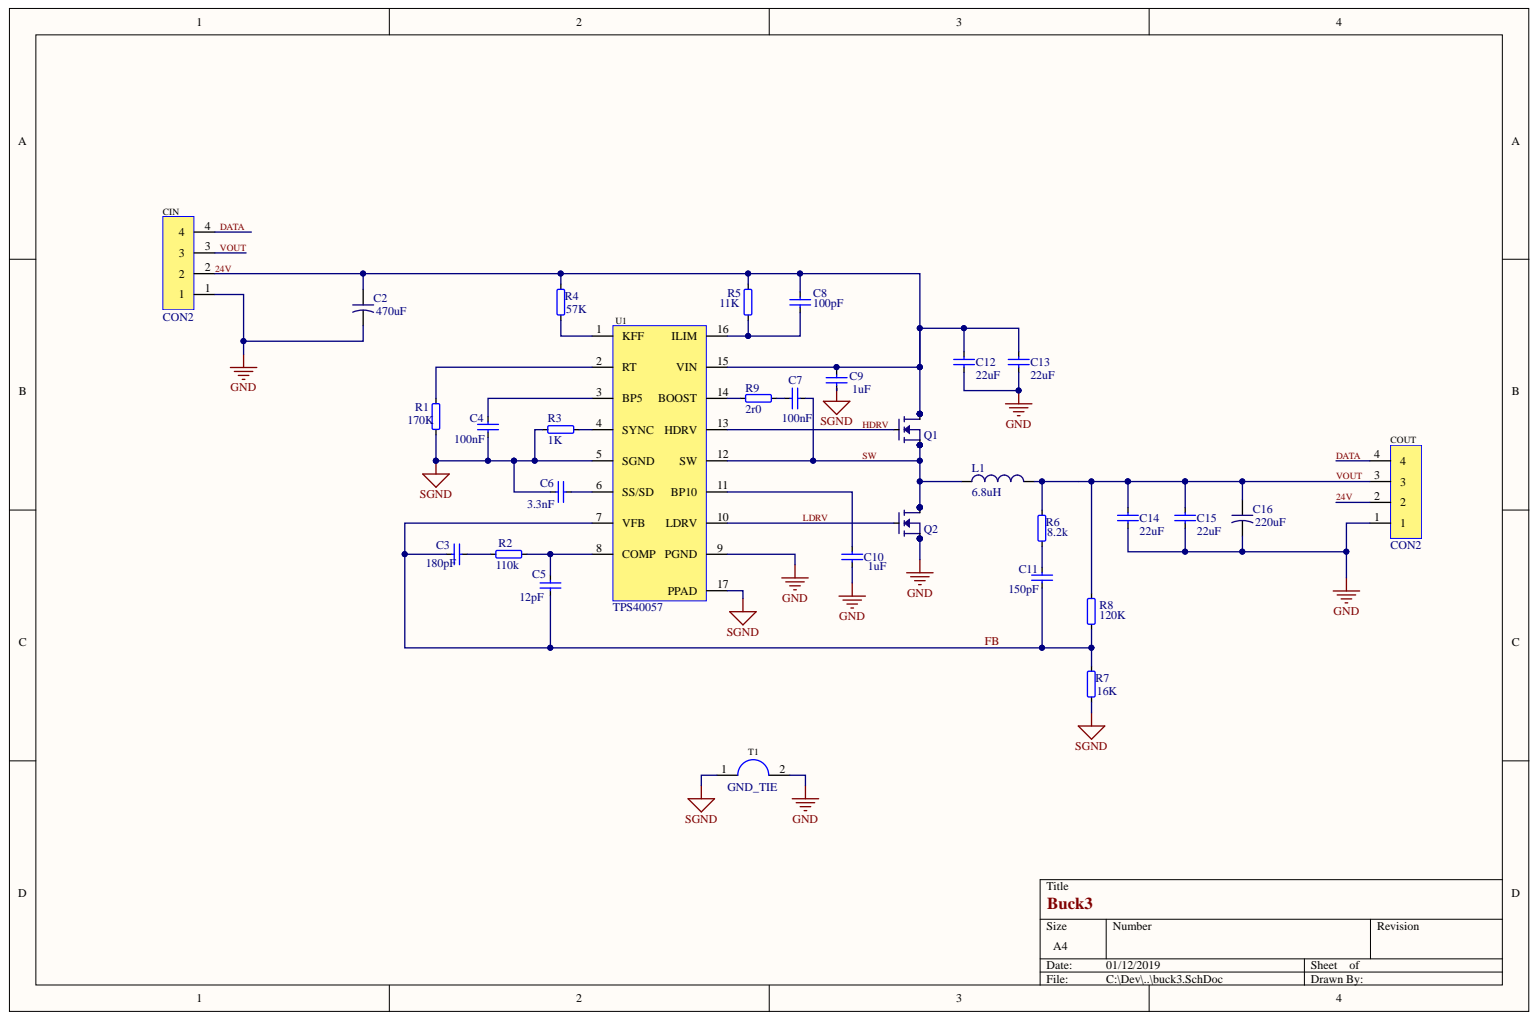
[picture p63: page 1]
