cskilbeck/xtl/pcbs/buck3/Outputs/2019-06-22 Rev2/DRC/DRC.PDF

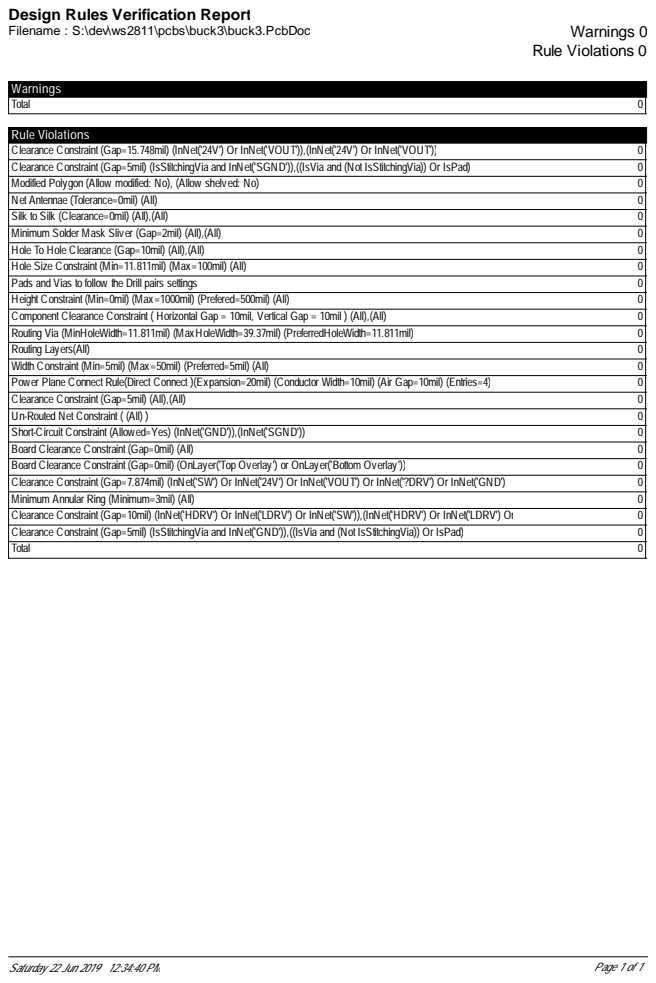
[picture p64: page 1]

Design Rules Verification Report
