cskilbeck/xtl/pcbs/controller_8266/Outputs/2020-05-29/controller_8266_report.PDF

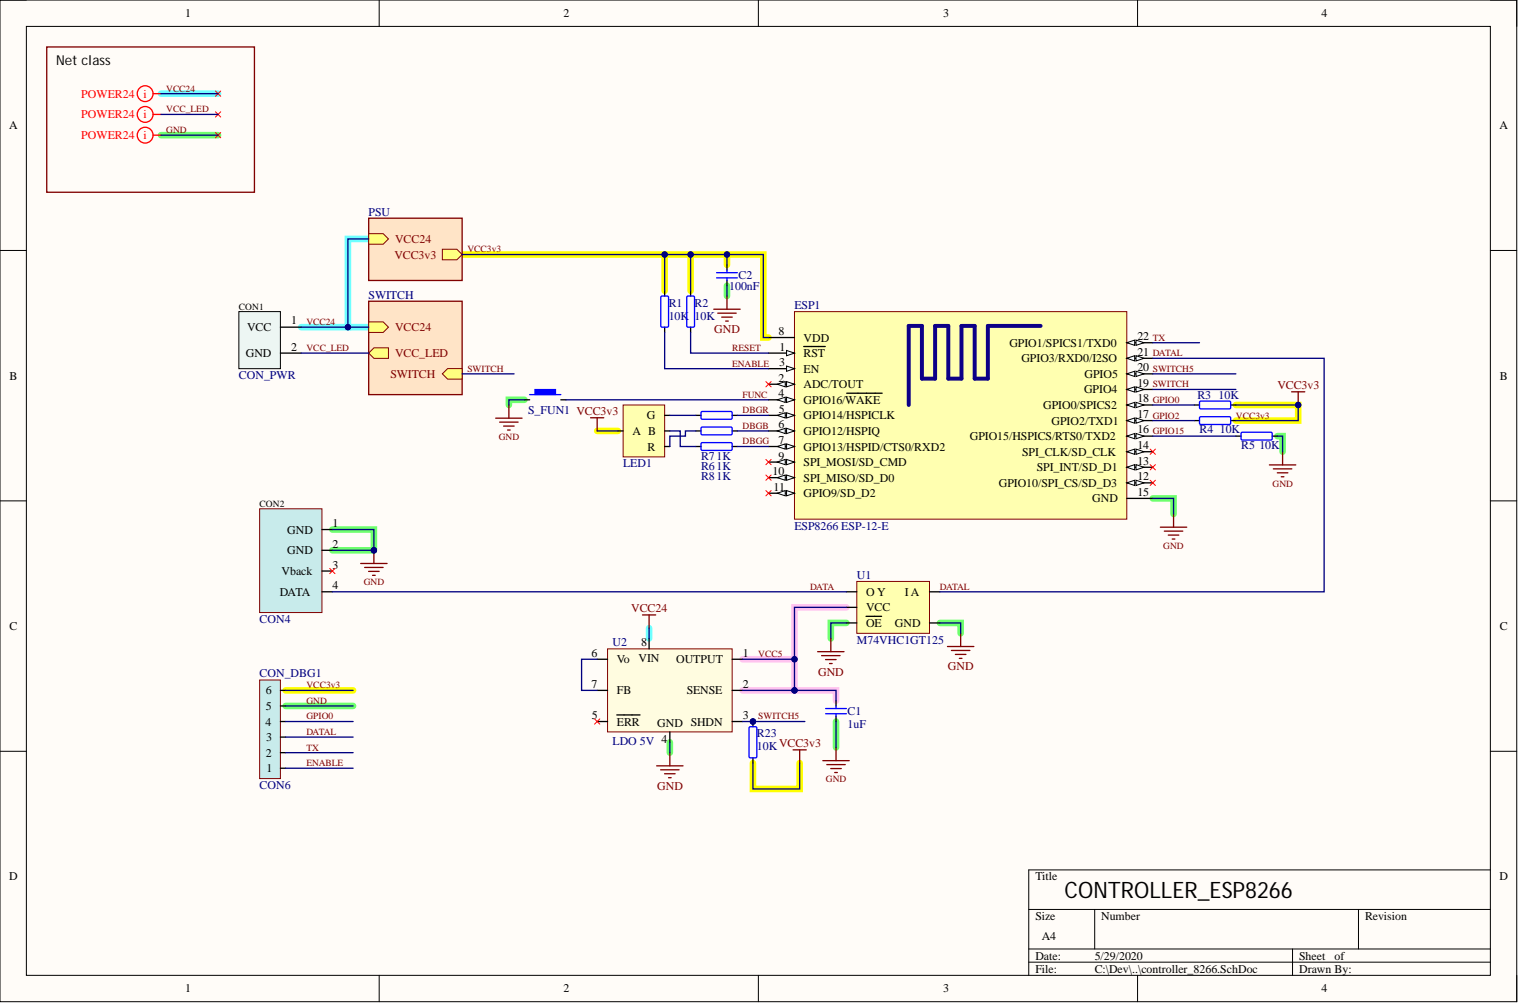
[picture p65: page 1]

VDD 8

RESET

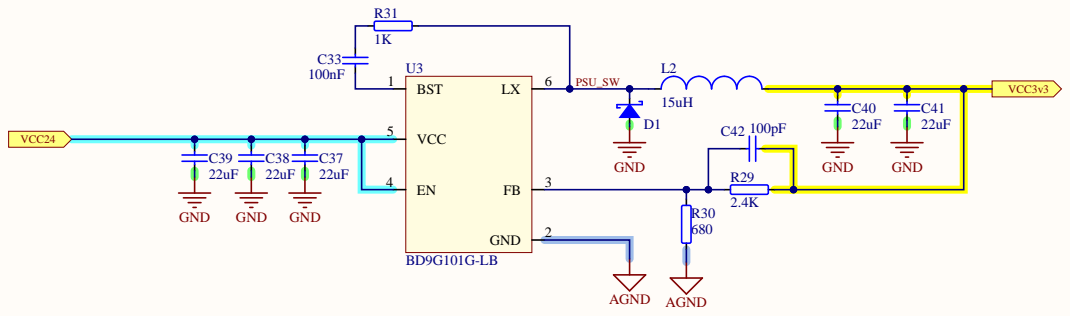
[picture p66: page 2]


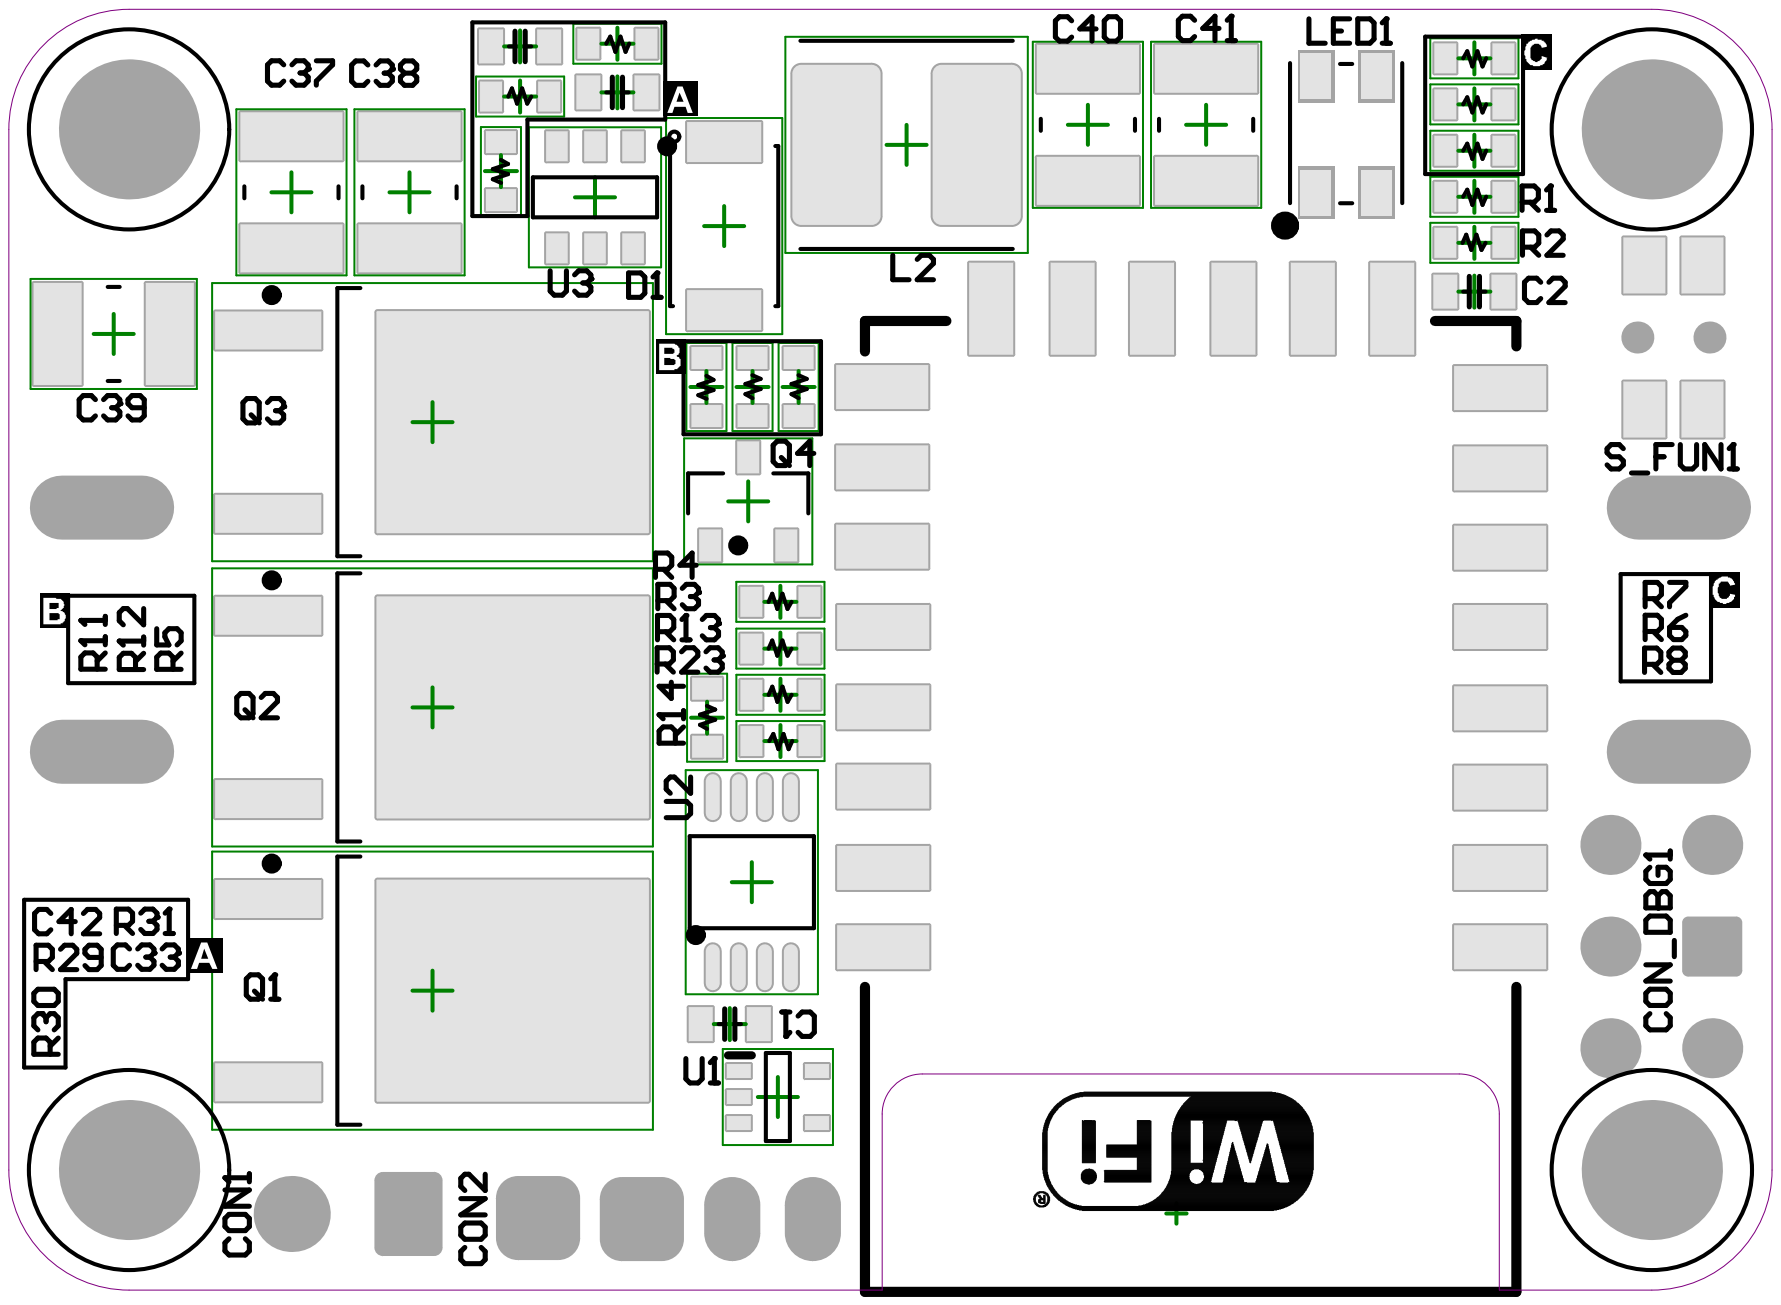
[picture p67: page 4]

Designator | Quantity | Value | Name | Description | Footprint | Model:Footprint | LibRef
C1 | 1 1uF | | Cap | Capacitor | CAPC_0603_1608X 08L | Chip Capacitor 0603 | Cap
C2, C33 | 2 100nF | | Cap | Capacitor | CAPC_0603_1608X 08L | Chip Capacitor 0603 | Cap
C37, C38, C39, C40, C41 | 5 22uF | | Cap | Capacitor | CAPC3224X25L | Chip Capacitor, 2-Leads, Body 3.20x2.45mm, IPC High Density | Cap
C42 | 1 100pF | | Cap | Capacitor | CAPC_0603_1608X 08L | Chip Capacitor 0603 | Cap
D1 | 1 | | Schottky 40V 3A | Schottky Diode | SODFL470X110-2L | SODFL, 2-Leads, Body 2.50x4.70mm, IPC High Density | D Schottky
ESP1 | 1 | | ESP8266 ESP-12-E | ESP8266 ESP-12-E | ESP8266 ESP-12-E | ESP8266 ESP-12-E | ESP8266 ESP-12-E
L2 | 1 15uH | | Inductor | Inductor | INDP5150X20L | Precision Wire Wound Inductor, 2-Leads, Body 5.15x5.00mm, IPC High Density | Inductor
LED1 | 1 | | RGB LED Common anode | Dot is _not_ anode! | PLCC-4 | LED | RGB_LED
Q1, Q2, Q3 | 3 | | MOSFET-P | | DPAK229P994X24 1-3L | D-PAK, 3-Pads, Body 6.21x6.73mm (max), IPC High Density | MOSFET-P
Q4 | 1 | | MOSFET-N | | SOT23 | SOT23, 3-Leads, Body 2.90x2.45mm, Pitch 0.95mm, IPC High Density | MOSFET-N
R1, R2, R3, R4, R5, R14, R23 | 7 10K | | Res2 | Resistor | RESC_0603_1608X 08L | Chip Resistor, 2-Leads, Body 1.60x0.80mm, IPC High Density | Res2
R6, R7, R8, R13, R31 | 5 1K | | Res2 | Resistor | RESC_0603_1608X 08L | Chip Resistor, 2-Leads, Body 1.60x0.80mm, IPC High Density | Res2
R11 | 1 220K | | Res2 | Resistor | RESC_0603_1608X 08L | Chip Resistor, 2-Leads, Body 1.60x0.80mm, IPC High Density | Res2
R12 | 1 100K | | Res2 | Resistor | RESC_0603_1608X 08L | Chip Resistor, 2-Leads, Body 1.60x0.80mm, IPC High Density | Res2
R29 | 1 2.4K | | Res2 | Resistor | RESC_0603_1608X 08L | Chip Resistor, 2-Leads, Body 1.60x0.80mm, IPC High Density | Res2
R30 | 1 680 | | Res2 | Resistor | RESC_0603_1608X 08L | Chip Resistor, 2-Leads, Body 1.60x0.80mm, IPC High Density | Res2
S_FUN1 | 1 | | 4-1437565-1 | Tactile switch | EVQP7C01P | Side actuated tactile switch | 4-1437565-1
U1 | 1 | | M74VHC1GT125 | Level shifter non inverting | SOT65P210X100-5L | SOT23, 5-Leads, Body 2.00x2.10mm, Pitch 0.65mm, IPC High Density | M74VHC1GT125
U2 | 1 | | LDO 5V | | Micro8 TSOP | TSOP, 8-Leads | LDO LP2950 5V
U3 | 1 | | BD9G101G-LB | | TSOP95P280X125-6L | TSOP, 6-Leads, Body 2.90x1.65mm, Pitch 0.95mm, IPC High Density | BD9G102G-LB

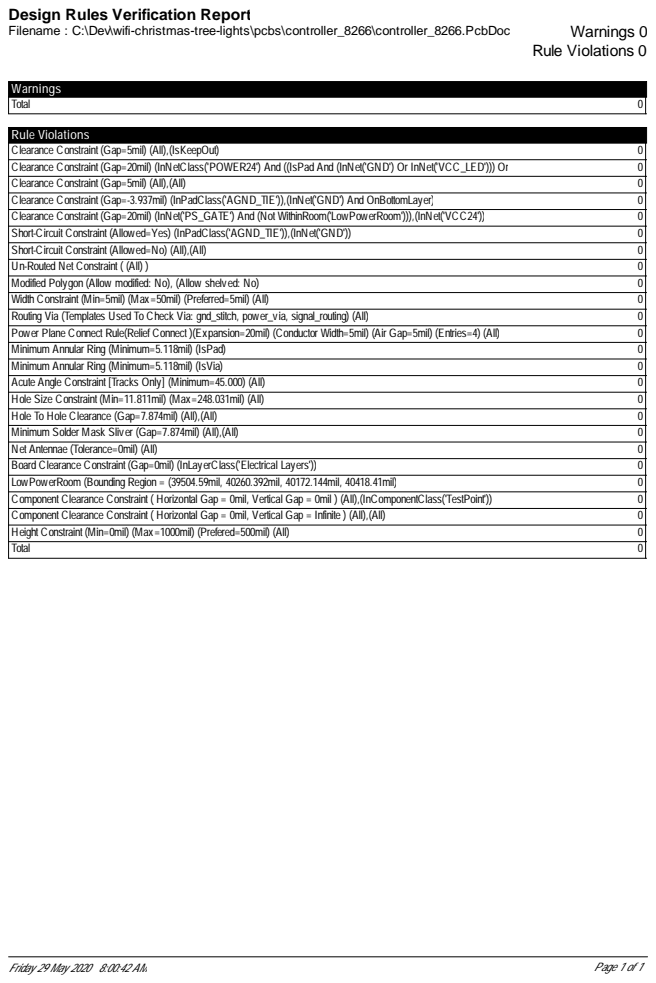
[picture p68: page 6]

Design Rules Verification Report
