cskilbeck/xtl/pcbs/controller_8266/Outputs/2020-05-22/controller_8266_report.PDF

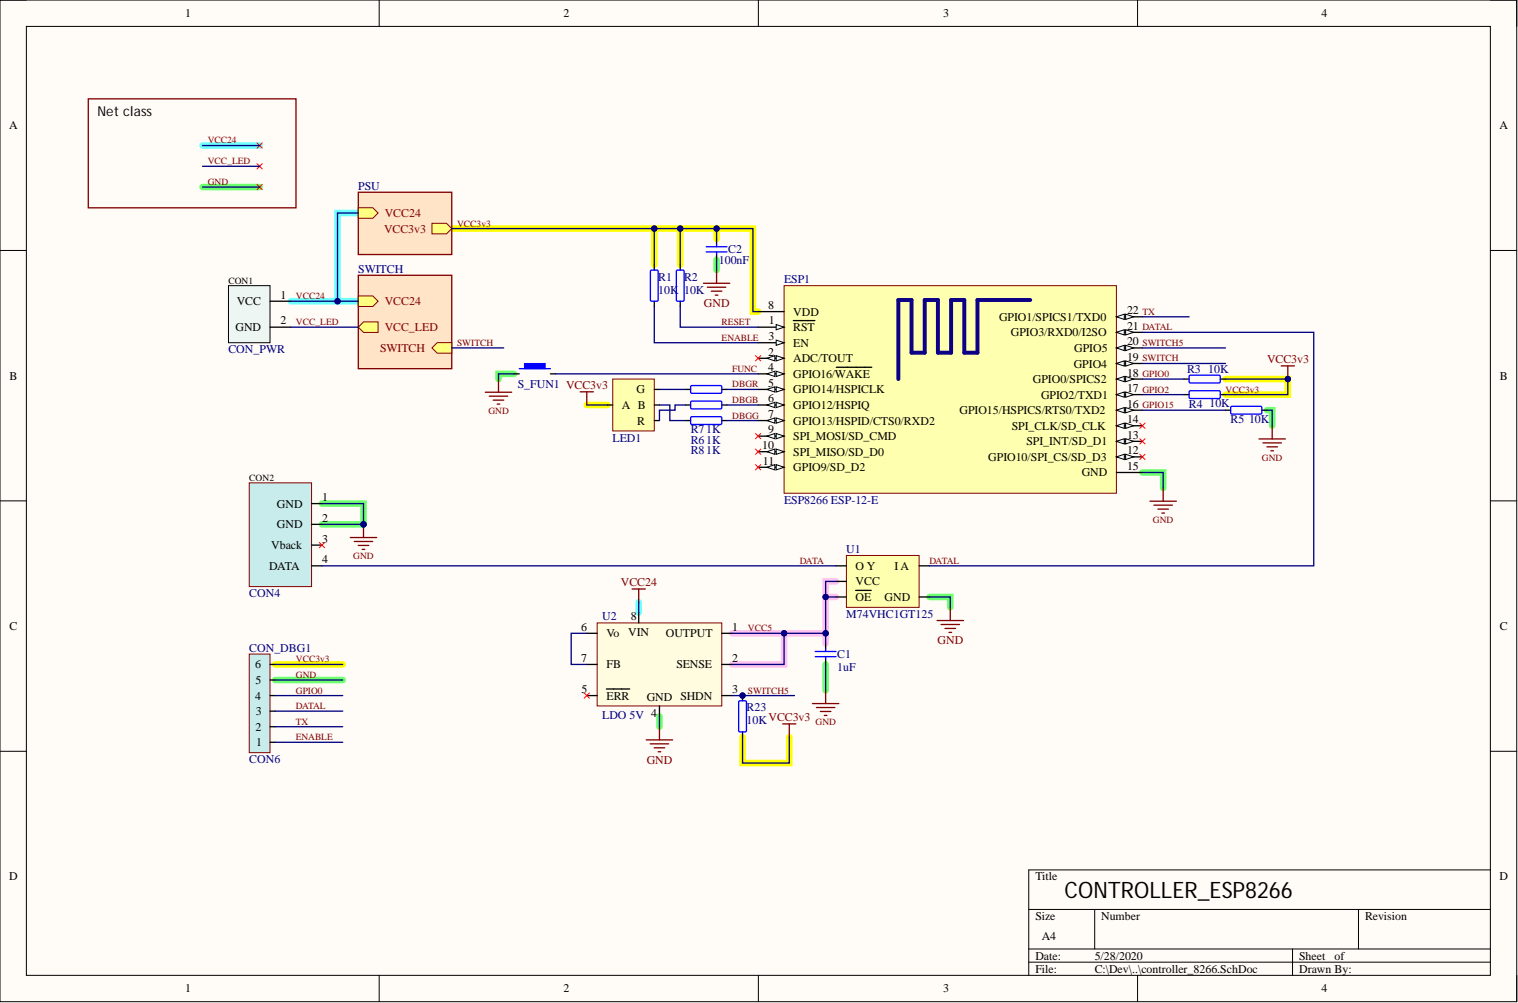
[picture p69: page 1]

GPIO15/HSPICS/RTS0/TXD2 | 16 GPIO2/TXD1 17 GPIO0/SPICS2 18 GPIO4 19 GPIO5 20 GPIO3/RXD0/I2SO 21 GPIO1/SPICS1/TXD0 22 SWITCH5 VCC3v

RESET

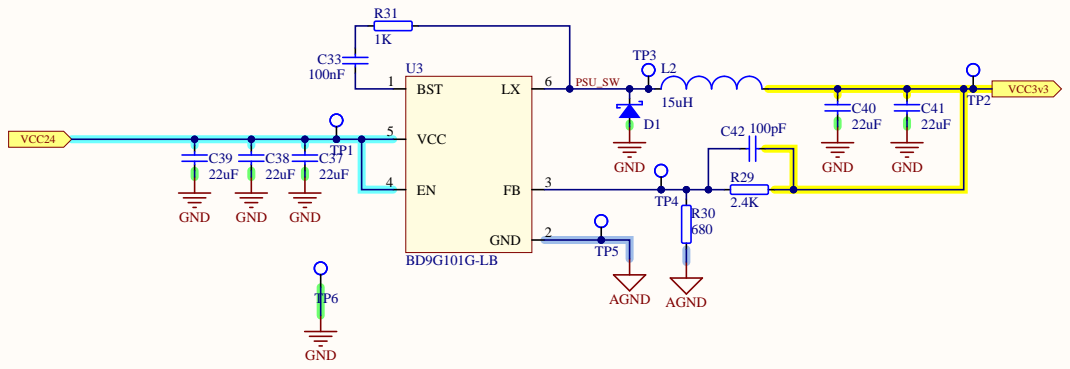
[picture p70: page 2]

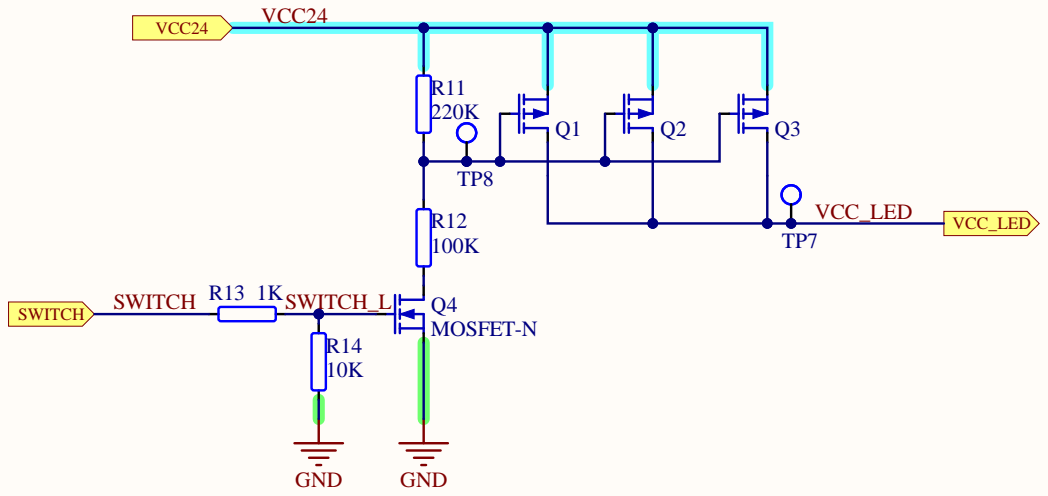
[picture p71: page 3]

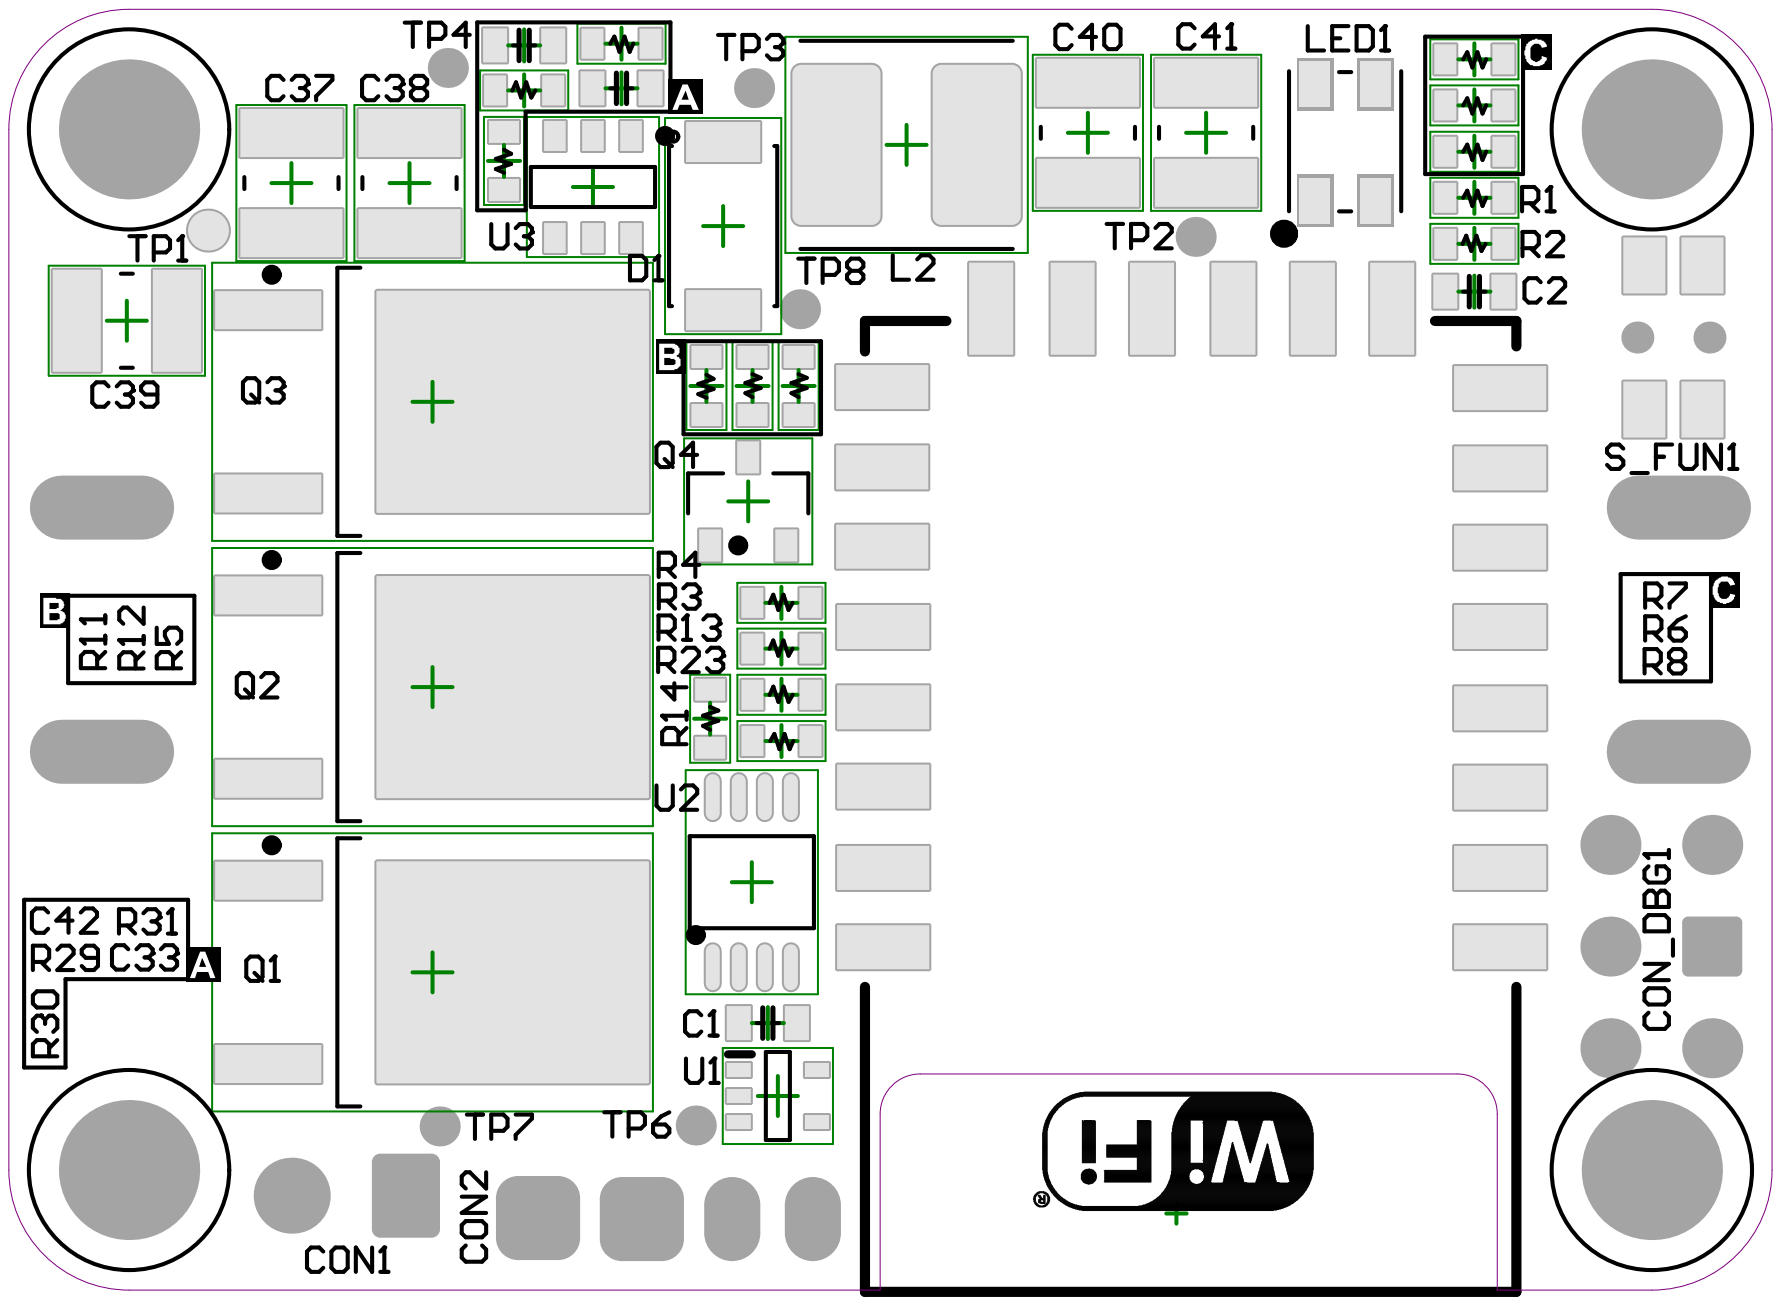
[picture p72: page 4]

Line # | Name | Description | Designator | Quantity | Footprint | Model:Footprint | LibRef | Value
| Cap | Capacitor | C1 | 1 CAPC_0603_1608X | 08L | Chip Capacitor 0603 | Cap | 1uF
| Cap | Capacitor | C2, C33 | 2 CAPC_0603_1608X | 08L | Chip Capacitor 0603 | Cap | 100nF
| Cap | Capacitor | C37, C38, C39, C40, C41 | 5 CAPC3224X25L | | Chip Capacitor, 2-Leads, Body 3.20x2.45mm, IPC High Density | Cap | 22uF
| Cap | Capacitor | C42 | 1 CAPC_0603_1608X | 08L | Chip Capacitor 0603 | Cap | 100pF
| Schottky 40V 3A | Schottky Diode | D1 | 1 SODFL470X110-2L | | SODFL, 2-Leads, Body 2.50x4.70mm, IPC High Density | D Schottky
| ESP8266 ESP-12-E | ESP8266 ESP-12-E | ESP1 | 1 ESP8266 ESP-12-E | | ESP8266 ESP-12-E | ESP8266 ESP-12-E
| Inductor | Inductor | L2 | 1 INDP5150X20L | | Precision Wire Wound Inductor, 2-Leads, Body 5.15x5.00mm, IPC High Density | Inductor | 15uH
| RGB LED Common anode | Dot is _not_ anode! | LED1 | 1 PLCC-4 | | LED | RGB_LED
| MOSFET-P | | Q1, Q2, Q3 | 3 DPAK229P994X24 | 1-3L | D-PAK, 3-Pads, Body 6.21x6.73mm (max), IPC High Density | MOSFET-P
| MOSFET-N | | Q4 | 1 SOT23 | | SOT23, 3-Leads, Body 2.90x2.45mm, Pitch 0.95mm, IPC High Density | MOSFET-N
| Res2 | Resistor | R1, R2, R3, R4, R5, R14, R23 | 7 RESC_0603_1608X | 08L | Chip Resistor, 2-Leads, Body 1.60x0.80mm, IPC High Density | Res2 | 10K
| Res2 | Resistor | R6, R7, R8, R13, R31 | 5 RESC_0603_1608X | 08L | Chip Resistor, 2-Leads, Body 1.60x0.80mm, IPC High Density | Res2 | 1K
| Res2 | Resistor | R11 | 1 RESC_0603_1608X | 08L | Chip Resistor, 2-Leads, Body 1.60x0.80mm, IPC High Density | Res2 | 220K
| Res2 | Resistor | R12 | 1 RESC_0603_1608X | 08L | Chip Resistor, 2-Leads, Body 1.60x0.80mm, IPC High Density | Res2 | 100K
| Res2 | Resistor | R29 | 1 RESC_0603_1608X | 08L | Chip Resistor, 2-Leads, Body 1.60x0.80mm, IPC High Density | Res2 | 2.4K
| Res2 | Resistor | R30 | 1 RESC_0603_1608X | 08L | Chip Resistor, 2-Leads, Body 1.60x0.80mm, IPC High Density | Res2 | 680
| 4-1437565-1 | Tactile switch | S_FUN1 | 1 EVQP7C01P | | Side actuated tactile switch | 4-1437565-1
| M74VHC1GT125 | Level shifter non inverting | U1 | 1 SOT65P210X100- | 5L | SOT23, 5-Leads, Body 2.00x2.10mm, Pitch 0.65mm, IPC High Density | M74VHC1GT125
| LDO 5V | | U2 | 1 Micro8 TSOP | | TSOP, 8-Leads | LDO LP2950 5V
| BD9G101G-LB | | U3 | 1 TSOP95P280X125- | 6L | TSOP, 6-Leads, Body 2.90x1.65mm, Pitch 0.95mm, IPC High Density | BD9G102G-LB

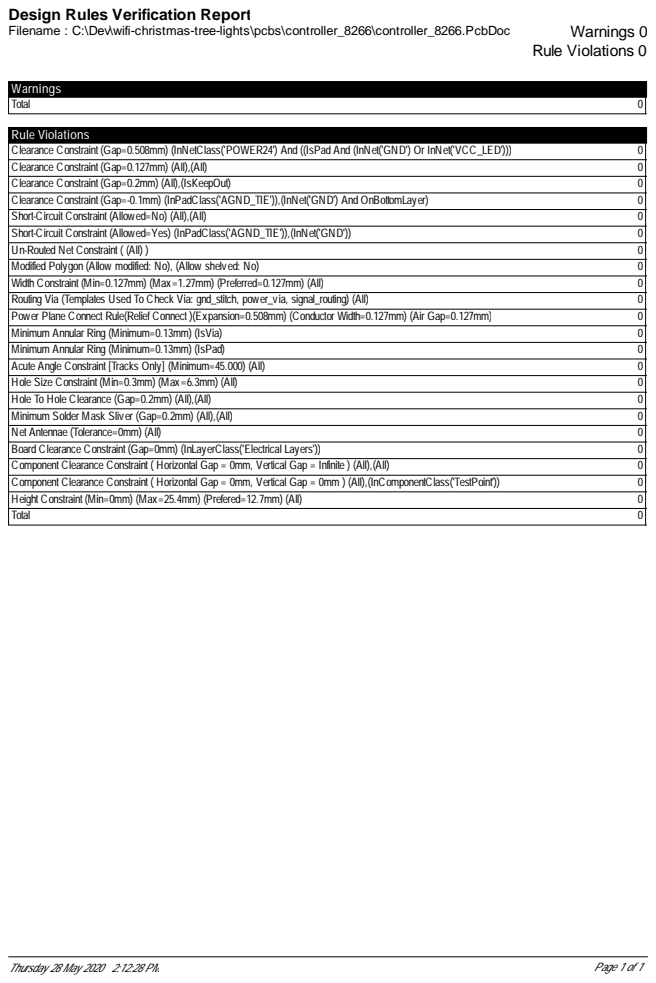
[picture p73: page 6]

Design Rules Verification Report
