cskilbeck/xtl/pcbs/buck4/Outputs/2020-07-17/aisler.PDF

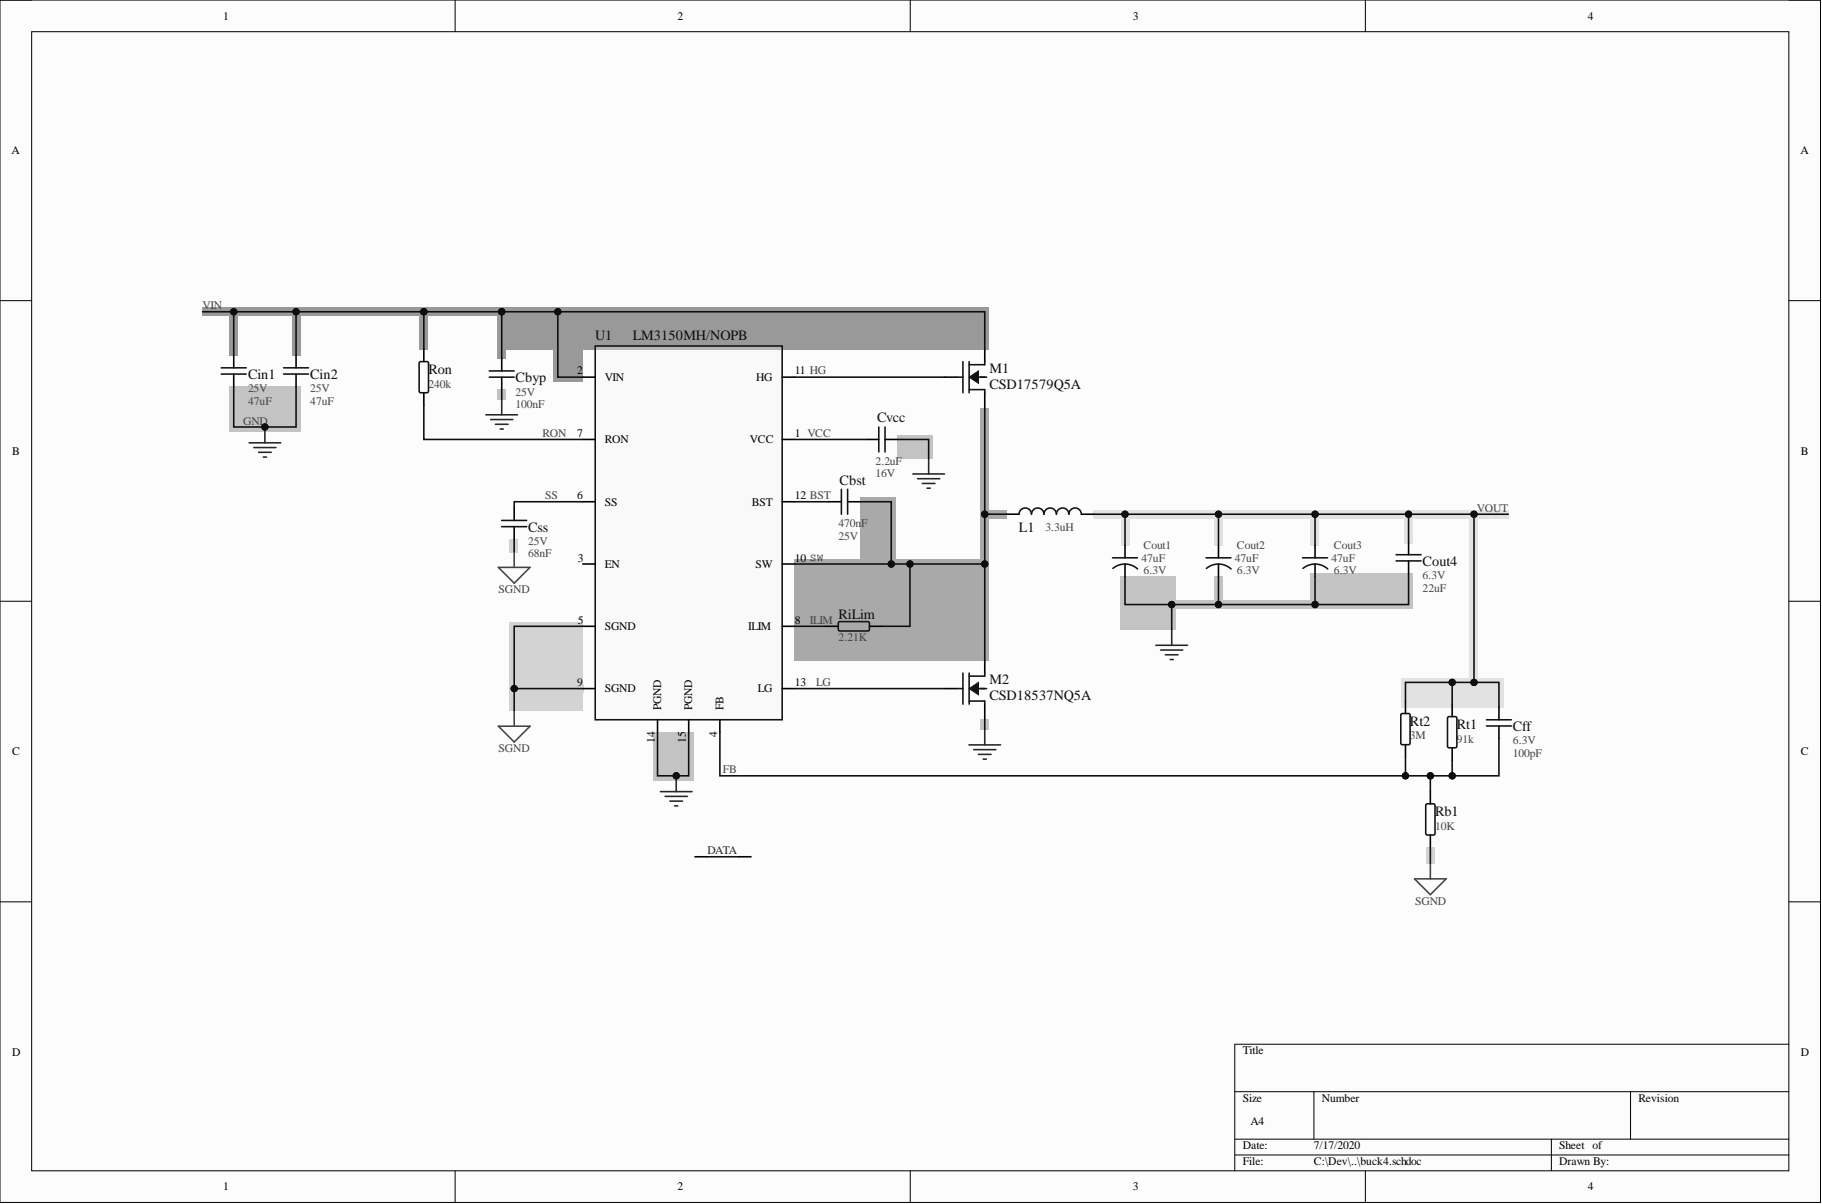
[picture p74: page 1]

8 ILIM 2.21K

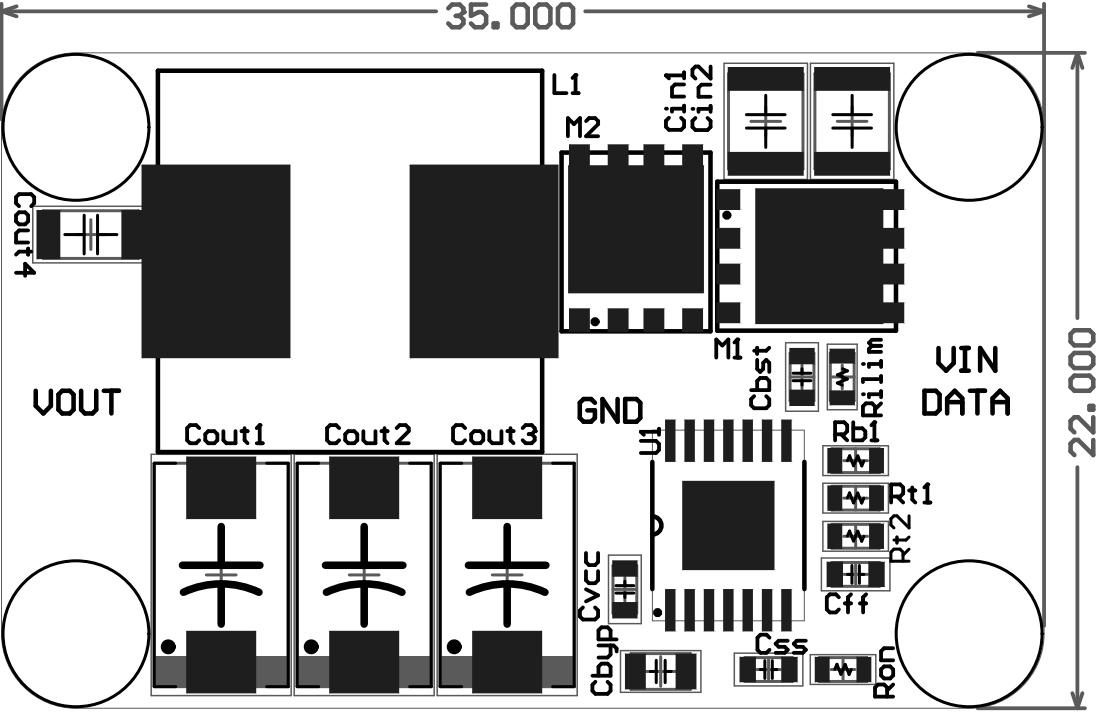
[picture p75: page 2]

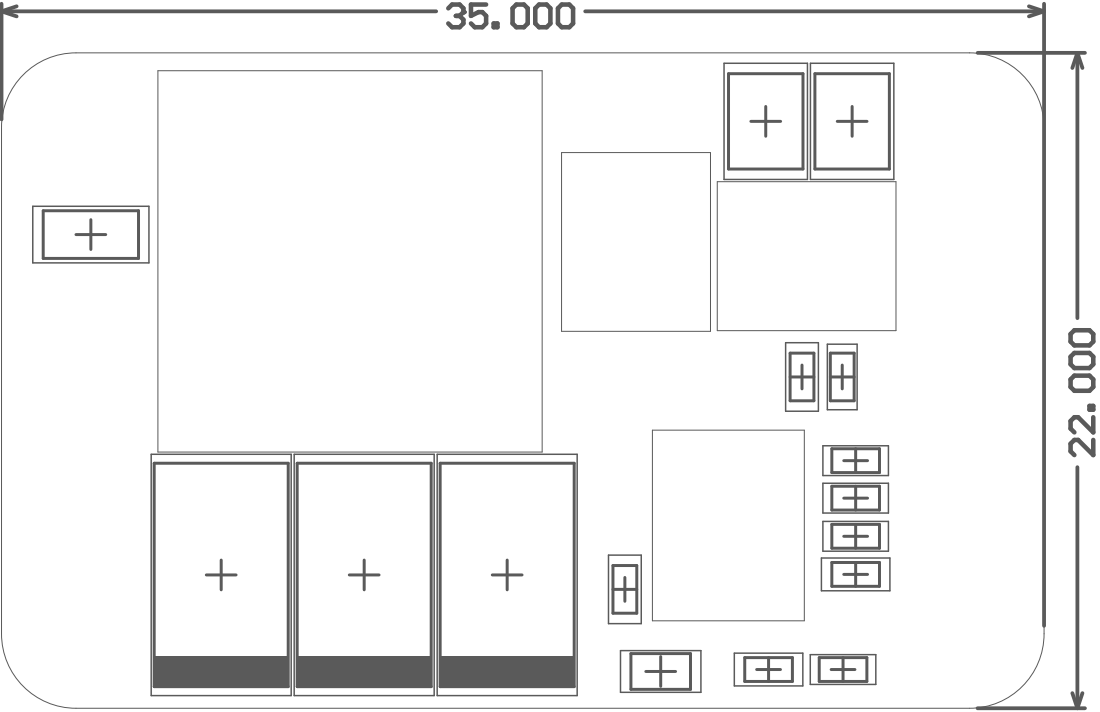
[picture p76: page 3]

Name | Designator | Quantity | MPN | Vendor | Footprint | Description | Voltage | Value
MLCC | Cbst | 1 | | | CAPC1608X08L | Multilayer Ceramic Capacitor | 25V | 470nF
MLCC | Cbyp | 1 | | | CAPC2012X12L | Multilayer Ceramic Capacitor | 25V | 100nF
MLCC | Cff | 1 | | | CAPC1608X08L | Multilayer Ceramic Capacitor | 6.3V | 100pF
MLCC | Cin1, Cin2 | 2 C3216X5R1E476M160AC | | TDK | CAPC3225X25L | Multilayer Ceramic Capacitor | 25V | 47uF
CAPACITOR | Cout1, Cout2, Cout3 | 3 EEFCS1A470R | | Pansonic | CAPMP7343X11L | Electrolytic Capacitor | 6.3V | 47uF
MLCC | Cout4 | 1 | | | CAPC3216X12L | Multilayer Ceramic Capacitor | 6.3V | 22uF
MLCC | Css | 1 | | | CAPC1608X08L | Multilayer Ceramic Capacitor | 25V | 68nF
MLCC | Cvcc | 1 | | | CAPC1608X08L | Multilayer Ceramic Capacitor | 16V | 2.2uF
744313330 | L1 | 1 744313330 | | Wurth Elektronik | WE-HCI_1335 | Inductor | | 3.3uH
CSD17579Q5A | M1 | 1 CSD17579Q5A | | Texas Instruments | TRANS_NexFET_Q5A | N Channel MOSFET
CSD18537NQ5A | M2 | 1 CSD18537NQ5A | | Texas Instruments | TRANS_NexFET_Q5A | N Channel MOSFET
RES0603 | Rb1 | 1 | | | RESC1608X03L | Chip Resistor | | 10K
RES0603 | RiLim | 1 | | | RESC1608X03L | Chip Resistor | | 2.21K
RES0603 | Ron | 1 | | | RESC1608X03L | Chip Resistor | | 240k
RES0603 | Rt1 | 1 | | | RESC1608X03L | Chip Resistor | | 91k
RES0603 | Rt2 | 1 | | | RESC1608X03L | Chip Resistor | | 3M
LM3150MH/NOPB | U1 | 1 LM3150MH/NOPB | | Texas Instruments | MXA14A | Buck controller

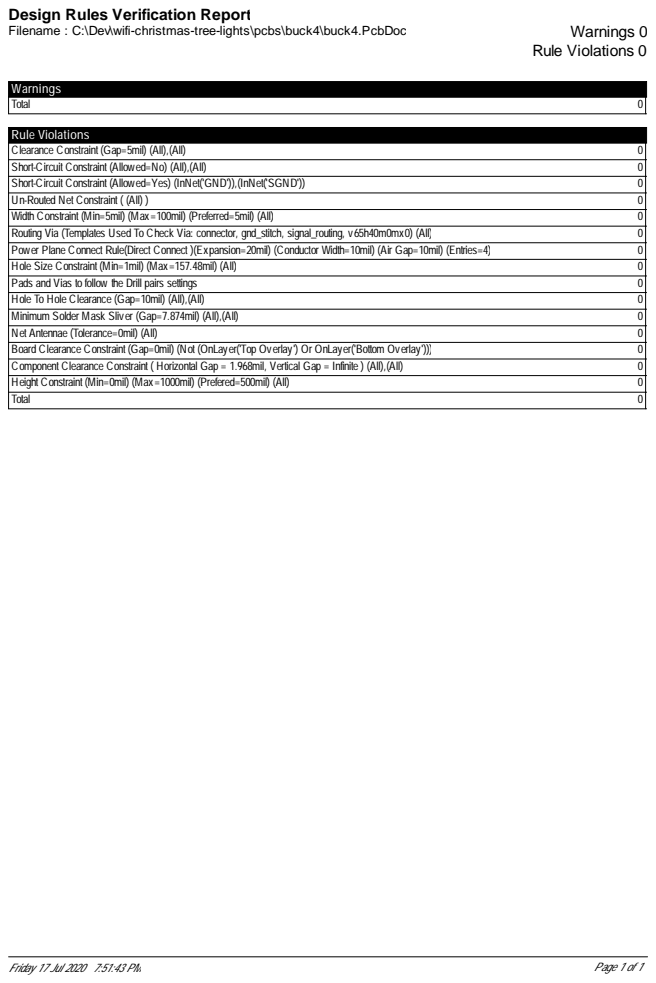
[picture p77: page 5]

Design Rules Verification Report
