cskilbeck/xtl/(list of files, drawings)

Other design files:
pcbs/buck2/Buck2/buck2.PcbDoc
pcbs/buck2/Buck2/buck2.PcbLib
pcbs/buck2/Buck2/Buck2.PrjPcb
pcbs/buck2/Buck2/buck2.SchDoc
pcbs/buck2/Buck2/buck2.SchLib
pcbs/buck2/Buck2/controller.SchDoc
pcbs/buck2/controller.PcbDoc
pcbs/buck2/Controller.PrjPcb
pcbs/buck2/level_shifter.SchDoc
pcbs/buck3/buck3.PcbDoc
pcbs/buck3/buck3.PcbLib
pcbs/buck3/buck3.PrjPcb
pcbs/buck3/buck3.SchDoc
pcbs/buck3/buck3.SchLib
pcbs/buck4/2020-05-30_00-24-19.PcbLib
pcbs/buck4/2020-05-30_00-24-19.SchLib
pcbs/buck4/2020-05-30_00-24-191.schdoc
pcbs/buck4/buck4.PcbDoc
pcbs/buck4/buck4.PcbLib
pcbs/buck4/buck4.PrjPcb
pcbs/buck4/buck4.schdoc
pcbs/buck4/buck4.SchLib
pcbs/buck/Buck.PcbDoc
pcbs/buck/Buck.PrjPcb
pcbs/buck/XmasLights.PcbDoc
pcbs/buck/XmasLights.SchDoc
pcbs/controller/Buck5.SchDoc
pcbs/controller/Buck.SchDoc
pcbs/controller/Controller.PcbDoc
pcbs/controller/Controller.PcbLib
pcbs/controller/Controller.SchDoc
pcbs/controller/Controller.SCHLIB
pcbs/controller/PCB_Project1.PrjPCB
pcbs/controller/PowerBuck.SchDoc
pcbs/controller/Schlib1.SchLib
pcbs/controller/Sheet1.SchDoc
pcbs/controller/Sheet2.SchDoc
pcbs/controller_8266/controller_8266.PrjPcb
pcbs/controller_8266/controller_8266.SchDoc
pcbs/controller_8266/controller_8266.SchLib
pcbs/controller_8266/controller_8266_psu.SchDoc
pcbs/controller_8266/controller_8266_switch.SchDoc
pcbs/led/led.SchDoc
pcbs/led/led_Schlib.SchLib
pcbs/pixel/pixel.PcbDoc
pcbs/pixel/pixel.PcbLib
pcbs/pixel/pixel.PrjPcb
pcbs/pixel/pixel.SchDoc
pcbs/pixel/pixel.SchLib
