cskilbeck/xtl/esp8266/controller_esp8266/main/hello_world_main.cpp

//////////////////////////////////////////////////////////////////////
// neopixels

#include <stdio.h>
#include <math.h>
#include <string.h>
#include <cstddef>
#include "freertos/FreeRTOS.h"
#include "freertos/task.h"
#include "freertos/event_groups.h"
#include "driver/hw_timer.h"
#include "esp_system.h"
#include "esp_log.h"
#include "esp_wifi.h"
#include "esp_event_loop.h"
#include "nvs_flash.h"
#include "tcpip_adapter.h"
#include "esp_smartconfig.h"
#include "smartconfig_ack.h"

#include "util.h"
#include "debug.h"
#include "neopixel.h"
#include "wifi.h"
#include "button.h"
#include "color.h"
#include "settings.h"
#include "effect.h"
#include "power.h"

//////////////////////////////////////////////////////////////////////

TaskHandle_t vblank_task_handle = null;
int frames = 0;

//////////////////////////////////////////////////////////////////////

void IRAM_ATTR hw_timer_callback(void *arg)
{
    if(xTaskResumeFromISR(vblank_task_handle)) {
        taskYIELD();
    }
}

//////////////////////////////////////////////////////////////////////

void frame_update()
{
    byte *frame_buffer = neopixel_get_frame_buffer();
    effect::frame_update(frame_buffer);

#if 0
    int x = (frames * 5) & 0xff;
    x = (x * x) >> 8;
    int r = x;
    int g = (x * 0xb0) >> 8;
    int b = (x * 0xb0) >> 8;
    byte *p = frame_buffer;
    for(int i = 0; i < num_leds; ++i) {
        *p++ = r;
        *p++ = g;
        *p++ = b;
    }
#endif
}

//////////////////////////////////////////////////////////////////////

void vblank_task(void *)
{
    hw_timer_init(hw_timer_callback, null);
    hw_timer_alarm_us(1000000 / 60, true);

    neopixel_init(num_leds);

    debug_set_color(debug_color::blue);
    button_init();

    int button_frames = 0;

    while(1) {
        vTaskSuspend(null);
        neopixel_update();
        button_update();
        if(button_pressed) {
            debug_flash(debug_color::red, debug_color::off, 5, 5);
        }
        if(button_down) {
            button_frames += 1;
            if(button_frames == 5 * 60) {
                wifi_reset();
                __builtin_unreachable();
            }
        } else {
            button_frames = 0;
        }
        debug_update();
        frame_update();
        frames += 1;
    }
}

//////////////////////////////////////////////////////////////////////

extern "C" void app_main()
{
    esp_err_t ret = nvs_flash_init();
    if(ret == ESP_ERR_NVS_NO_FREE_PAGES) {
        ESP_ERROR_CHECK(nvs_flash_erase());
        ret = nvs_flash_init();
    }
    ESP_ERROR_CHECK(ret);

    powerswitch_init();
    powerswitch_set(false);

    settings_queue = xQueueCreate(2, sizeof(settings_t));
    settings_t::init();

    debug_init();
    wifi_init();
    xTaskCreate(vblank_task, "vblank_task", 2048, null, 15, &vblank_task_handle);
}
