cskilbeck/xtl/stm030/controller/Src/spi_leds.c

//////////////////////////////////////////////////////////////////////

#include "main.h"
#include "spi_leds.h"

//////////////////////////////////////////////////////////////////////

int frames = 0;

//////////////////////////////////////////////////////////////////////

#define SPI_SIZE 30    // # of uint32s in circular SPI buffer

static uint32 frame_buffer[2][NUM_LED_DWORDS];
static uint32 spi_buffer[SPI_SIZE];
static volatile uint32 *source_address;
static volatile uint32 *end_address;
static volatile int drain = 0;

//////////////////////////////////////////////////////////////////////
// table for expanding one byte to 5 bytes
// bits are translated so
// 0 = 10000
// 1 = 11110

// NB these are actually inverted (01111 / 00001) because the level-shifter inverts the signal
// see also use of 0xffffffff for the reset section in fill_half() rather than 0x00000000

uint64 const five_1[256] = {
    0xefbdf7de7b, 0xe1bdf7de7b, 0x2fbcf7de7b, 0x21bcf7de7b, 0xef85f7de7b, 0xe185f7de7b, 0x2f84f7de7b, 0x2184f7de7b, 0xefbdf0de7b, 0xe1bdf0de7b, 0x2fbcf0de7b, 0x21bcf0de7b,
    0xef85f0de7b, 0xe185f0de7b, 0x2f84f0de7b, 0x2184f0de7b, 0xefbd17de7b, 0xe1bd17de7b, 0x2fbc17de7b, 0x21bc17de7b, 0xef8517de7b, 0xe18517de7b, 0x2f8417de7b, 0x218417de7b,
    0xefbd10de7b, 0xe1bd10de7b, 0x2fbc10de7b, 0x21bc10de7b, 0xef8510de7b, 0xe18510de7b, 0x2f8410de7b, 0x218410de7b, 0xefbdf7c27b, 0xe1bdf7c27b, 0x2fbcf7c27b, 0x21bcf7c27b,
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
        volatile uint32 *p = dst;
        volatile uint32 *q = dst + SPI_SIZE / 2;
        while(p < q) {
            *p++ = 0xffffffff;
        }
        drain -= 1;
    }
}

//////////////////////////////////////////////////////////////////////
// spi dma reached halfway, fill in the first half

void HAL_SPI_TxHalfCpltCallback(SPI_HandleTypeDef *spi)
{
    fill_half(spi_buffer);
}

//////////////////////////////////////////////////////////////////////
// spi dma reached the end of the buffer, fill in the second half

void HAL_SPI_TxCpltCallback(SPI_HandleTypeDef *spi)
{
    fill_half(spi_buffer + (SPI_SIZE / 2));
}

//////////////////////////////////////////////////////////////////////
// wait for previous transmit to complete,
// toggle rgb back buffer
// prime the spi dma buffer
// kick off another

void spi_leds_send()
{
    while(drain > 0) {
    }

    HAL_SPI_DMAStop(&hspi1);
    drain = 3;
    source_address = frame_buffer[frames & 1];
    end_address = source_address + NUM_LED_DWORDS;
    fill_half(spi_buffer);
    fill_half(spi_buffer + (SPI_SIZE / 2));

    HAL_SPI_Transmit_DMA(&hspi1, (uint8_t *)spi_buffer, SPI_SIZE * 4);

    frames += 1;
}

//////////////////////////////////////////////////////////////////////
// get rgb frame buffer to render into this frame

uint32 *current_frame_buffer()
{
    return frame_buffer[frames & 1];
}
