cskilbeck/xtl/esp8266/controller_esp8266/main/power.h

//////////////////////////////////////////////////////////////////////

#pragma once

//////////////////////////////////////////////////////////////////////

void powerswitch_init();
void powerswitch_set(bool on_or_off);
