cskilbeck/xtl/esp32/main/effect_list.h

EFFECTOR(red)
EFFECTOR(green)
EFFECTOR(blue)
EFFECTOR(cyan)
EFFECTOR(magenta)
EFFECTOR(yellow)
EFFECTOR(orange)
EFFECTOR(white)
EFFECTOR(dim)
EFFECTOR(candy)
EFFECTOR(sine)
EFFECTOR(spark)
EFFECTOR(pulse)
EFFECTOR(solid)
EFFECTOR(flash)
EFFECTOR(sparkle)
EFFECTOR(twinkle)
EFFECTOR(glow)
