cskilbeck/xtl/esp32/main/neopixel.h

//////////////////////////////////////////////////////////////////////

#pragma once

//////////////////////////////////////////////////////////////////////

void neopixel_init();
void neopixel_write(byte const *rgb, int num_leds);

//////////////////////////////////////////////////////////////////////
