cskilbeck/xtl/esp8266/controller_esp8266/main/button.h

#pragma once

//////////////////////////////////////////////////////////////////////

extern bool button_down;
extern bool button_last;
extern bool button_pressed;
extern bool button_released;

void button_init();
void button_update();
