cskilbeck/xtl/esp8266/lights/types.h

#pragma once

//////////////////////////////////////////////////////////////////////

typedef signed int int32;
typedef unsigned int uint32;
typedef unsigned short uint16;
typedef signed short int16;
typedef signed char int8;
typedef unsigned char uint8;
typedef unsigned char byte;
typedef unsigned int uint;

#define null 0
