cskilbeck/xtl/stm030/controller/Inc/spi.h

//////////////////////////////////////////////////////////////////////

#pragma once

//////////////////////////////////////////////////////////////////////

extern int frames;

//////////////////////////////////////////////////////////////////////

uint32 *current_frame_buffer(void);
void begin_frame(void);
void end_frame(void);

//////////////////////////////////////////////////////////////////////
