cskilbeck/xtl/stm103/Src/util.cpp

#include "types.h"
#include "main.h"
#include "util.h"

//////////////////////////////////////////////////////////////////////

namespace
{
    Random default_rng(1);
}

//////////////////////////////////////////////////////////////////////

uint8 const sine_table[512] = {
    0x00, 0x00, 0x01, 0x02, 0x03, 0x03, 0x04, 0x05, 0x06, 0x07, 0x07, 0x08, 0x09, 0x0a, 0x0a, 0x0b, 0x0c, 0x0d, 0x0e, 0x0e, 0x0f, 0x10, 0x11, 0x12, 0x12, 0x13, 0x14, 0x15, 0x15,
    0x16, 0x17, 0x18, 0x19, 0x19, 0x1a, 0x1b, 0x1c, 0x1c, 0x1d, 0x1e, 0x1f, 0x20, 0x20, 0x21, 0x22, 0x23, 0x24, 0x24, 0x25, 0x26, 0x27, 0x27, 0x28, 0x29, 0x2a, 0x2a, 0x2b, 0x2c,
    0x2d, 0x2e, 0x2e, 0x2f, 0x30, 0x31, 0x31, 0x32, 0x33, 0x34, 0x35, 0x35, 0x36, 0x37, 0x38, 0x38, 0x39, 0x3a, 0x3b, 0x3b, 0x3c, 0x3d, 0x3e, 0x3e, 0x3f, 0x40, 0x41, 0x42, 0x42,
    0x43, 0x44, 0x45, 0x45, 0x46, 0x47, 0x48, 0x48, 0x49, 0x4a, 0x4b, 0x4b, 0x4c, 0x4d, 0x4e, 0x4e, 0x4f, 0x50, 0x51, 0x51, 0x52, 0x53, 0x54, 0x54, 0x55, 0x56, 0x56, 0x57, 0x58,
    0x59, 0x59, 0x5a, 0x5b, 0x5c, 0x5c, 0x5d, 0x5e, 0x5f, 0x5f, 0x60, 0x61, 0x61, 0x62, 0x63, 0x64, 0x64, 0x65, 0x66, 0x67, 0x67, 0x68, 0x69, 0x69, 0x6a, 0x6b, 0x6c, 0x6c, 0x6d,
    0x6e, 0x6e, 0x6f, 0x70, 0x70, 0x71, 0x72, 0x73, 0x73, 0x74, 0x75, 0x75, 0x76, 0x77, 0x77, 0x78, 0x79, 0x7a, 0x7a, 0x7b, 0x7c, 0x7c, 0x7d, 0x7e, 0x7e, 0x7f, 0x80, 0x80, 0x81,
    0x82, 0x82, 0x83, 0x84, 0x84, 0x85, 0x86, 0x86, 0x87, 0x88, 0x88, 0x89, 0x8a, 0x8a, 0x8b, 0x8c, 0x8c, 0x8d, 0x8e, 0x8e, 0x8f, 0x90, 0x90, 0x91, 0x92, 0x92, 0x93, 0x94, 0x94,
    0x95, 0x95, 0x96, 0x97, 0x97, 0x98, 0x99, 0x99, 0x9a, 0x9b, 0x9b, 0x9c, 0x9c, 0x9d, 0x9e, 0x9e, 0x9f, 0x9f, 0xa0, 0xa1, 0xa1, 0xa2, 0xa3, 0xa3, 0xa4, 0xa4, 0xa5, 0xa6, 0xa6,
    0xa7, 0xa7, 0xa8, 0xa8, 0xa9, 0xaa, 0xaa, 0xab, 0xab, 0xac, 0xad, 0xad, 0xae, 0xae, 0xaf, 0xaf, 0xb0, 0xb1, 0xb1, 0xb2, 0xb2, 0xb3, 0xb3, 0xb4, 0xb5, 0xb5, 0xb6, 0xb6, 0xb7,
    0xb7, 0xb8, 0xb8, 0xb9, 0xb9, 0xba, 0xbb, 0xbb, 0xbc, 0xbc, 0xbd, 0xbd, 0xbe, 0xbe, 0xbf, 0xbf, 0xc0, 0xc0, 0xc1, 0xc1, 0xc2, 0xc2, 0xc3, 0xc3, 0xc4, 0xc4, 0xc5, 0xc5, 0xc6,
    0xc6, 0xc7, 0xc7, 0xc8, 0xc8, 0xc9, 0xc9, 0xca, 0xca, 0xcb, 0xcb, 0xcc, 0xcc, 0xcd, 0xcd, 0xce, 0xce, 0xcf, 0xcf, 0xcf, 0xd0, 0xd0, 0xd1, 0xd1, 0xd2, 0xd2, 0xd3, 0xd3, 0xd3,
    0xd4, 0xd4, 0xd5, 0xd5, 0xd6, 0xd6, 0xd7, 0xd7, 0xd7, 0xd8, 0xd8, 0xd9, 0xd9, 0xd9, 0xda, 0xda, 0xdb, 0xdb, 0xdb, 0xdc, 0xdc, 0xdd, 0xdd, 0xdd, 0xde, 0xde, 0xdf, 0xdf, 0xdf,
    0xe0, 0xe0, 0xe1, 0xe1, 0xe1, 0xe2, 0xe2, 0xe2, 0xe3, 0xe3, 0xe3, 0xe4, 0xe4, 0xe5, 0xe5, 0xe5, 0xe6, 0xe6, 0xe6, 0xe7, 0xe7, 0xe7, 0xe8, 0xe8, 0xe8, 0xe9, 0xe9, 0xe9, 0xea,
    0xea, 0xea, 0xea, 0xeb, 0xeb, 0xeb, 0xec, 0xec, 0xec, 0xed, 0xed, 0xed, 0xed, 0xee, 0xee, 0xee, 0xef, 0xef, 0xef, 0xef, 0xf0, 0xf0, 0xf0, 0xf1, 0xf1, 0xf1, 0xf1, 0xf2, 0xf2,
    0xf2, 0xf2, 0xf3, 0xf3, 0xf3, 0xf3, 0xf4, 0xf4, 0xf4, 0xf4, 0xf4, 0xf5, 0xf5, 0xf5, 0xf5, 0xf6, 0xf6, 0xf6, 0xf6, 0xf6, 0xf7, 0xf7, 0xf7, 0xf7, 0xf7, 0xf8, 0xf8, 0xf8, 0xf8,
    0xf8, 0xf9, 0xf9, 0xf9, 0xf9, 0xf9, 0xf9, 0xfa, 0xfa, 0xfa, 0xfa, 0xfa, 0xfa, 0xfb, 0xfb, 0xfb, 0xfb, 0xfb, 0xfb, 0xfb, 0xfc, 0xfc, 0xfc, 0xfc, 0xfc, 0xfc, 0xfc, 0xfc, 0xfd,
    0xfd, 0xfd, 0xfd, 0xfd, 0xfd, 0xfd, 0xfd, 0xfd, 0xfe, 0xfe, 0xfe, 0xfe, 0xfe, 0xfe, 0xfe, 0xfe, 0xfe, 0xfe, 0xfe, 0xfe, 0xff, 0xff, 0xff, 0xff, 0xff, 0xff, 0xff, 0xff, 0xff,
    0xff, 0xff, 0xff, 0xff, 0xff, 0xff, 0xff, 0xff, 0xff, 0xff, 0xff, 0xff, 0xff, 0xff, 0xff, 0xff, 0xff, 0xff, 0xff
};

//////////////////////////////////////////////////////////////////////

Random::Random(int start_seed) : seed(start_seed)
{
}

//////////////////////////////////////////////////////////////////////

int Random::next()
{
    seed = seed * 1103515245 + 12345;
    return (seed >> 16) & 0xffff;
}

//////////////////////////////////////////////////////////////////////

byte Random::next_byte()
{
    return (byte)next();
}

//////////////////////////////////////////////////////////////////////

bool Random::boolean()
{
    return next() > 32767;
}

//////////////////////////////////////////////////////////////////////

void srand(int s)
{
	default_rng.seed = s;
}

//////////////////////////////////////////////////////////////////////

int rand()
{
	return default_rng.next();
}

//////////////////////////////////////////////////////////////////////

byte rand_byte()
{
	return default_rng.next();
}

//////////////////////////////////////////////////////////////////////

int sin(int x)
{
	int lmask = x << 22 >> 31;
	int vmask = x << 21 >> 31;
	return (sine_table[(x ^ lmask) & 511] ^ vmask) - vmask;
}

//////////////////////////////////////////////////////////////////////

int tolower(int c)
{
    if(c >= 'A' && c <= 'Z') {
        return c + ('a' - 'A');
    }
    return c;
}

//////////////////////////////////////////////////////////////////////

int strlen(char const *p)
{
    char const *d = p;
    while(*p++ == 0) {
    }
    return p - d;
}

//////////////////////////////////////////////////////////////////////

int strncmp(const char *p1, const char *p2, int len)
{
    const byte *s1 = (const byte *)p1;
    const byte *s2 = (const byte *)p2;
    byte c1, c2;
    while(len-- != 0) {
        c1 = *s1++;
        c2 = *s2++;
        if (c1 == 0 || c1 != c2) {
            break;
        }
    }
    return c1 - c2;
}

//////////////////////////////////////////////////////////////////////

int strcmp(const char *p1, const char *p2)
{
    return strncmp(p1, p2, -1);
}

//////////////////////////////////////////////////////////////////////

int strchr(char const *p, int ch)
{
    char const *s = p;
    while(true) {
        char c = *s++;
        if(c == ch) {
            break;
        }
        if(c == 0) {
            s -= 1;
            break;
        }
    }
    return s - p;
}

//////////////////////////////////////////////////////////////////////

uint32 atohex(char const *str)
{    
    uint32 val = 0;

    while(*str) {
        char c = tolower(*str++);
        val <<= 4;
        if(c >= '0' && c <= '9') {
            val |= (c - '0');
        }
        else if(c >= 'a' && c <= 'f') {
            val |= (c - ('a' - 10));
        }
    }
    return val;
}

//////////////////////////////////////////////////////////////////////

int atoi(char const *str)
{
    int res = 0;
    int sign = 0;
      
    if (*str == '-') {
        sign = -1;  
        str += 1;
    }

    while(*str != 0) {
        res = res * 10 + *str++ - '0';
    }
    return (res ^ sign) - sign;
}

//////////////////////////////////////////////////////////////////////

// 2x - x^2 - ease in
// 1 - (2(1-x)-((1-x)^2)) - ease out
// 3(x^2) - 2(x^3) - ease in-out

int ease(int x)
{
    //3(x^2) - 2(x^3)
    int x2 = (x * x) >> 8;
    int x3 = (x2 * x) >> 8;
    return x2 * 3 - x3 * 2;
}
