cskilbeck/xtl/(commit log)

2020-04-22 pcb: new controller_esp8266 with psu and fet
    [controller_8266.PrjPcb, controller_8266.SchDoc, controller_8266.SchLib, controller_8266_psu.SchDoc]
2020-04-22 pcb: controller_esp8266 2.0
    [controller_8266.PrjPcb, controller_8266.SchDoc, controller_8266.SchLib, controller_8266_psu.SchDoc]
2020-05-03 pcb: remove log
2020-05-03 pcb: controller_8266 rev 2
    [controller_8266.PrjPcb, controller_8266.SchDoc, controller_8266.SchLib, controller_8266_psu.SchDoc, controller_8266_switch.SchDoc]
2020-05-03 pcb: controller_esp8266 bomdoc
2020-05-08 pcb: noodle
    [controller_8266.SchDoc, controller_8266_psu.SchDoc, psu.xlsx]
2020-05-16 pcb: controller_8266 - new buck
    [controller_8266.SchDoc, controller_8266.SchLib, controller_8266_psu.SchDoc, controller_8266_switch.SchDoc, psu.xlsx]
2020-05-17 pcb: controller_8266 noodle
    [controller_8266.SchDoc, controller_8266.SchLib, controller_8266_psu.SchDoc]
2020-05-17 pcb: 8226 noodle
2020-05-17 pcb: 8266 noodle
    [controller_8266.SchDoc, controller_8266.SchLib, controller_8266_psu.SchDoc, controller_8266_switch.SchDoc]
2020-05-19 pcb: 8266 AD20 upgrade
    [controller_8266.PrjPcb, controller_8266.SchDoc, controller_8266.SchLib, controller_8266_psu.SchDoc]
2020-05-20 pcb: 8266 ad20
    [controller_8266.PrjPcb, controller_8266.SchDoc, controller_8266_psu.SchDoc, controller_8266_switch.SchDoc]
2020-05-28 aisler01 then noodle
    [Bill of Materials-controller_8266.xlsx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]
2020-06-03 +buck4, fix controller
    [0805.stp, 1206.stp, 2020-05-30_00-24-19.PcbLib, 2020-05-30_00-24-19.SchLib, 2020-05-30_00-24-191.schdoc, 7343-15.stp, Bill of Materials-buck4.xlsx, Bill of Materials-controller_8266.xlsx]
2020-06-22 buck4 v2
    [Bill of Materials-buck4.xlsx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]
2020-06-23 JLCPCB_23062020 big ORDER buck4 + controller_8266
    [Bill of Materials-controller_8266.xlsx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]
2020-06-23 pcb: project
    [controller_8266.PrjPcb]
2020-07-26 make power switch functional
2020-07-28 buck4 aisler w.stencil
    [Bill of Materials-buck4.xlsx, Bill of Materials-controller_8266.xlsx, Pick Place for buck4.csv, buck4.PcbDoc, buck4.PcbLib, buck4.PrjPcb, buck4.SchLib, buck4.schdoc]
2020-08-11 controller button
    [controller_8266.SchDoc, controller_8266.SchLib]
2020-08-14 controller_8266 aisler
    [Bill of Materials-controller_8266.xlsx, Pick Place for controller_8266.csv, buck4.PcbDoc, buck4.schdoc, controller_8266.PrjPcb, controller_8266.SchDoc, controller_8266.SchLib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]
2020-08-16 add texture maps for controller_8266, buck4
2020-08-23 prepare for enclosure
    [Bill of Materials-controller_8266.xlsx, controller_8266.PrjPcb]
2020-08-27 controller_8266 final?
    [controller_8266.PrjPcb, controller_8266.SchDoc, controller_8266.SchLib, controller_8266_psu.SchDoc, controller_8266_switch.SchDoc]
2020-08-27 buck4 sch tweak
    [buck4.schdoc]
2020-08-27 new ldo
    [controller_8266.SchDoc, controller_8266.SchLib]
2020-08-31 fw:add controller_8266 power limiter
2020-08-31 pcb: controller_8266 assembly bom
    [Bill of Materials-buck4 assembly.xlsx]
2024-12-22 firmware fixes
    button is on GPIO14
    rgb leds on GPIO12,13,16
    5 second button to reset wifi credentials
    fix wifi code
    [button.cpp, debug.cpp, hello_world_main.cpp, wifi.cpp, wifi.h]
2024-12-22 bigger controller PCB
    [controller_8266.PrjPcb, controller_8266.SchDoc, controller_8266.SchLib, controller_8266_psu.SchDoc, controller_8266_switch.SchDoc]
2024-12-22 new enclosure
    [M2 x10mm_countersunk.step, M2x0.4mm+12mmSCREW.STEP, M2x12mm_countersunk.step, bottom.STEP, case.SLDPRT, enclosure.SLDASM, m2 x10mm_countersunk.SLDPRT, m2x12.SLDPRT]
2024-12-29 controller spread out a bit
    [Bill of Materials-controller_8266.xlsx, controller_8266.SchDoc, controller_8266.SchLib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]
